Nkyoku/phoenix-pcb/README.md

# phoenix-pcb
A Main circuit board for the Robocup SSL machine

[Schematics](Schematics.pdf)  
[Firmware](https://github.com/Nkyoku/phoenix-firmware)  
[Wiki](https://github.com/Nkyoku/phoenix-pcb/wiki)  
[解説ブログ](https://blankalilio.blogspot.com/2020/11/phoenix_15.html)
