Nkyoku/phoenix-pcb/Schematics.pdf

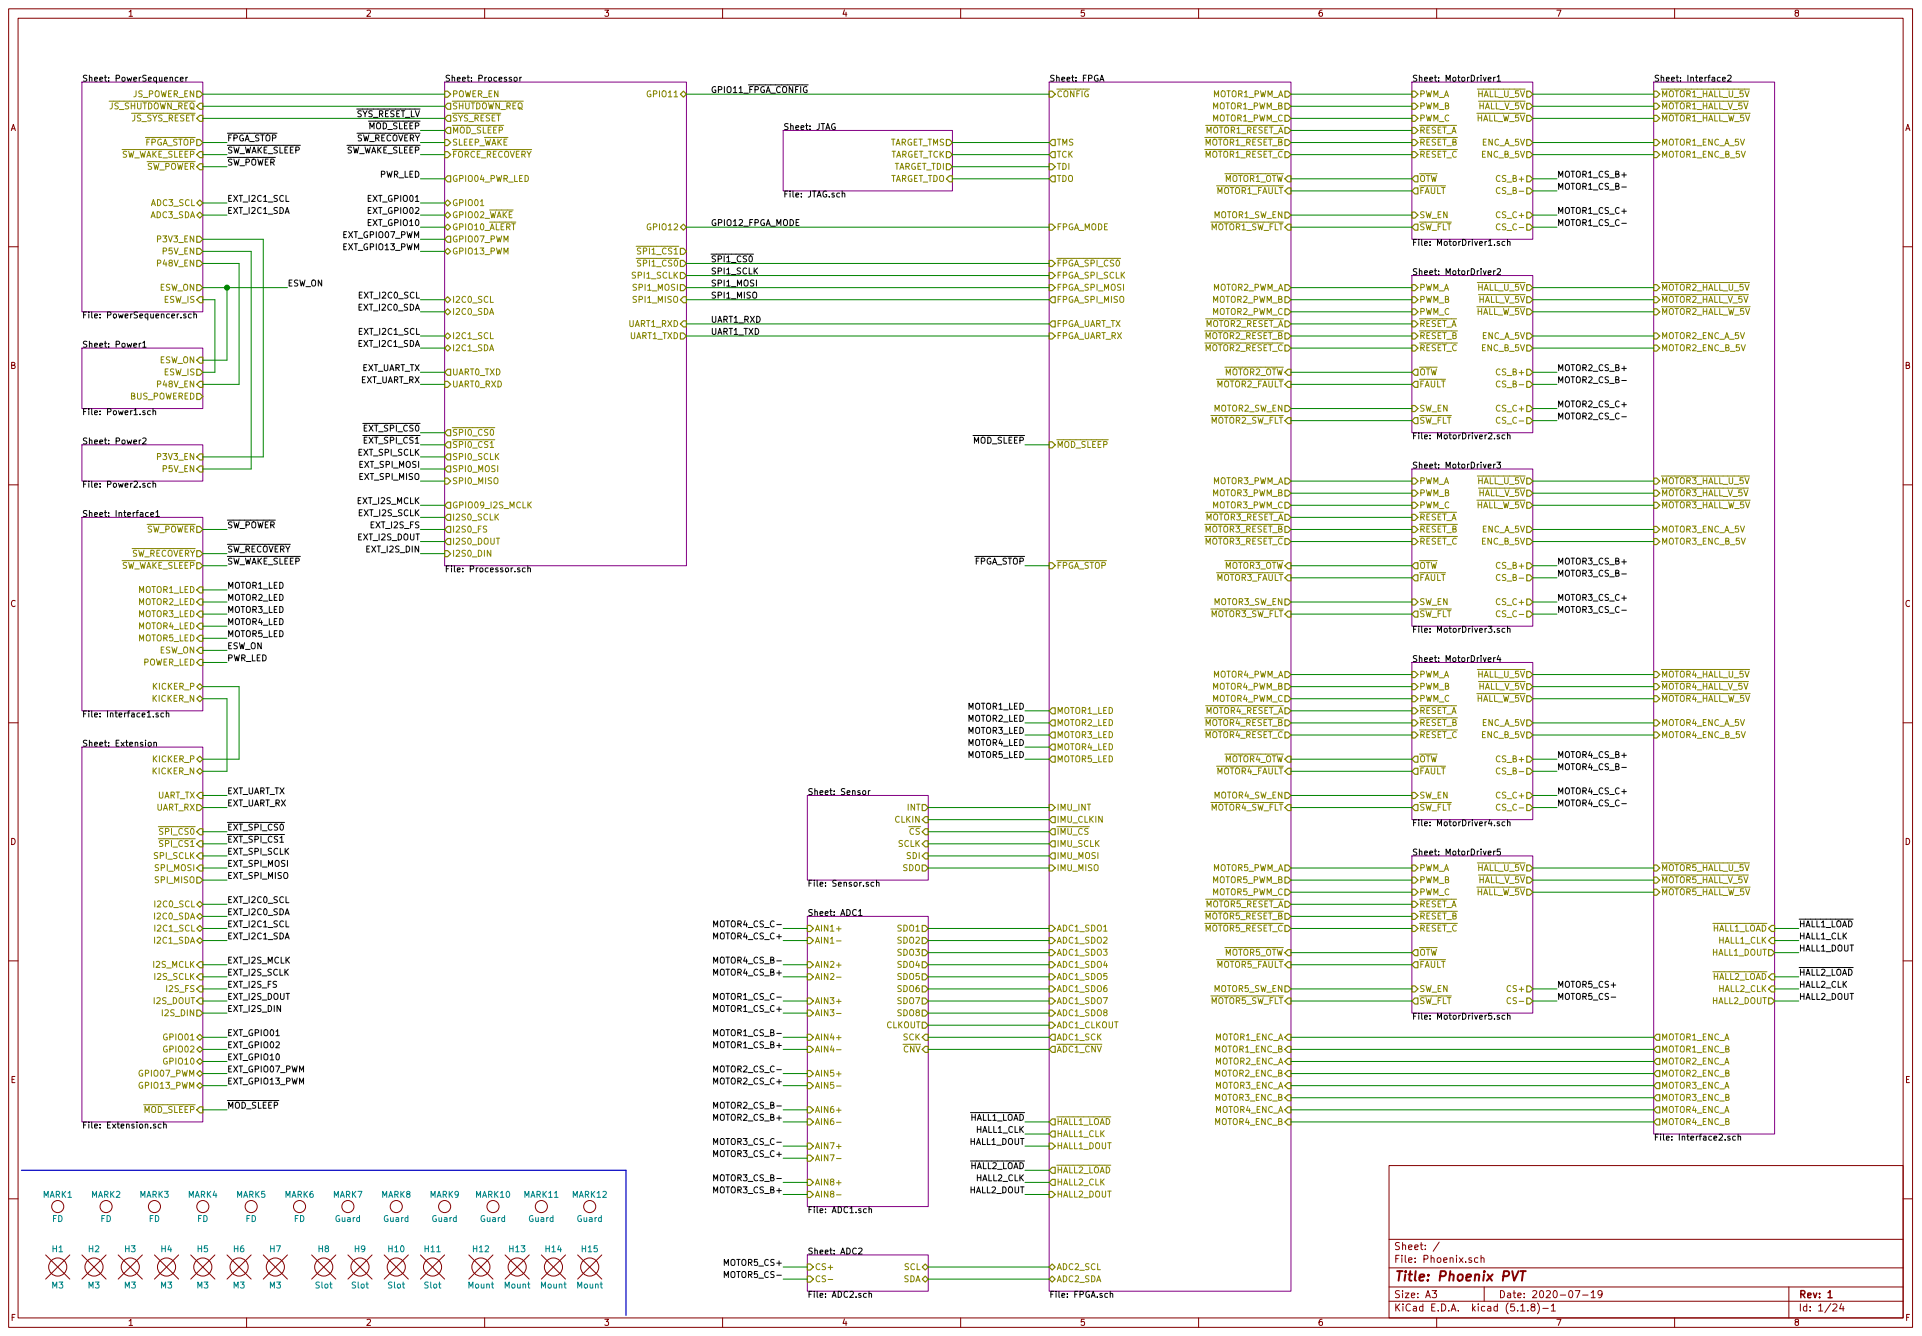
[picture p1: page 1]

File: Phoenix.sch Sheet: /
Id: 1/24 Title: Phoenix PVT

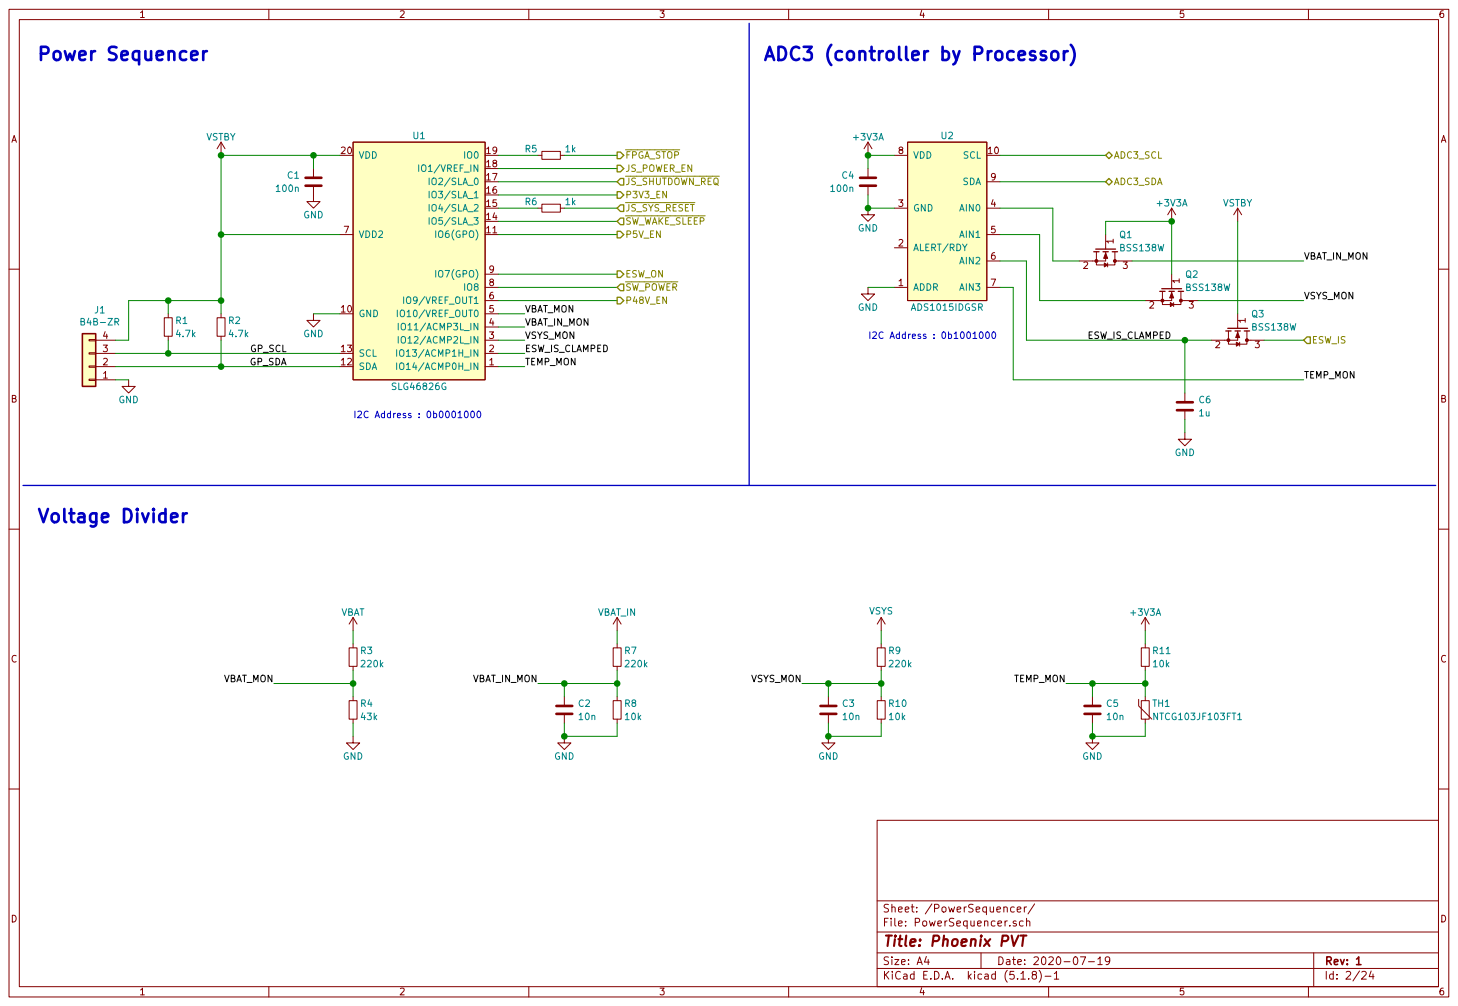
[picture p2: page 2]

File: PowerSequencer.sch
Id: 2/24 Title: Phoenix PVT

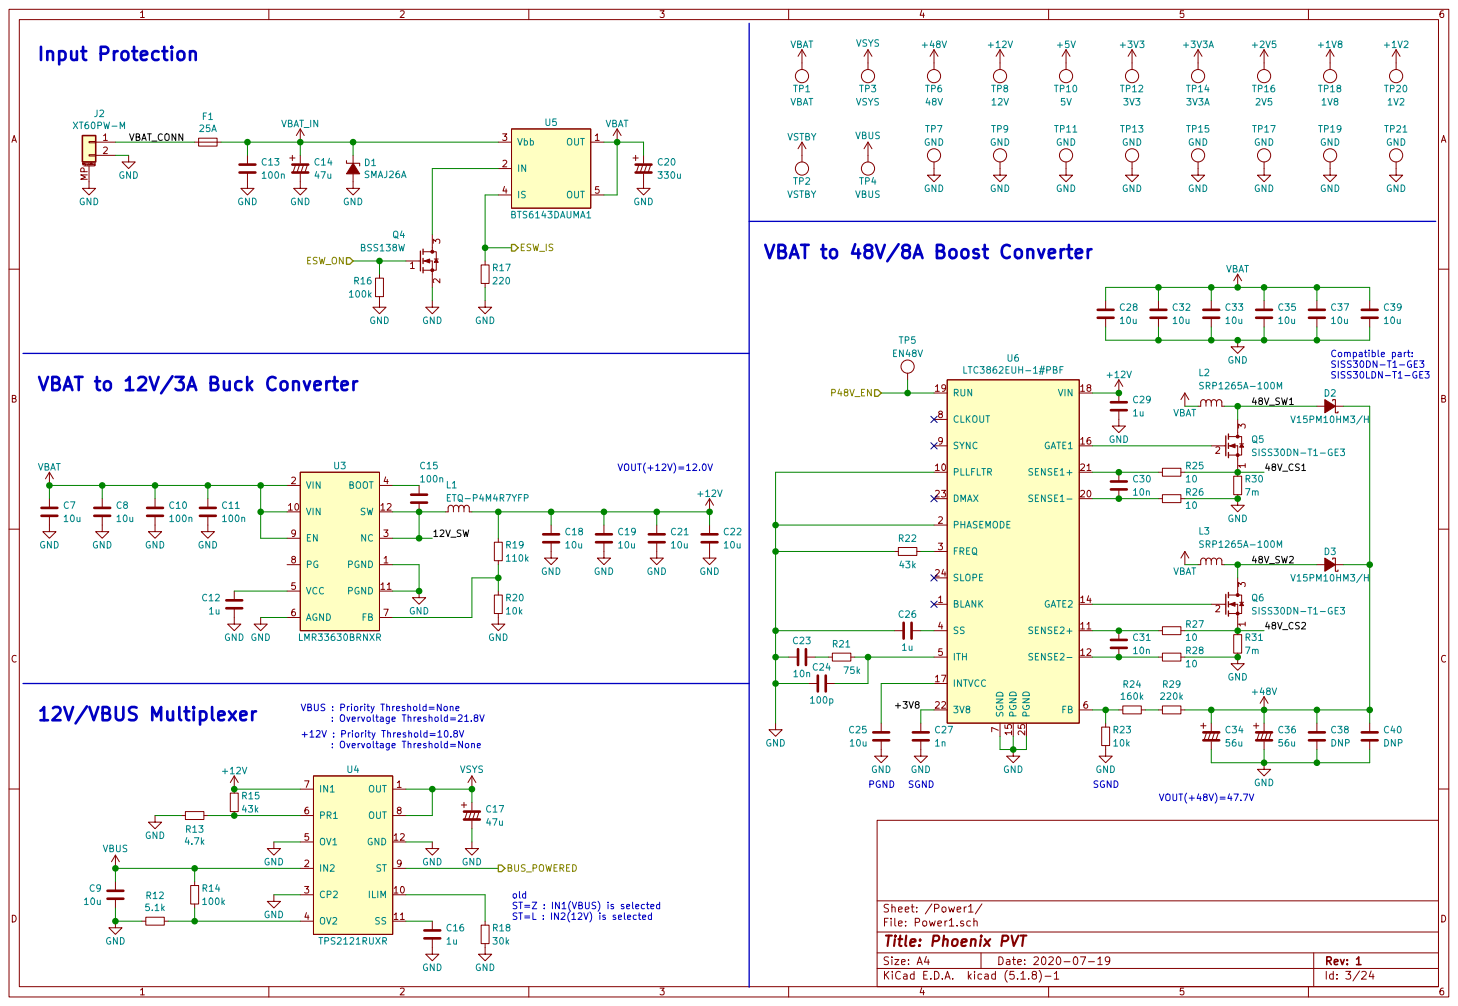
[picture p3: page 3]

Compatible part: SISS30DN-T1-GE3 SISS30LDN-T1-GE3 Input Protection

48V_SW1 SGND VBAT to 48V/8A Boost Converter

VBAT to 12V/3A Buck Converter

VBUS : Priority Threshold=None
: Overvoltage Threshold=21.8V
+12V : Priority Threshold=10.8V
: Overvoltage Threshold=None

old ST=Z : IN1(VBUS) is selected

File: Power1.sch Sheet: /Power1/
Id: 3/24 Title: Phoenix PVT

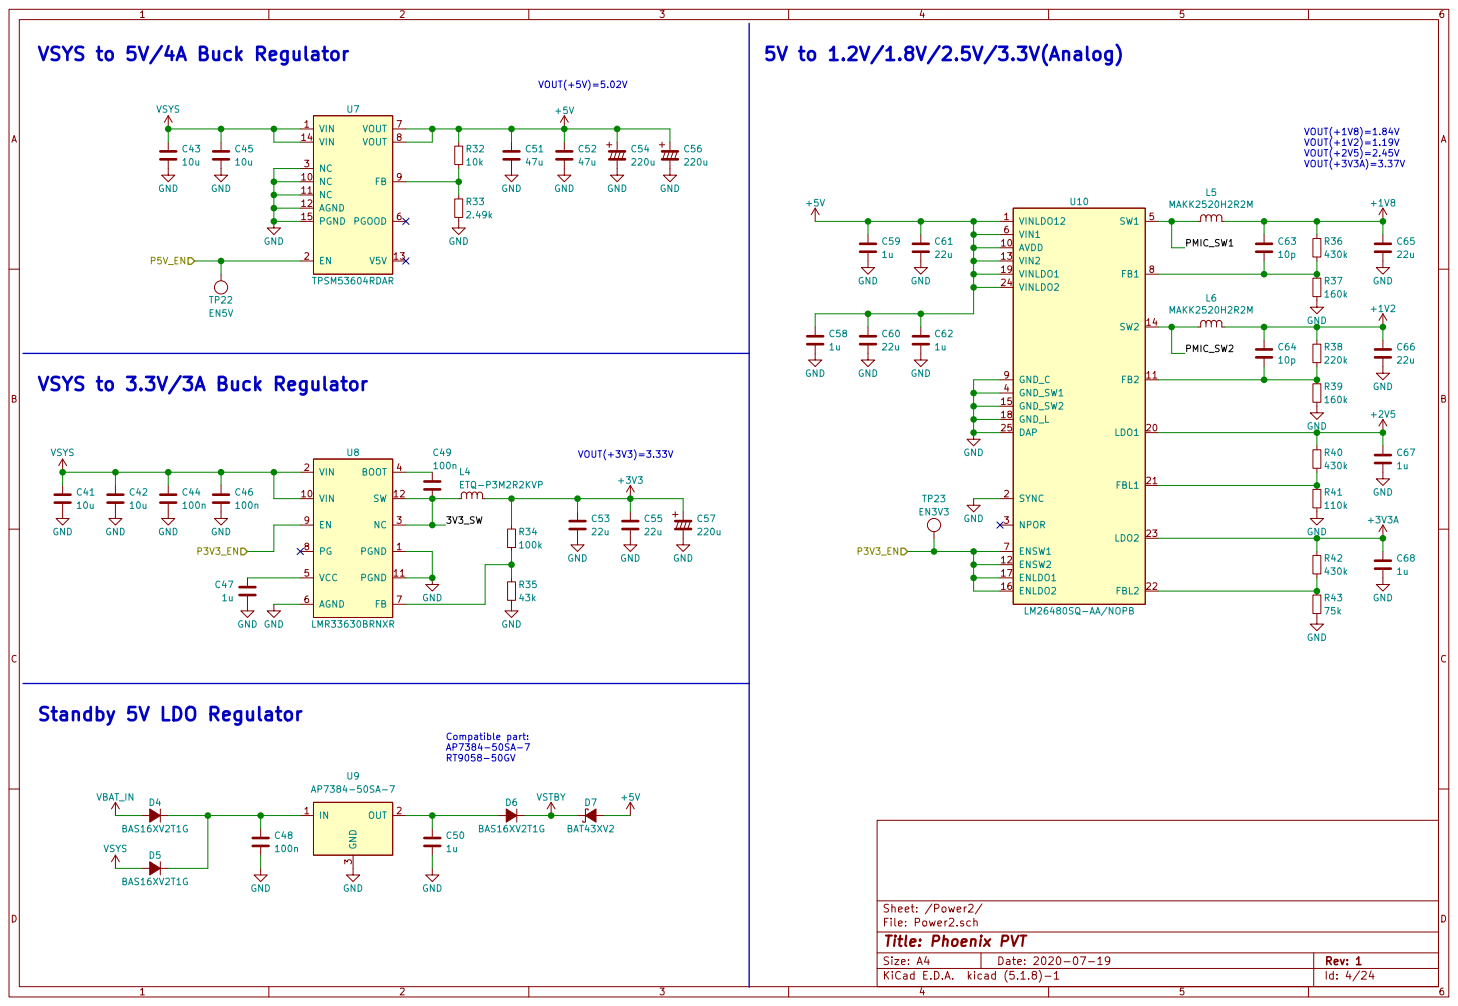
[picture p4: page 4]

VSYS to 5V/4A Buck Regulator

VSYS to 3.3V/3A Buck Regulator

Compatible part: AP7384-50SA-7 RT9058-50GV Standby 5V LDO Regulator

Id: 4/24 Title: Phoenix PVT

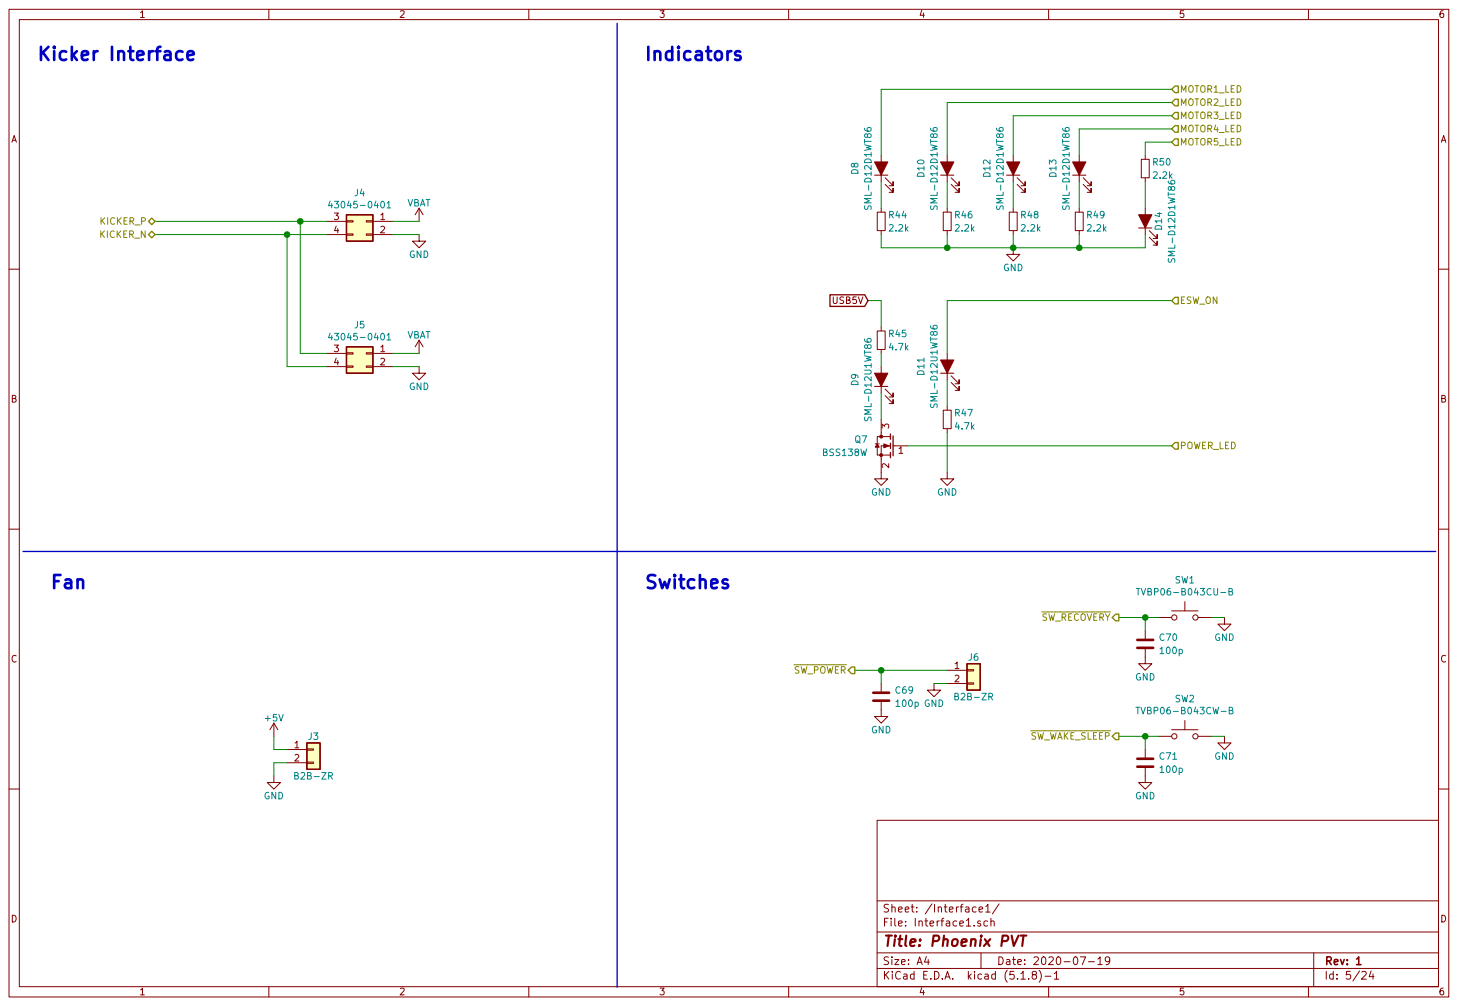
[picture p5: page 5]

Id: 5/24 Title: Phoenix PVT

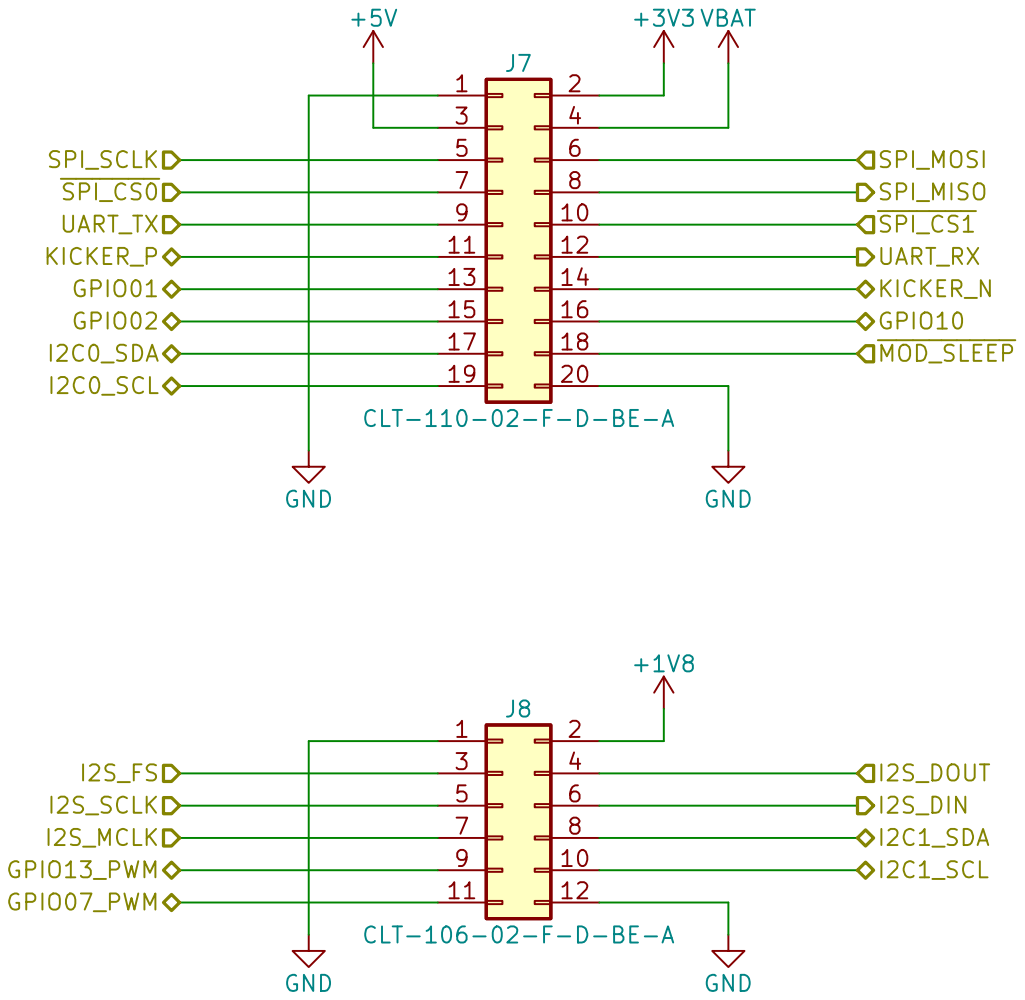
[picture p6: page 6]

Id: 6/24 Title: Phoenix PVT

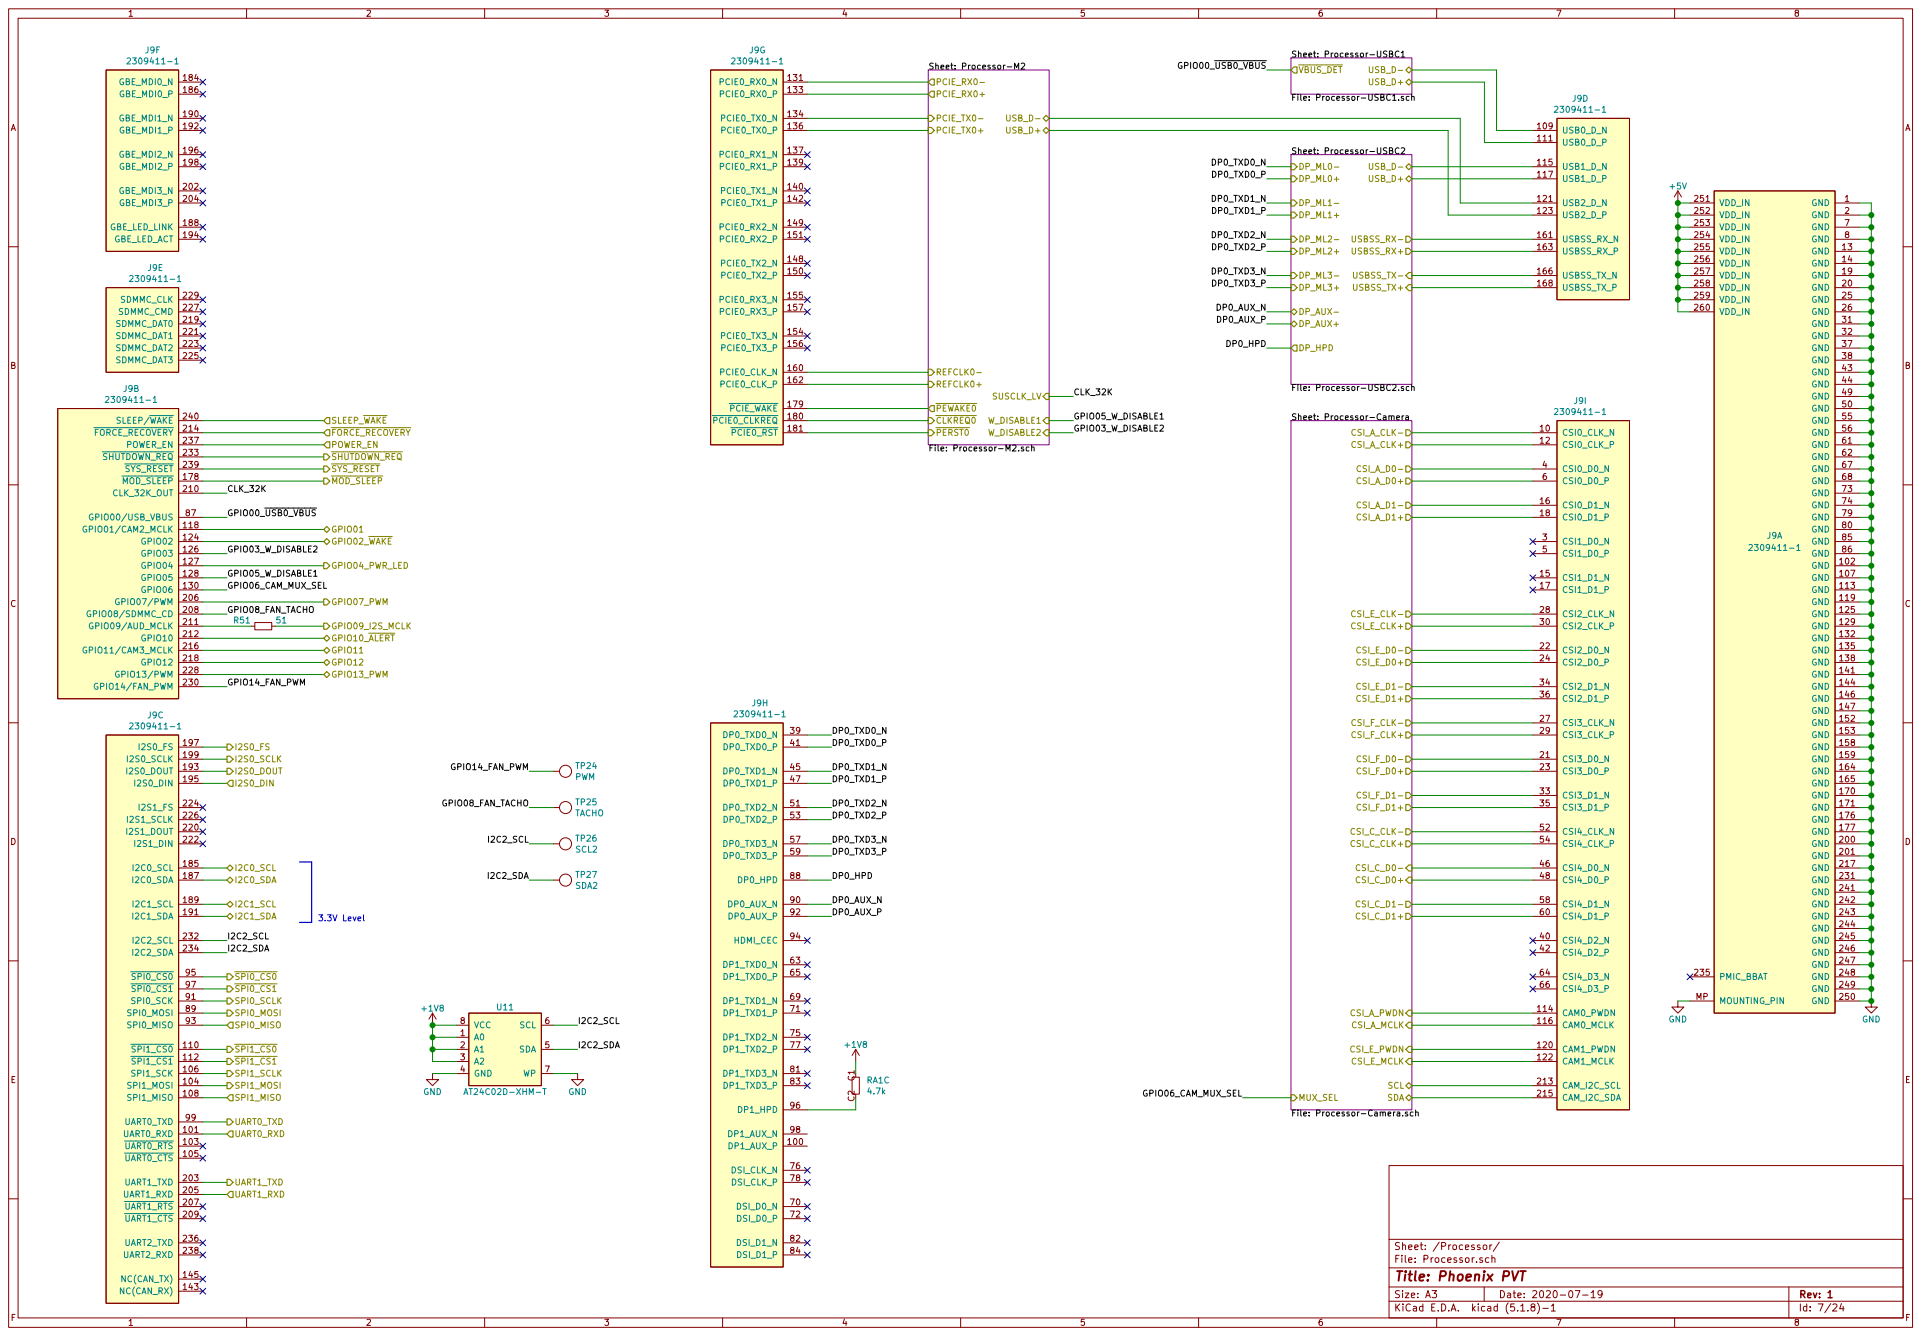
[picture p7: page 7]

File: Processor-Camera.sch

File: Processor.sch Sheet: /Processor/
Id: 7/24 Title: Phoenix PVT

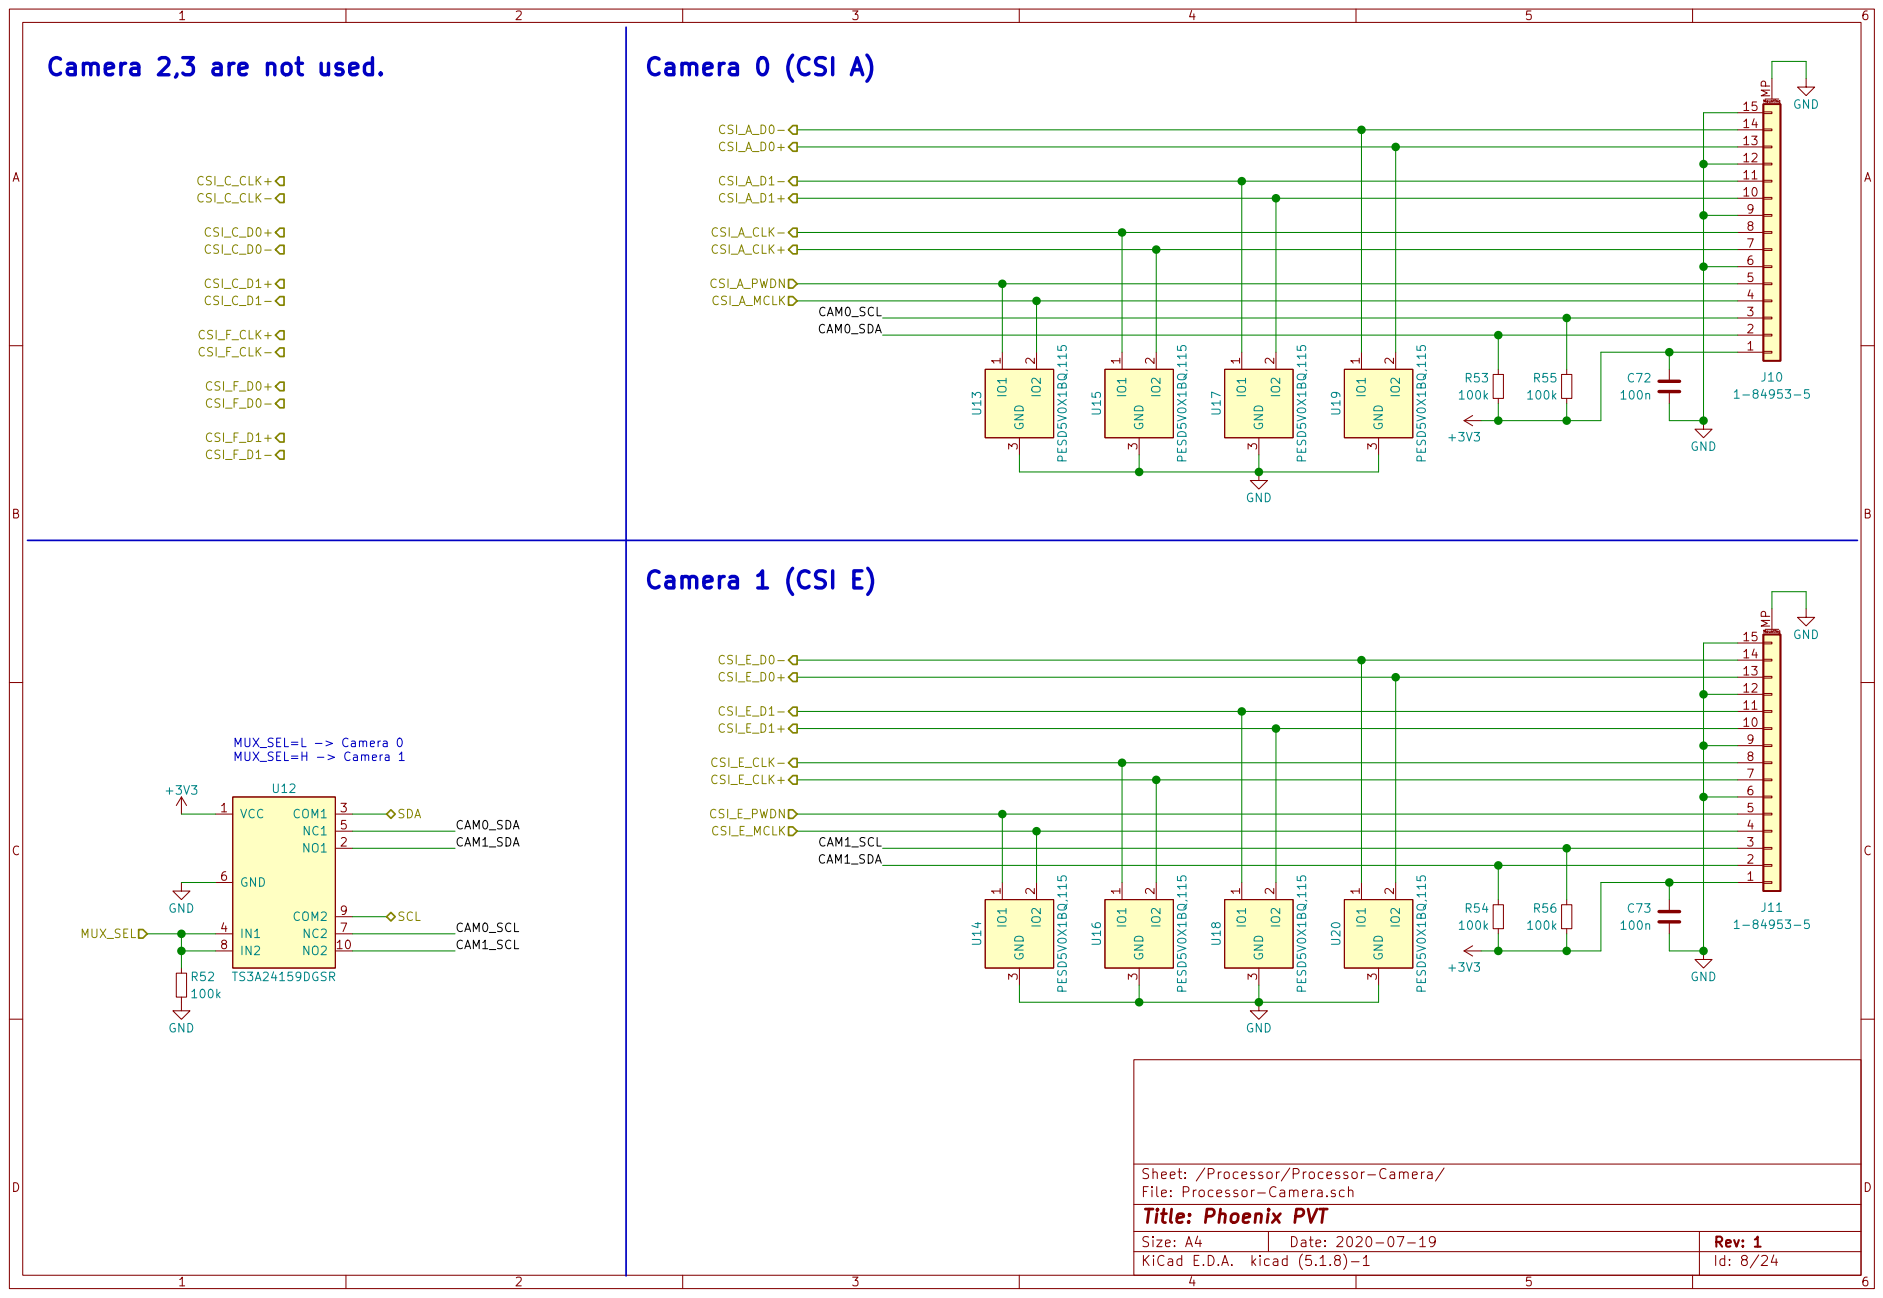
[picture p8: page 8]

File: Processor-Camera.sch Sheet: /Processor/Processor-Camera/
Id: 8/24 Title: Phoenix PVT

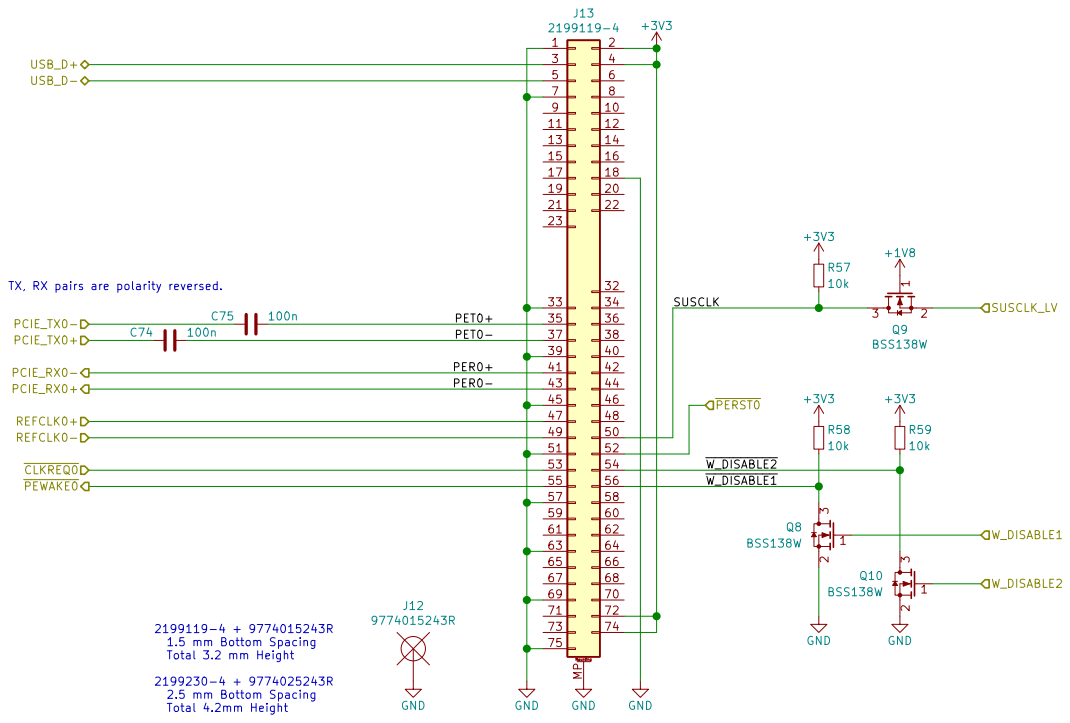
[picture p9: page 9]

35 | | 36
37 | | 38
39 | | 40

53 55 57 | 54
56
58

71 73 75 | 72
74

Id: 9/24 Title: Phoenix PVT

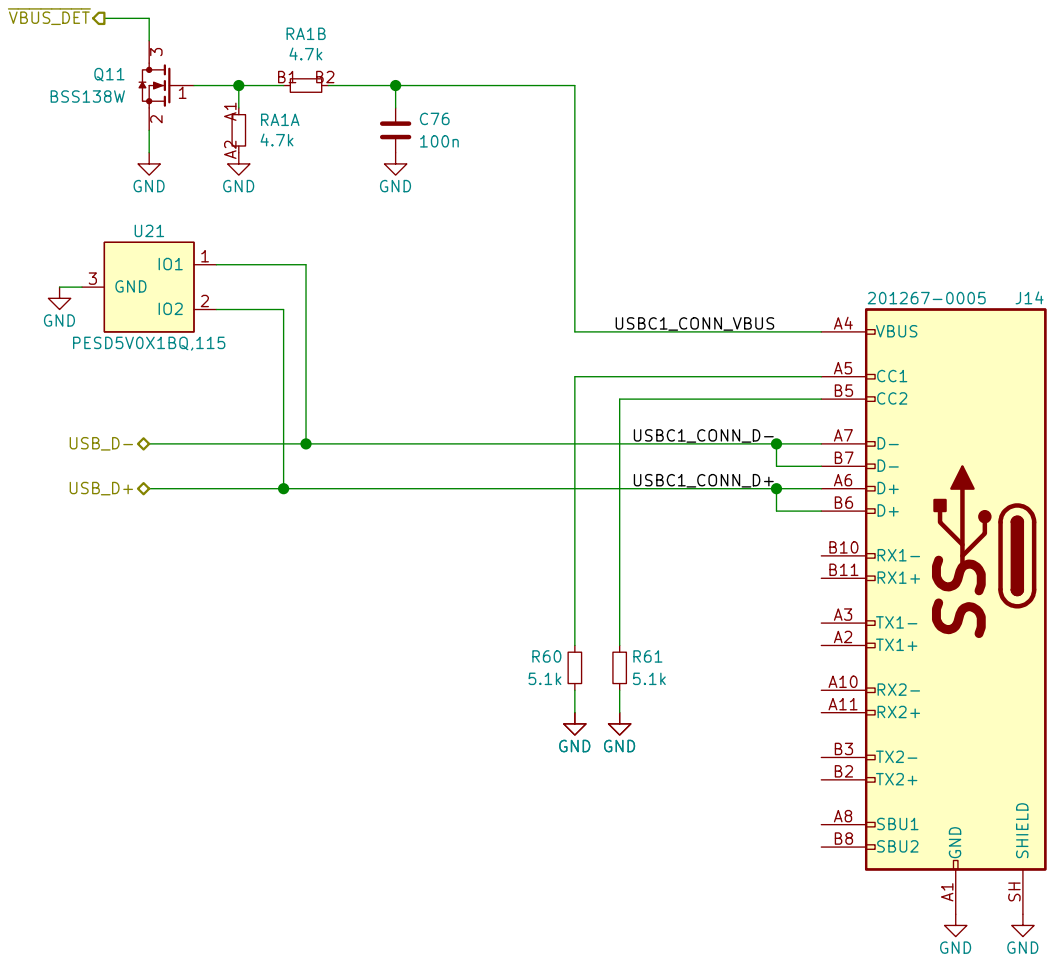
[picture p10: page 10]

File: Processor-USBC1.sch Sheet: /Processor/Processor-USBC1/
Id: 10/24 Title: Phoenix PVT

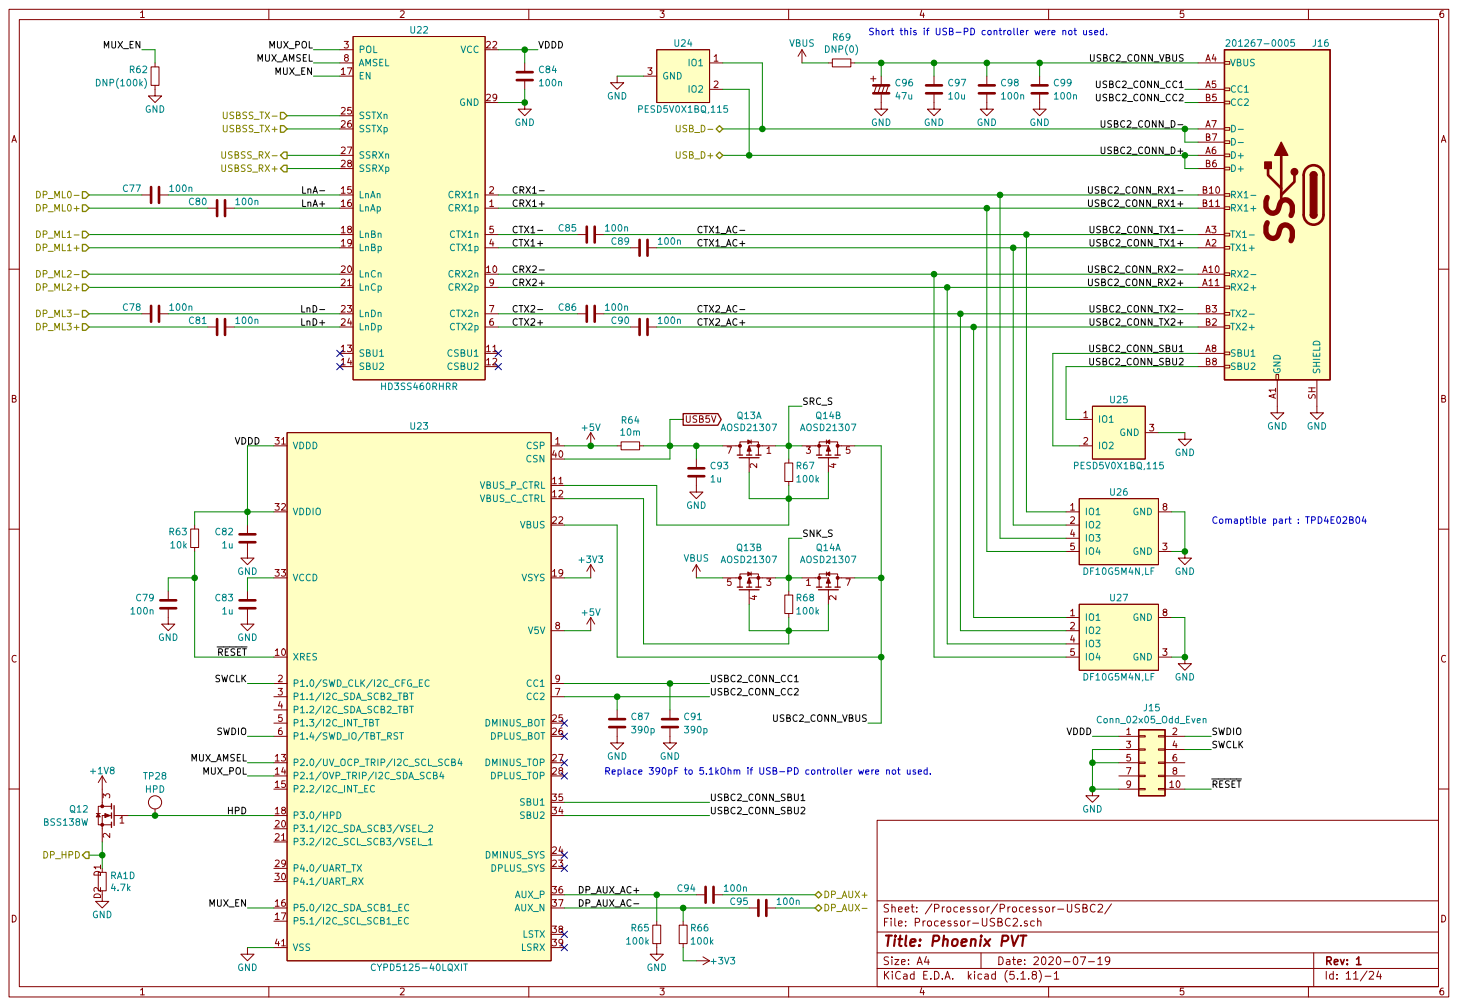
[picture p11: page 11]

Short this if USB-PD controller were not used.

File: Processor-USBC2.sch Sheet: /Processor/Processor-USBC2/ R68

Replace 390pF to 5.1kOhm if USB-PD controller were not used.

Id: 11/24 Title: Phoenix PVT

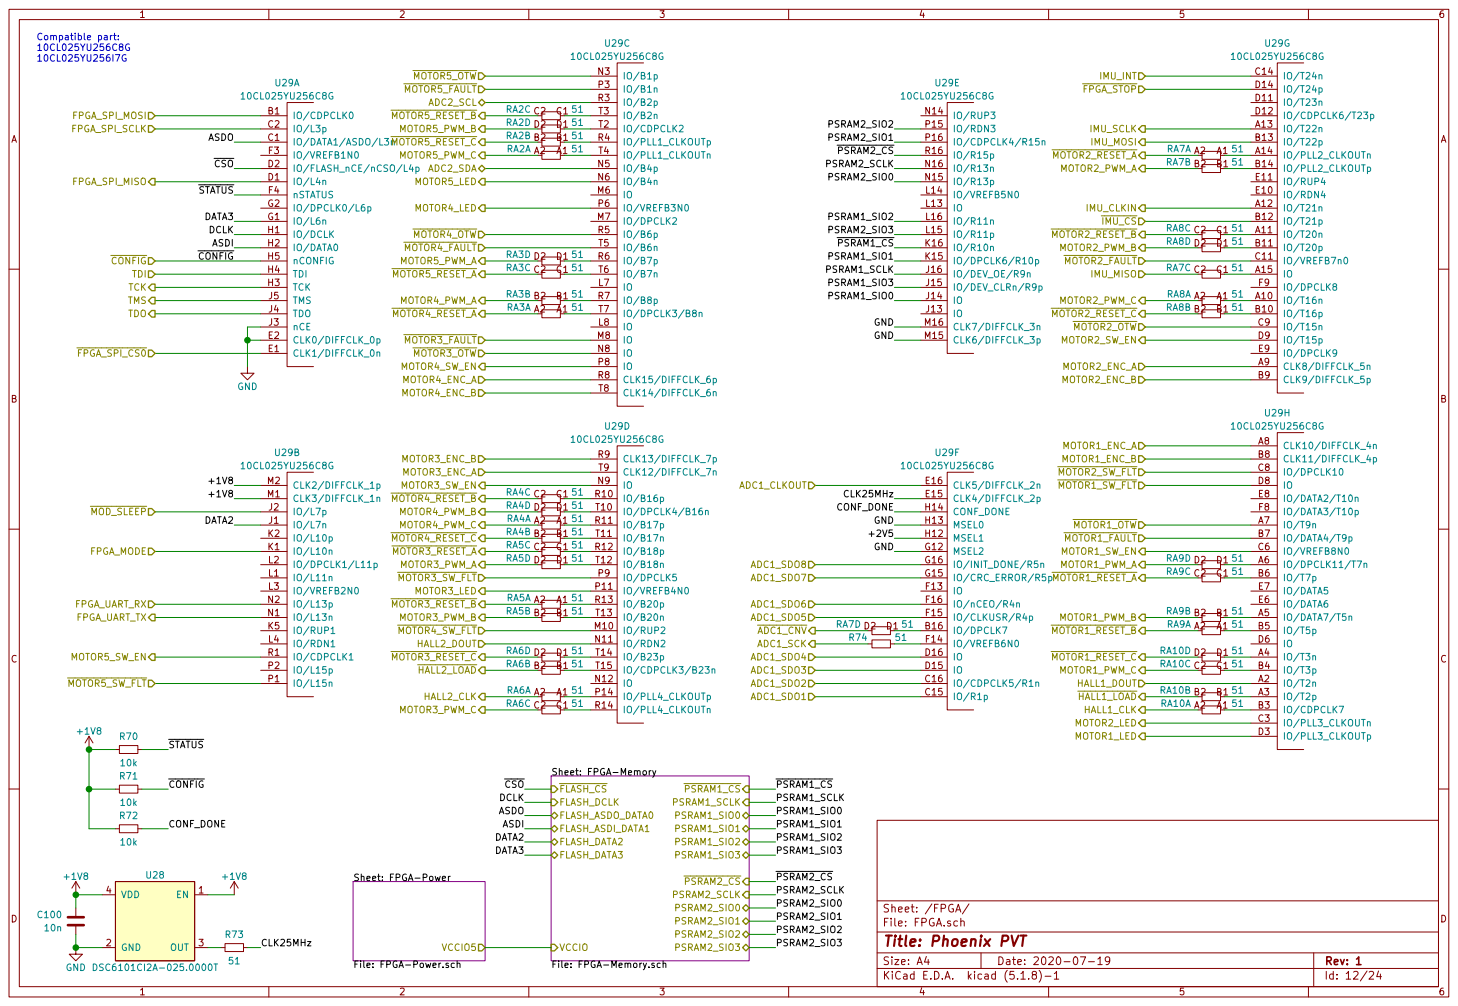
[picture p12: page 12]

File: FPGA.sch Sheet: /FPGA/ Sheet: FPGA-Memory
File: FPGA-Memory.sch FLASH_CS
FLASH_DCLK

Id: 12/24 Title: Phoenix PVT

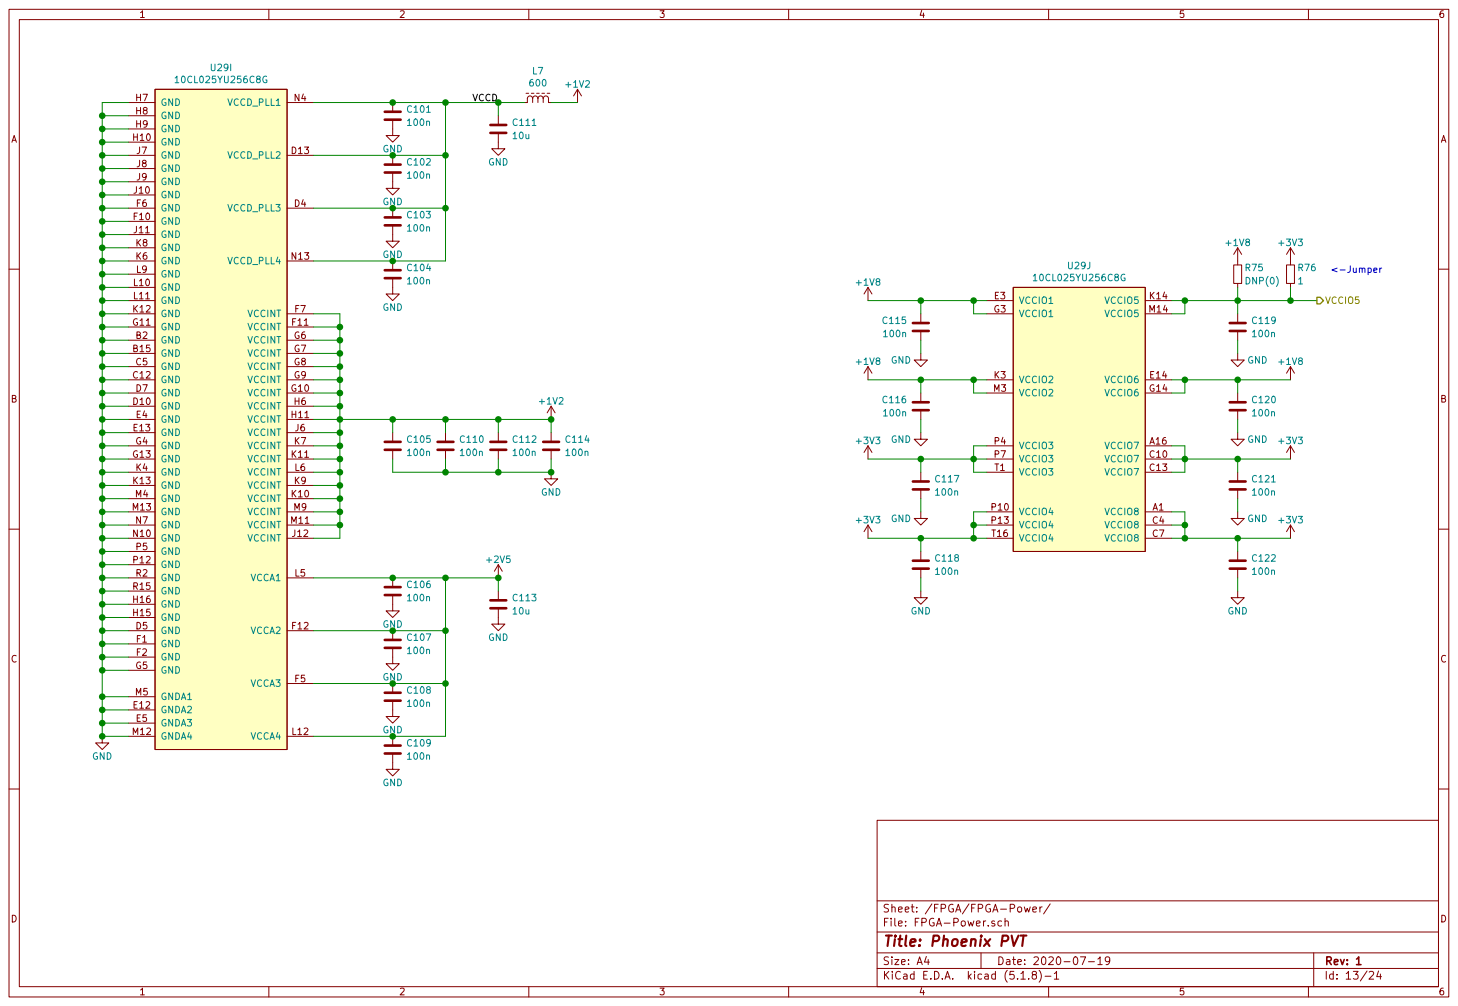
[picture p13: page 13]

File: FPGA-Power.sch Sheet: /FPGA/FPGA-Power/
Id: 13/24 Title: Phoenix PVT

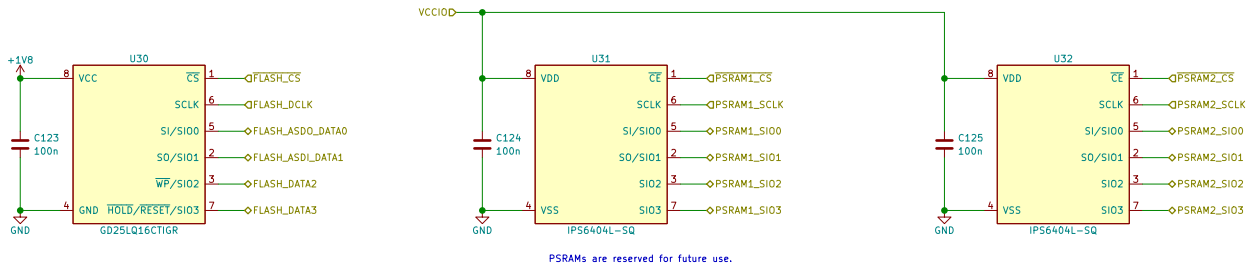
[picture p14: page 14]

Sheet: /FPGA/FPGA-Memory/ C124

PSRAM2_SIO0 PSRAM2_SIO1 PSRAM2_SIO2 PSRAM2_SIO3 PSRAMs are reserved for future use.

File: FPGA-Memory.sch
Id: 14/24 Title: Phoenix PVT

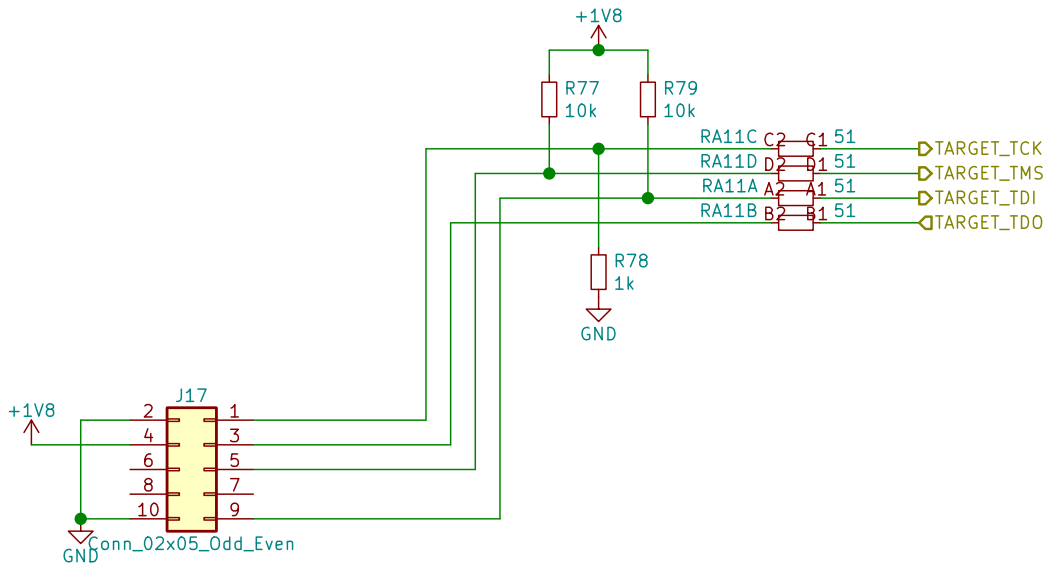
[picture p15: page 15]

File: JTAG.sch Sheet: /JTAG/
Id: 15/24 Title: Phoenix PVT

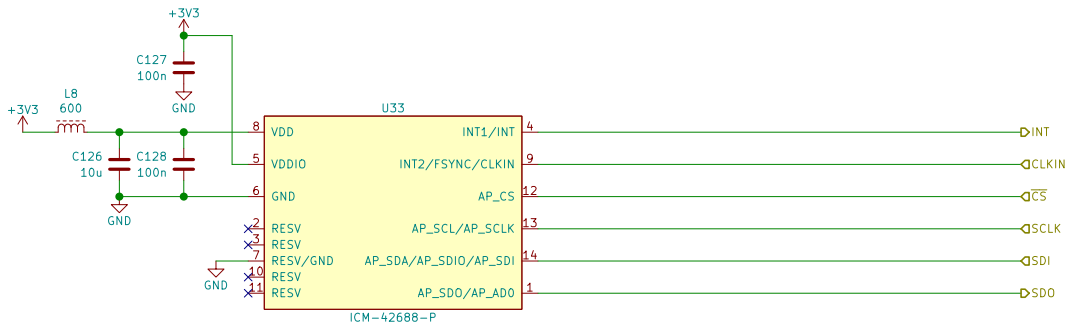
[picture p16: page 16]

File: Sensor.sch Sheet: /Sensor/
Id: 16/24 Title: Phoenix PVT

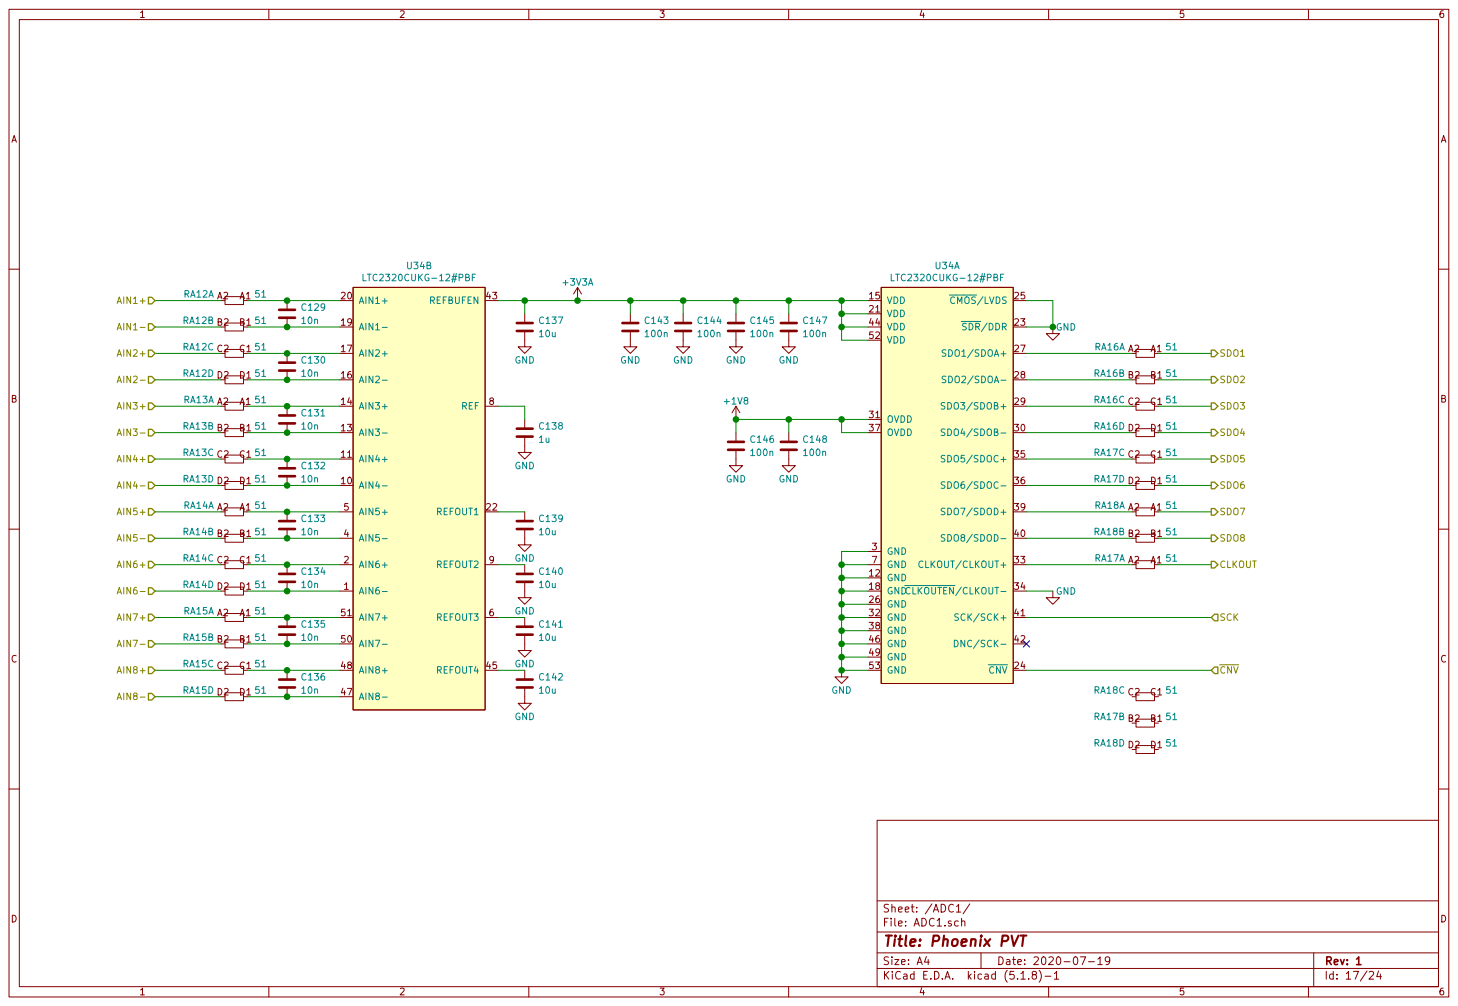
[picture p17: page 17]

File: ADC1.sch Sheet: /ADC1/
Id: 17/24 Title: Phoenix PVT

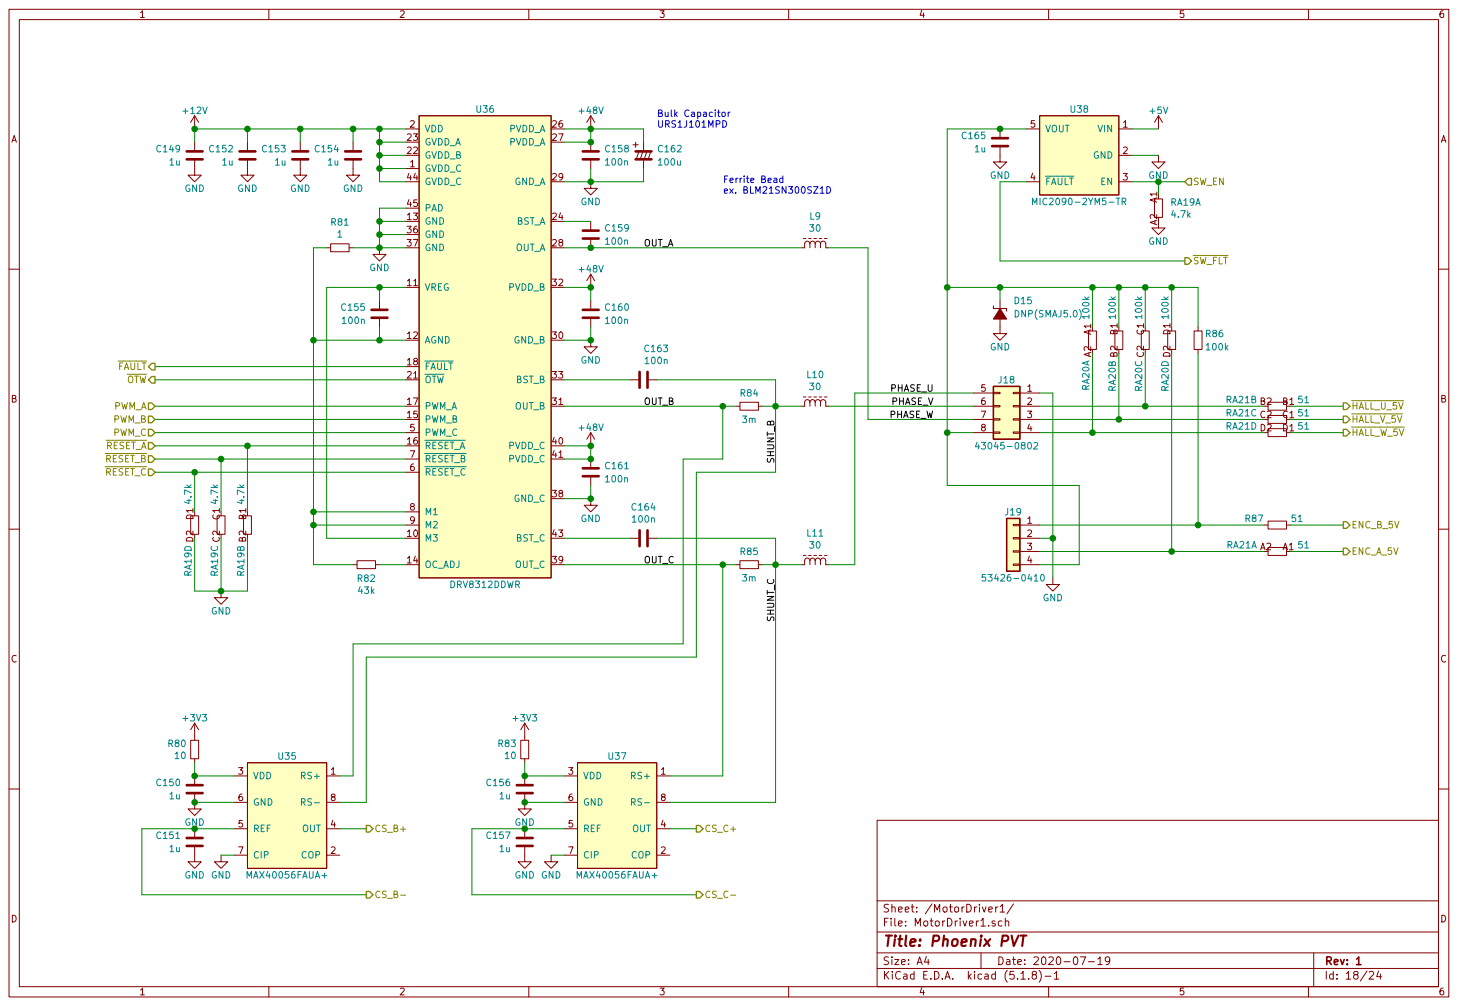
[picture p18: page 18]

PHASE_V | 6 7 | 2

Id: 18/24 Title: Phoenix PVT

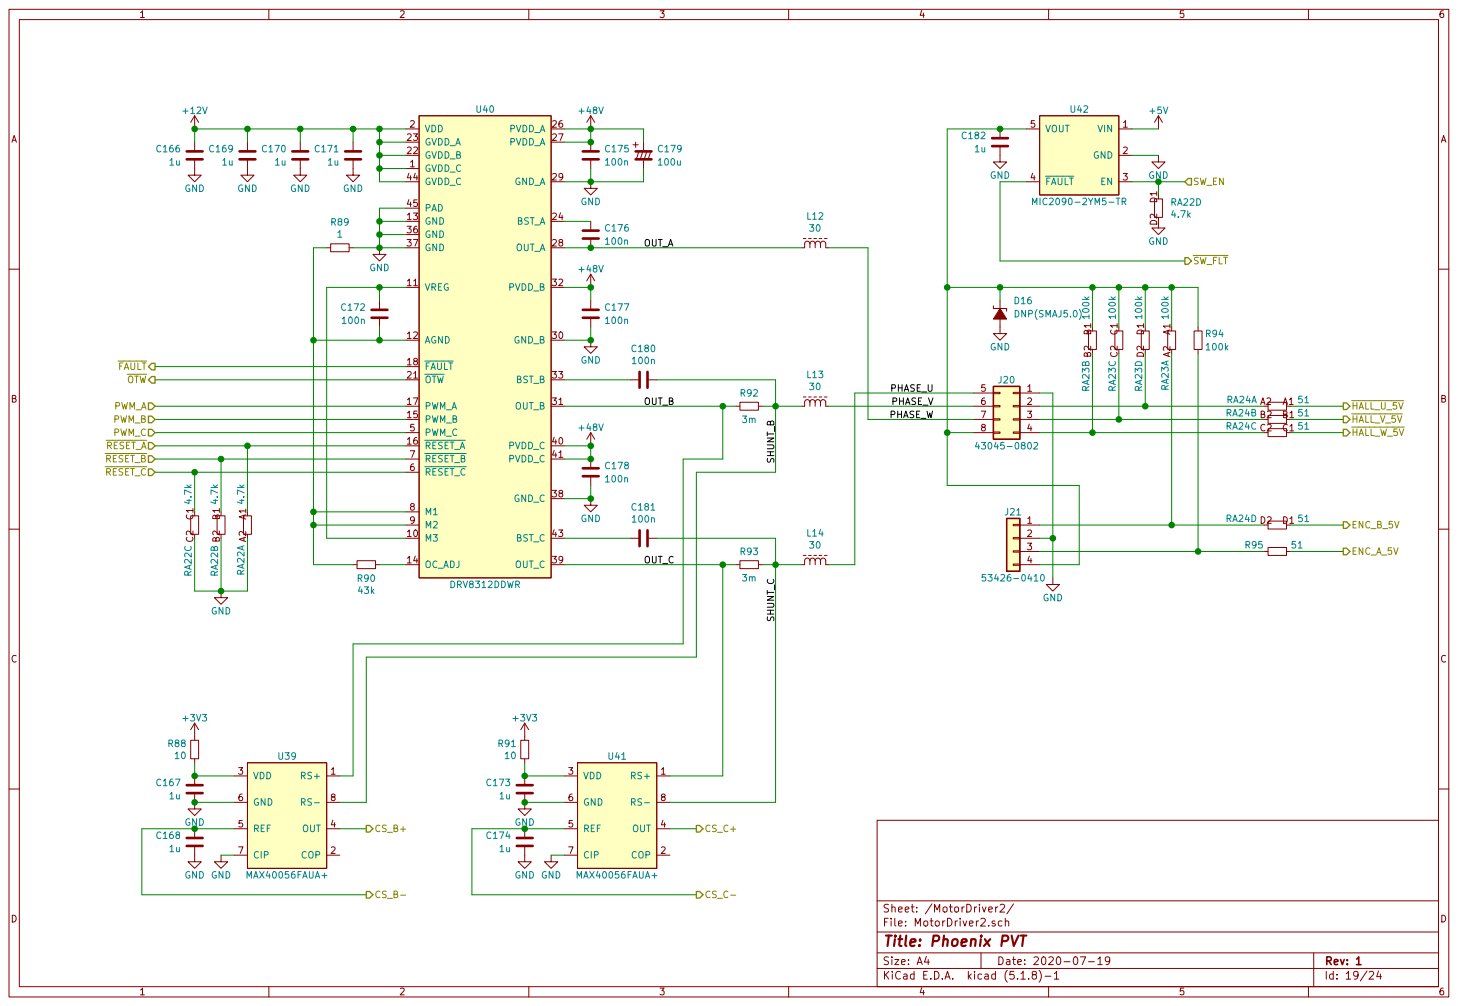
[picture p19: page 19]

PHASE_V PHASE_W | 6 7 | 2

File: MotorDriver2.sch Sheet: /MotorDriver2/
Id: 19/24 Title: Phoenix PVT

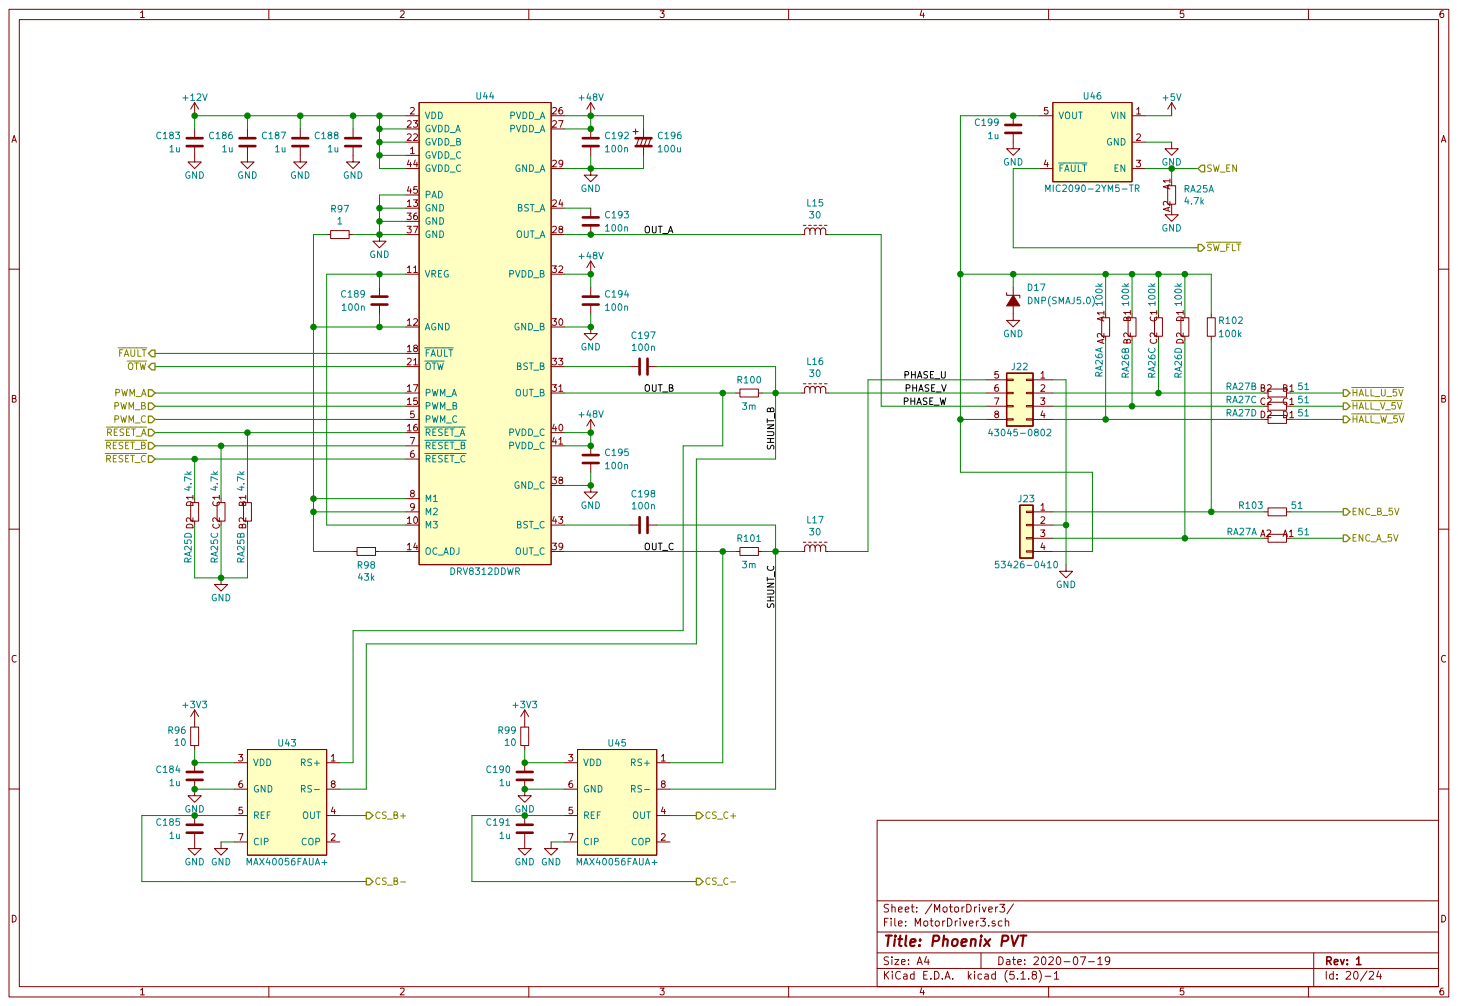
[picture p20: page 20]

PHASE_V | 6 7 | 2

File: MotorDriver3.sch Sheet: /MotorDriver3/
Id: 20/24 Title: Phoenix PVT

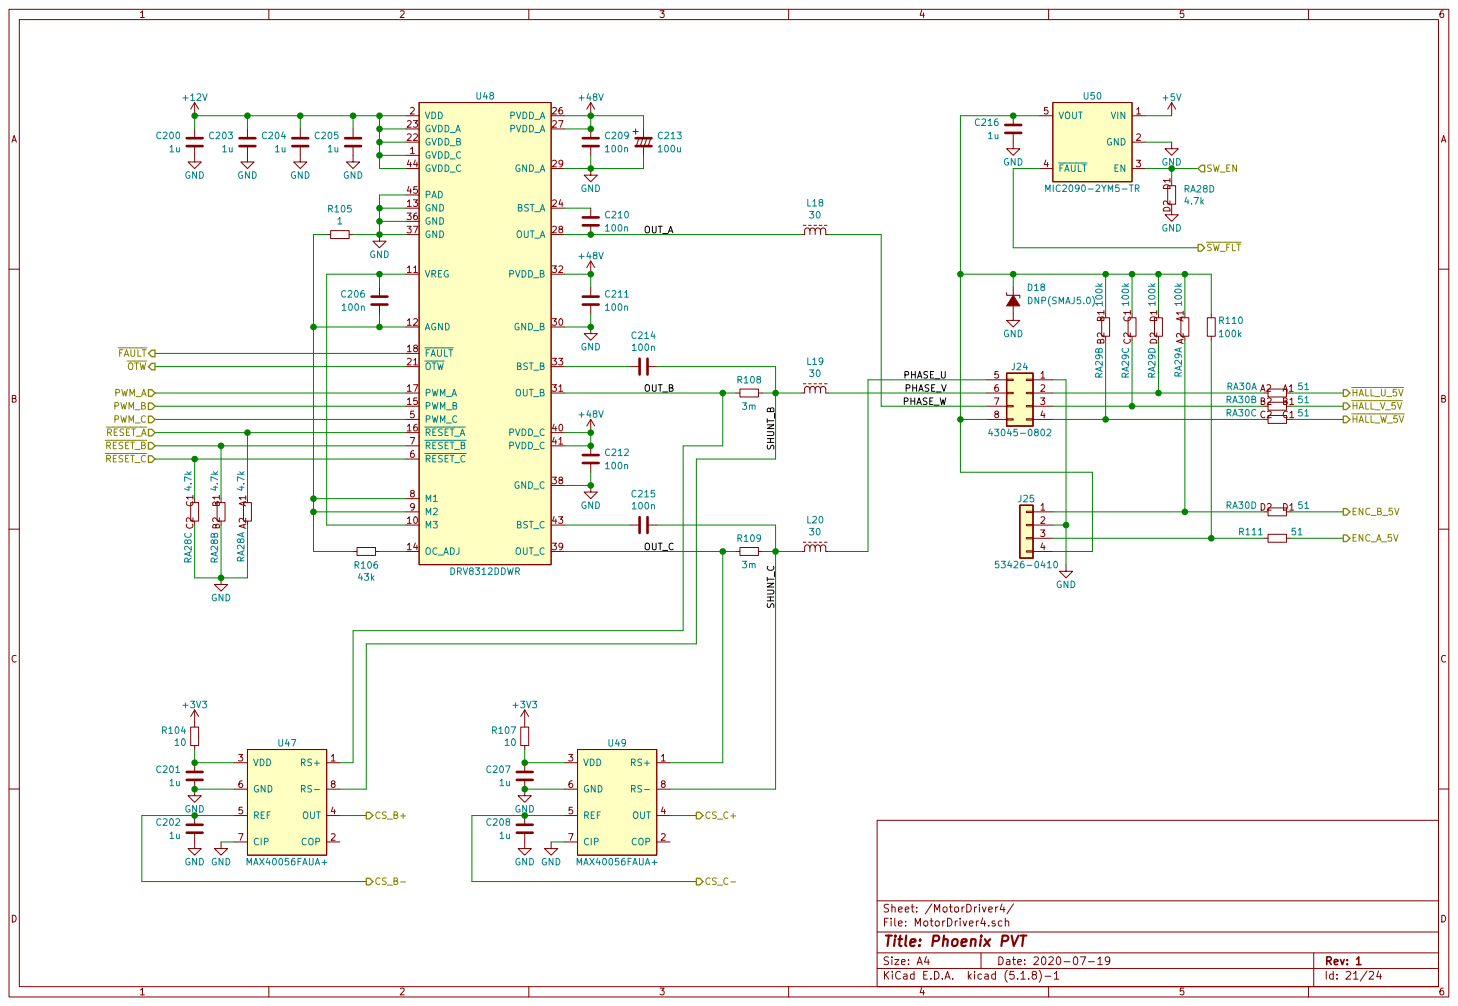
[picture p21: page 21]

PHASE_V PHASE_W | 6 7 | 2

Id: 21/24 Title: Phoenix PVT

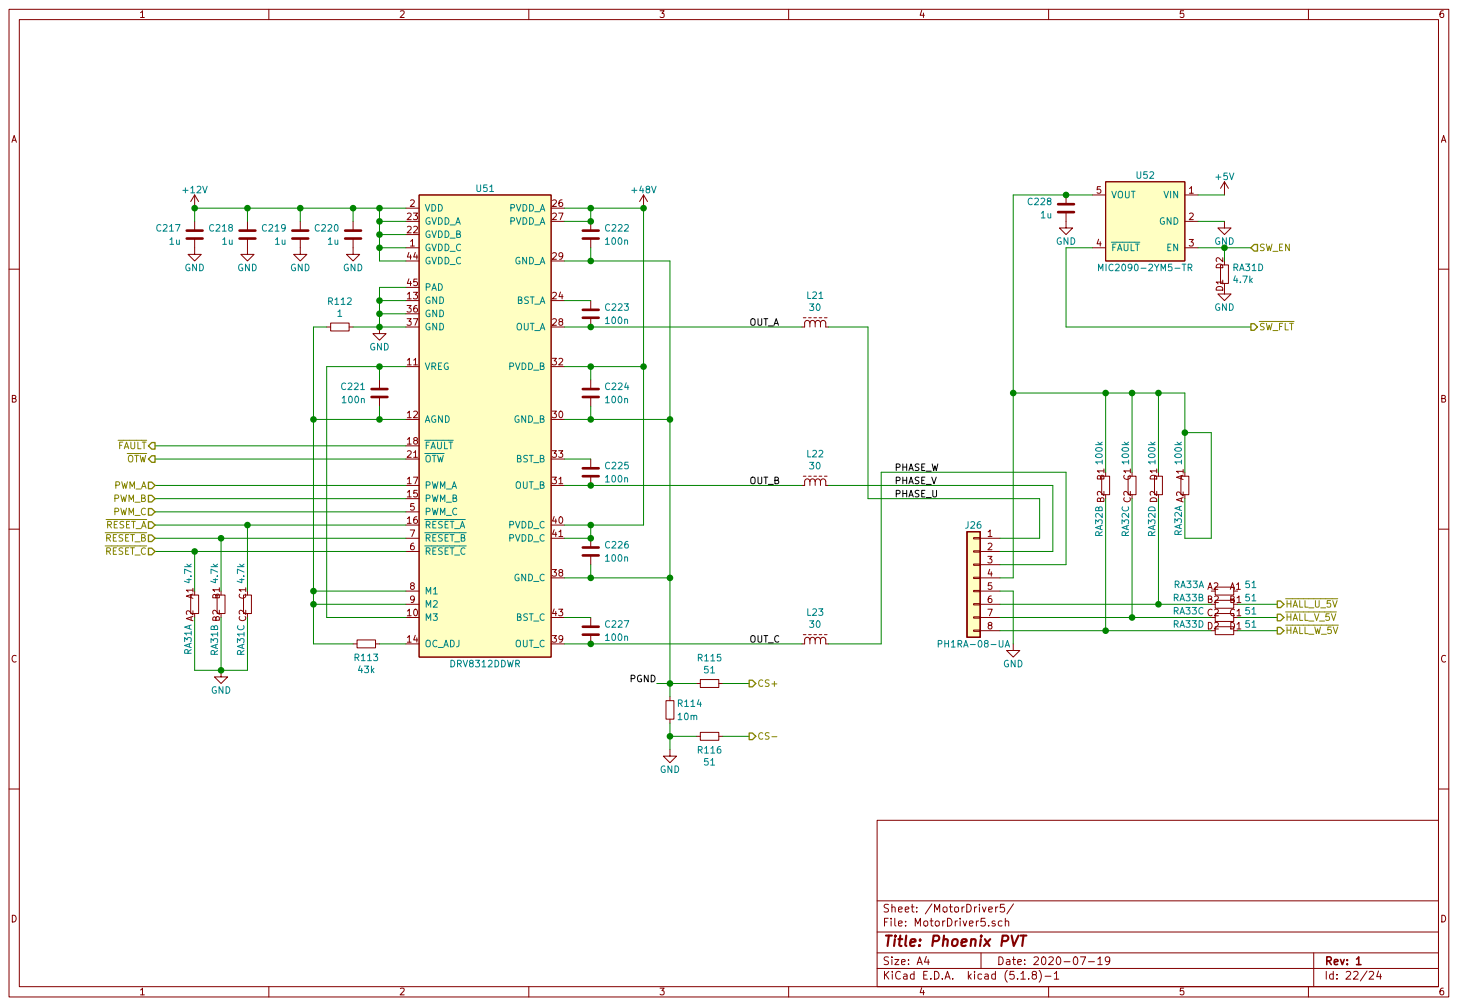
[picture p22: page 22]

File: MotorDriver5.sch Sheet: /MotorDriver5/
Id: 22/24 Title: Phoenix PVT

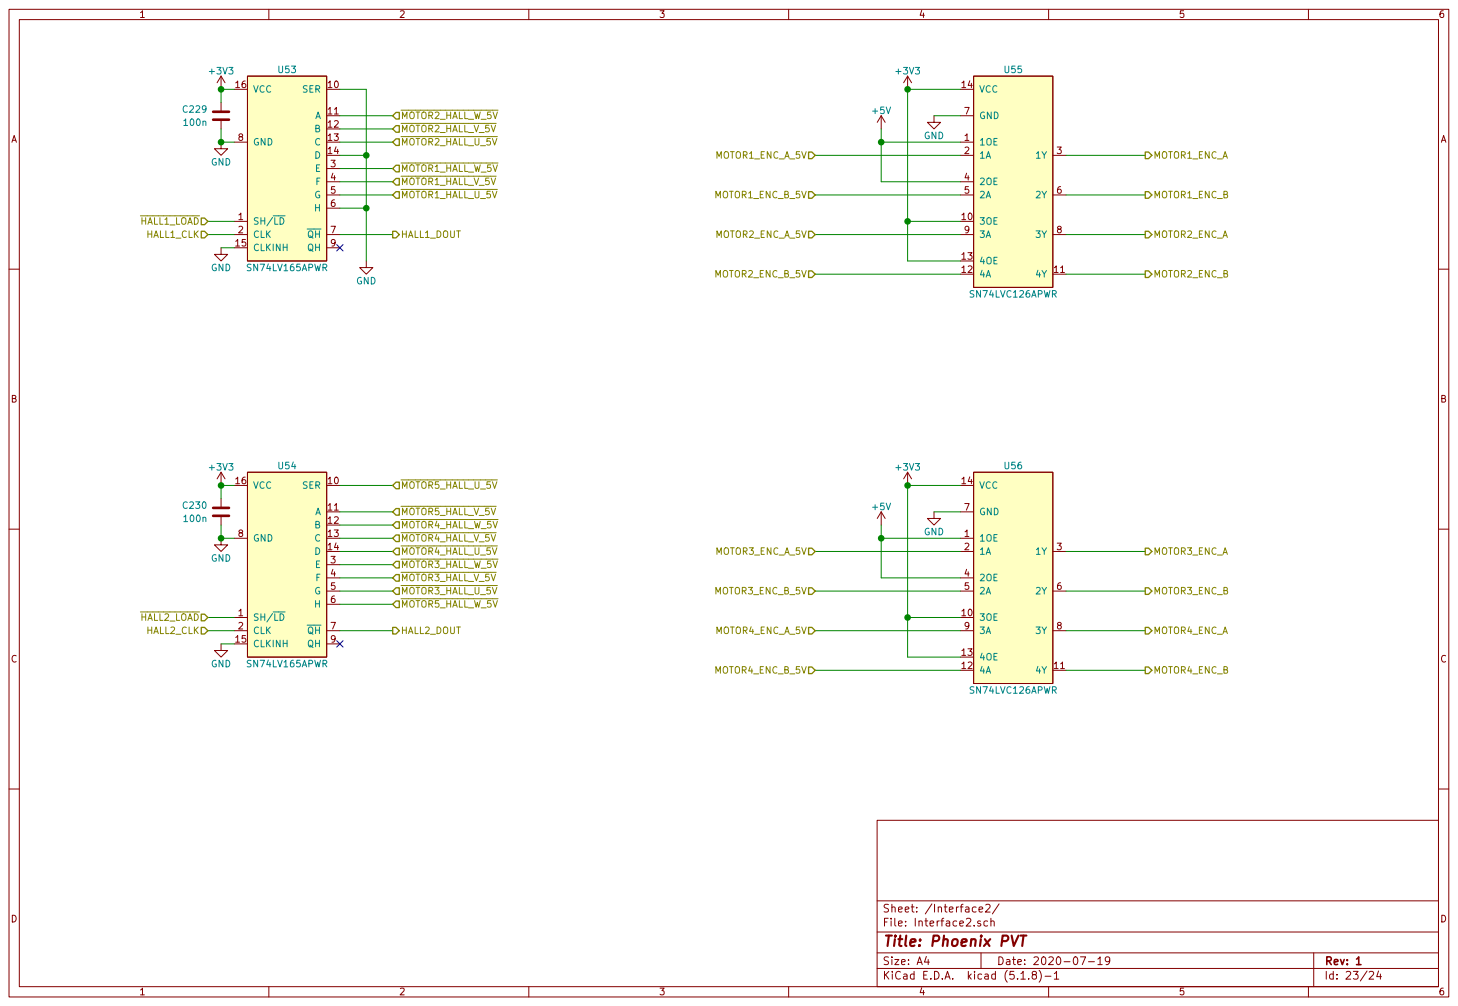
[picture p23: page 23]

File: Interface2.sch Sheet: /Interface2/ GND

Id: 23/24 Title: Phoenix PVT

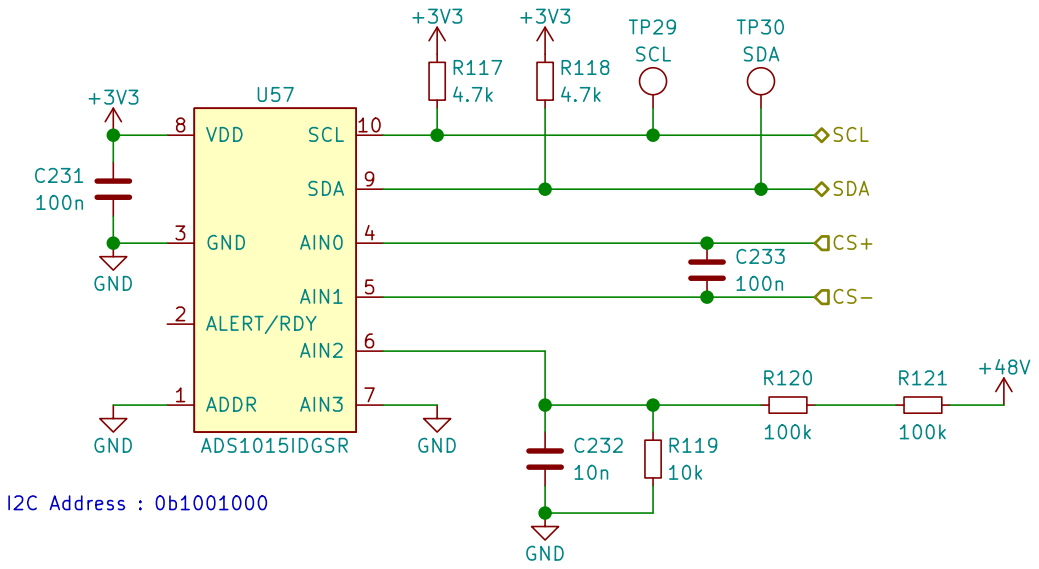
[picture p24: page 24]

CS- SCL CS+ SDA

File: ADC2.sch Sheet: /ADC2/
Id: 24/24 Title: Phoenix PVT
