Nkyoku/phoenix-pcb/ADC1.sch

## KiCad design ADC1.sch (2020-08-01)

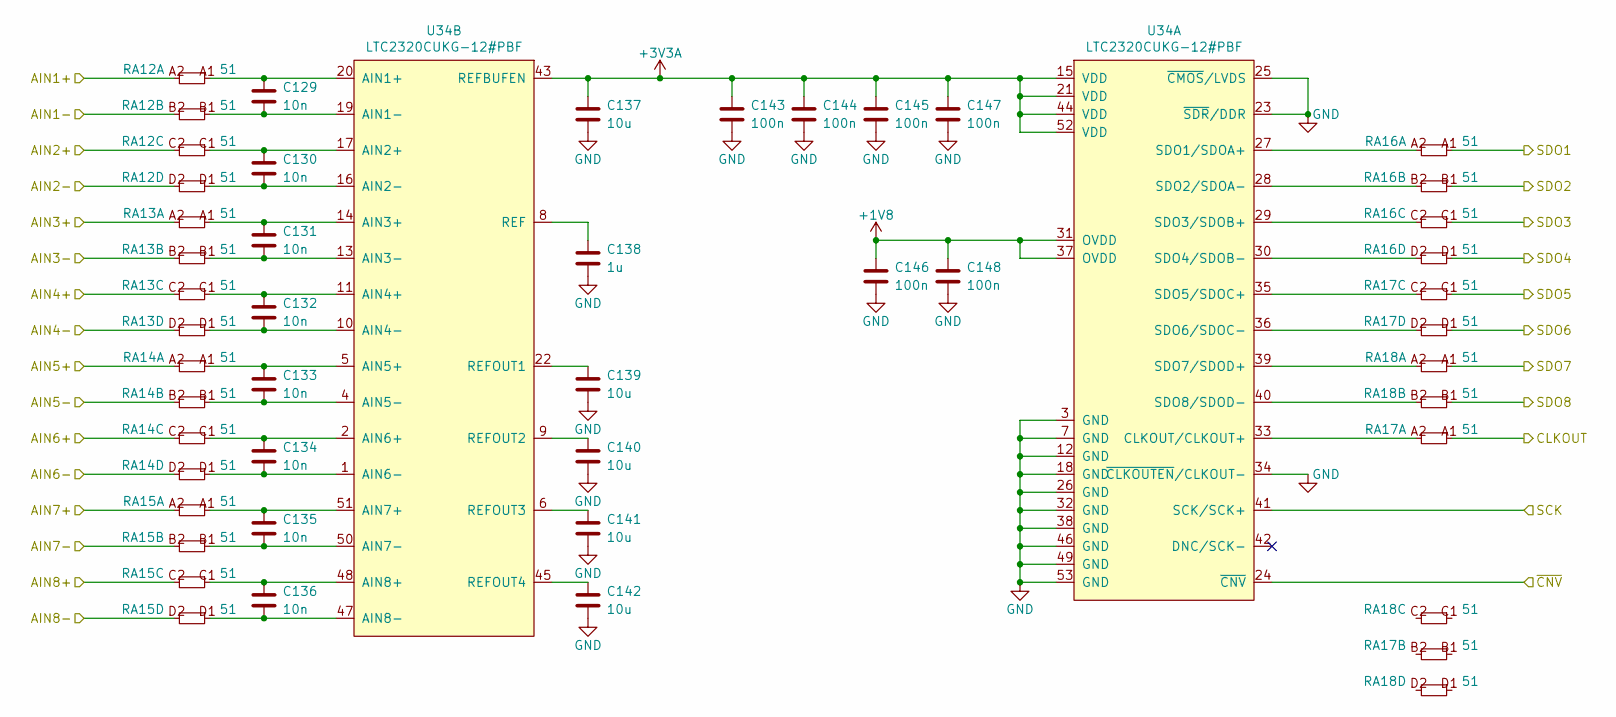
[picture p25: schematic ADC1.sch]

Parts:
C129, C130, C131, C132, C133, C134, C135, C136: 10n; C_CHIP_1005_Hand_NoSilk; PartName GRM155B11E103K
C137, C139, C140, C141, C142: 10u; C_CHIP_1005_Hand_NoSilk; PartName GRJ155R60J106ME11D
C138: 1u; C_CHIP_1005_Hand_NoSilk; PartName TMK105BJ105MV-F
C143, C144, C145, C146, C147, C148: 100n; C_CHIP_1005_Hand_NoSilk; PartName GRM155R71H104ME14D
RA12, RA13, RA14, RA15, RA16, RA17, RA18: 51; R_CHIP_4x1005_CONCAVE; PartName EXB-N8V510JX
U34: LTC2320CUKG-12#PBF; QFN52_7.0x8.0_P0.5_EP5.41x6.45; PartName LTC2320CUKG-12#PBF

Connections:
+1V8: C146.1, C148.1, U34.31 (OVDD), U34.37 (OVDD)
+3V3A: C137.1, C143.1, C144.1, C145.1, C147.1, U34.15 (VDD), U34.21 (VDD), U34.43 (REFBUFEN), U34.44 (VDD), U34.52 (VDD)
AIN1+: RA12.A2
AIN1-: RA12.B2
AIN2+: RA12.C2
AIN2-: RA12.D2
AIN3+: RA13.A2
AIN3-: RA13.B2
AIN4+: RA13.C2
AIN4-: RA13.D2
AIN5+: RA14.A2
AIN5-: RA14.B2
AIN6+: RA14.C2
AIN6-: RA14.D2
AIN7+: RA15.A2
AIN7-: RA15.B2
AIN8+: RA15.C2
AIN8-: RA15.D2
CLKOUT: RA17.A1
GND: C137.2, C138.2, C139.2, C140.2, C141.2, C142.2, C143.2, C144.2, C145.2, C146.2, C147.2, C148.2, U34.3 (GND), U34.7 (GND), U34.12 (GND), U34.18 (GND), U34.23 (~SDR~/DDR), U34.25 (~CMOS~/LVDS), U34.26 (GND), U34.32 (GND), U34.34 (~CLKOUTEN~/CLKOUT-), U34.38 (GND), U34.46 (GND), U34.49 (GND), U34.53 (GND)
unnamed: C129.1, RA12.A1, U34.20 (AIN1+)
unnamed: C129.2, RA12.B1, U34.19 (AIN1-)
unnamed: C130.1, RA12.C1, U34.17 (AIN2+)
unnamed: C130.2, RA12.D1, U34.16 (AIN2-)
unnamed: C131.1, RA13.A1, U34.14 (AIN3+)
unnamed: C131.2, RA13.B1, U34.13 (AIN3-)
unnamed: C132.1, RA13.C1, U34.11 (AIN4+)
unnamed: C132.2, RA13.D1, U34.10 (AIN4-)
unnamed: C133.1, RA14.A1, U34.5 (AIN5+)
unnamed: C133.2, RA14.B1, U34.4 (AIN5-)
unnamed: C134.1, RA14.C1, U34.2 (AIN6+)
unnamed: C134.2, RA14.D1, U34.1 (AIN6-)
unnamed: C135.1, RA15.A1, U34.51 (AIN7+)
unnamed: C135.2, RA15.B1, U34.50 (AIN7-)
unnamed: C136.1, RA15.C1, U34.48 (AIN8+)
unnamed: C136.2, RA15.D1, U34.47 (AIN8-)
unnamed: C138.1, U34.8 (REF)
unnamed: C139.1, U34.22 (REFOUT1)
unnamed: C140.1, U34.9 (REFOUT2)
unnamed: C141.1, U34.6 (REFOUT3)
unnamed: C142.1, U34.45 (REFOUT4)
unnamed: RA16.A2, U34.27 (SDO1/SDOA+)
unnamed: RA16.B2, U34.28 (SDO2/SDOA-)
unnamed: RA16.C2, U34.29 (SDO3/SDOB+)
unnamed: RA16.D2, U34.30 (SDO4/SDOB-)
unnamed: RA17.A2, U34.33 (CLKOUT/CLKOUT+)
unnamed: RA17.C2, U34.35 (SDO5/SDOC+)
unnamed: RA17.D2, U34.36 (SDO6/SDOC-)
unnamed: RA18.A2, U34.39 (SDO7/SDOD+)
unnamed: RA18.B2, U34.40 (SDO8/SDOD-)
SCK: U34.41 (SCK/SCK+)
SDO1: RA16.A1
SDO2: RA16.B1
SDO3: RA16.C1
SDO4: RA16.D1
SDO5: RA17.C1
SDO6: RA17.D1
SDO7: RA18.A1
SDO8: RA18.B1
~CNV: U34.24 (~CNV)
