Nkyoku/phoenix-pcb/ADC2.sch

## KiCad design ADC2.sch (2020-08-01)

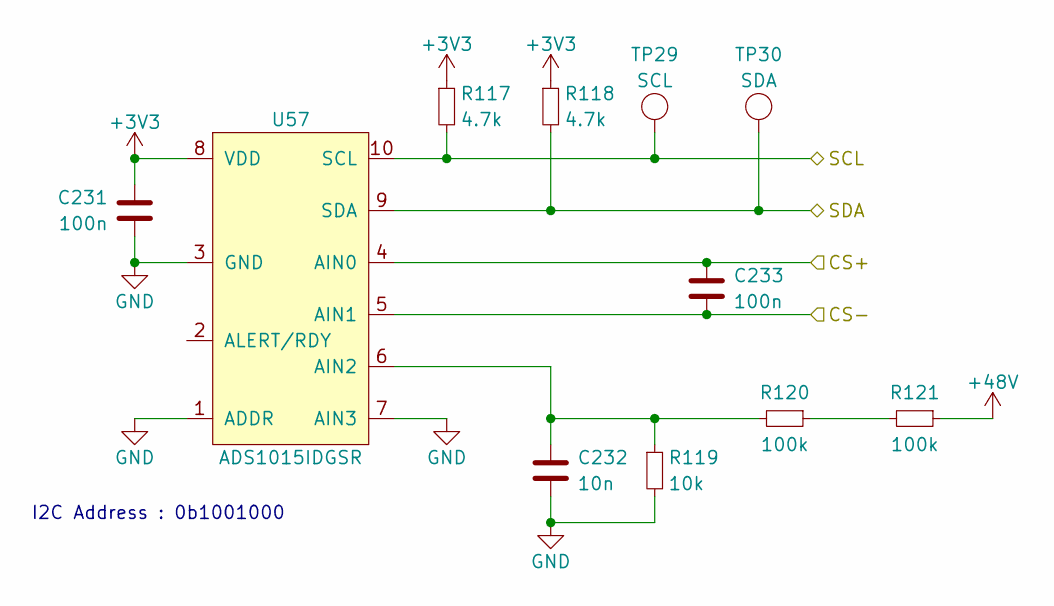
[picture p26: schematic ADC2.sch]

Parts:
C231, C233: 100n; C_CHIP_1005_Hand_NoSilk; PartName GRM155R71H104ME14D
C232: 10n; C_CHIP_1005_Hand_NoSilk; PartName GRM155B11E103K
R117, R118: 4.7k; R_CHIP_1005_Hand_NoSilk; PartName RK73H1ETTP4701F
R119: 10k; R_CHIP_1005_Hand_NoSilk; PartName RK73H1ETTP1002F
R120, R121: 100k; R_CHIP_1005_Hand_NoSilk; PartName RK73H1ETTP1003F
TP29: SCL; TP_C0.8
TP30: SDA; TP_C0.8
U57: ADS1015IDGSR; VSSOP10_3.0x3.0_P0.5; PartName ADS1015IDGSR

Connections:
+3V3: C231.1, R117.1, R118.1, U57.8 (VDD)
+48V: R121.1
CS+: C233.1, U57.4 (AIN0)
CS-: C233.2, U57.5 (AIN1)
GND: C231.2, C232.2, R119.2, U57.1 (ADDR), U57.3 (GND), U57.7 (AIN3)
unnamed: C232.1, R119.1, R120.2, U57.6 (AIN2)
unnamed: R120.1, R121.2
SCL: R117.2, TP29.1, U57.10 (SCL)
SDA: R118.2, TP30.1, U57.9 (SDA)

Notes on the sheet:
I2C Address : 0b1001000
