Nkyoku/phoenix-pcb/Extension.sch

## KiCad design Extension.sch (2020-07-20)

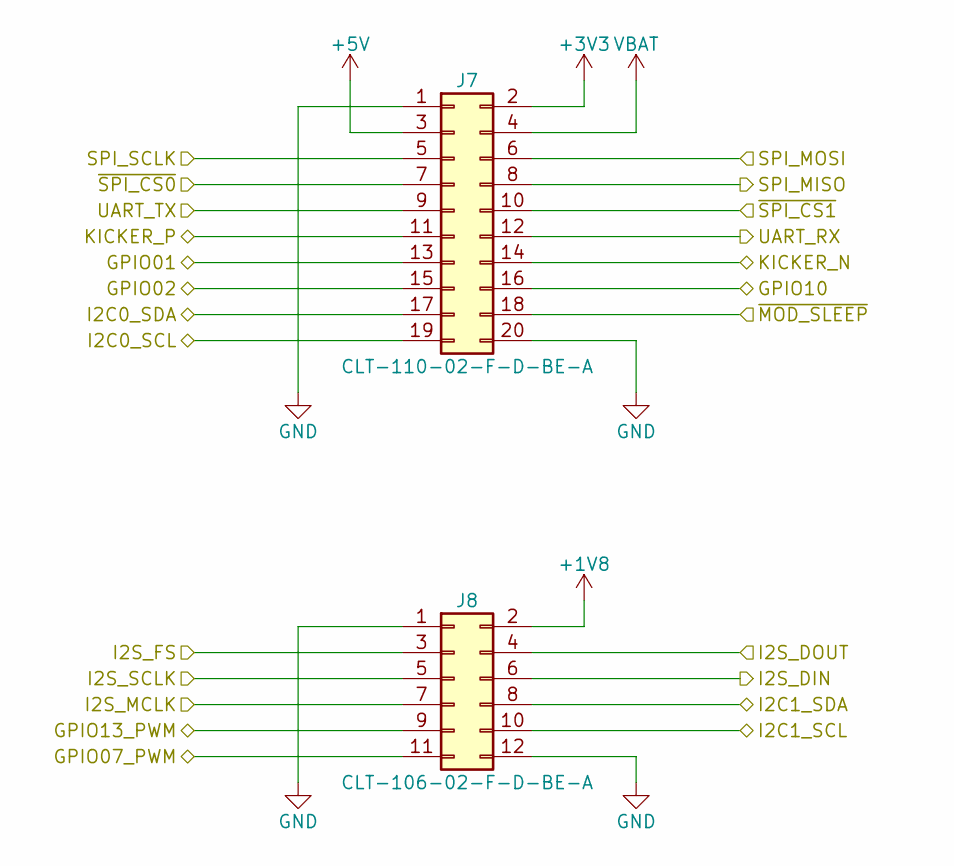
[picture p27: schematic Extension.sch]

Parts:
J7: CLT-110-02-F-D-BE-A; CLT-110-02-x-D-BE-A; PartName CLT-110-02-F-D-BE-A
J8: CLT-106-02-F-D-BE-A; CLT-106-02-x-D-BE-A; PartName CLT-106-02-F-D-BE-A

Connections:
+1V8: J8.2
+3V3: J7.2
+5V: J7.3
GND: J7.1, J7.20, J8.1, J8.12
GPIO01: J7.13
GPIO02: J7.15
GPIO07_PWM: J8.11
GPIO10: J7.16
GPIO13_PWM: J8.9
I2C0_SCL: J7.19
I2C0_SDA: J7.17
I2C1_SCL: J8.10
I2C1_SDA: J8.8
I2S_DIN: J8.6
I2S_DOUT: J8.4
I2S_FS: J8.3
I2S_MCLK: J8.7
I2S_SCLK: J8.5
KICKER_N: J7.14
KICKER_P: J7.11
SPI_MISO: J7.8
SPI_MOSI: J7.6
SPI_SCLK: J7.5
UART_RX: J7.12
UART_TX: J7.9
VBAT: J7.4
~MOD_SLEEP: J7.18
~SPI_CS0: J7.7
~SPI_CS1: J7.10
