Nkyoku/phoenix-pcb/FPGA-Memory.sch

## KiCad design FPGA-Memory.sch (2021-03-21)

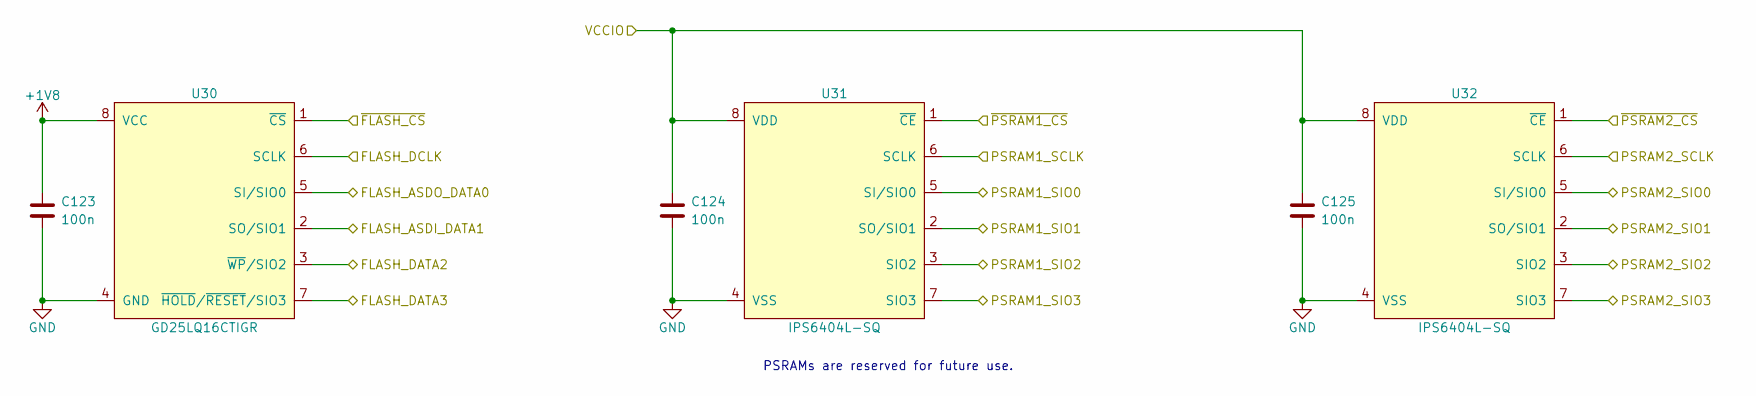
[picture p28: schematic FPGA-Memory.sch]

Parts:
C123, C124, C125: 100n; C_CHIP_1005_Hand_NoSilk; PartName GRM155R71H104ME14D
U30: GD25LQ16CTIGR; SOP8-W3.9; PartName GD25LQ16CTIGR
U31, U32: IPS6404L-SQ; SOP8-W3.9; PartName IPS6404L-SQ

Connections:
+1V8: C123.1, U30.8 (VCC)
FLASH_ASDI_DATA1: U30.2 (SO/SIO1)
FLASH_ASDO_DATA0: U30.5 (SI/SIO0)
FLASH_DATA2: U30.3 (~WP~/SIO2)
FLASH_DATA3: U30.7 (~HOLD~/~RESET~/SIO3)
FLASH_DCLK: U30.6 (SCLK)
GND: C123.2, C124.2, C125.2, U30.4 (GND), U31.4 (VSS), U32.4 (VSS)
PSRAM1_SCLK: U31.6 (SCLK)
PSRAM1_SIO0: U31.5 (SI/SIO0)
PSRAM1_SIO1: U31.2 (SO/SIO1)
PSRAM1_SIO2: U31.3 (SIO2)
PSRAM1_SIO3: U31.7 (SIO3)
PSRAM2_SCLK: U32.6 (SCLK)
PSRAM2_SIO0: U32.5 (SI/SIO0)
PSRAM2_SIO1: U32.2 (SO/SIO1)
PSRAM2_SIO2: U32.3 (SIO2)
PSRAM2_SIO3: U32.7 (SIO3)
VCCIO: C124.1, C125.1, U31.8 (VDD), U32.8 (VDD)
~FLASH_CS: U30.1 (~CS)
~PSRAM1_CS: U31.1 (~CE)
~PSRAM2_CS: U32.1 (~CE)

Notes on the sheet:
PSRAMs are reserved for future use.
