Nkyoku/phoenix-pcb/FPGA-Power.sch

## KiCad design FPGA-Power.sch (2020-08-01)

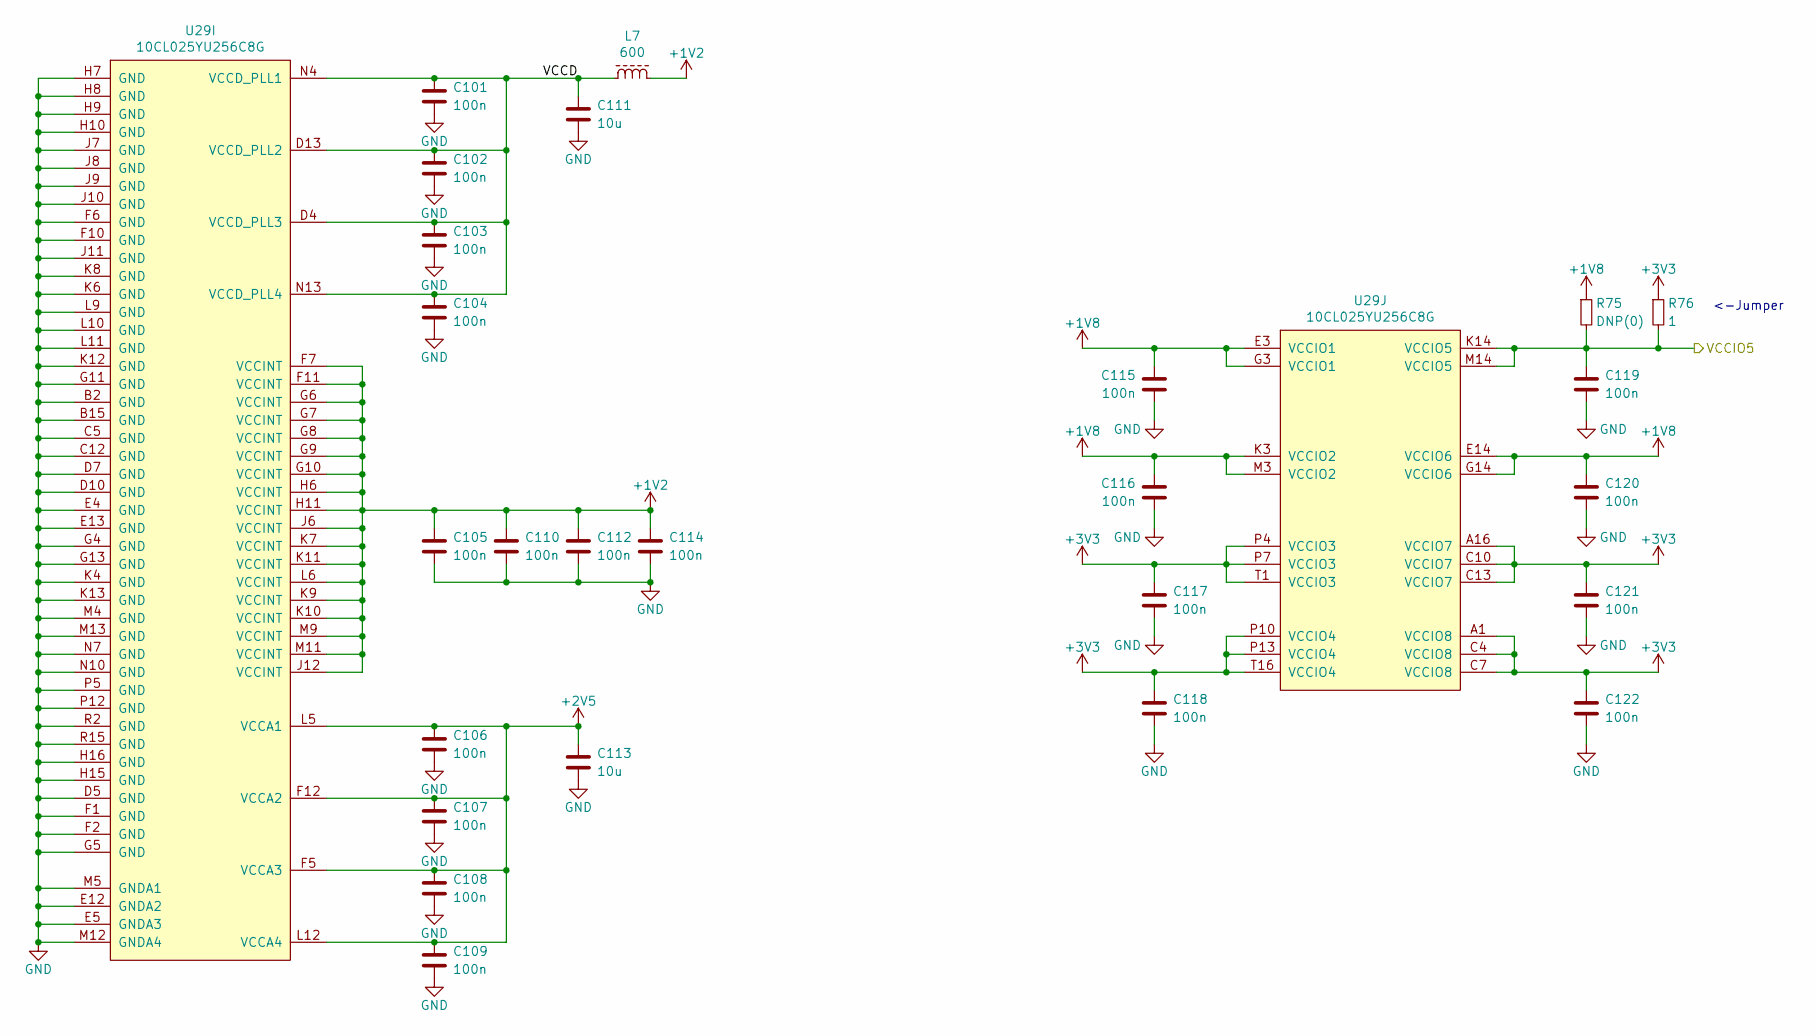
[picture p29: schematic FPGA-Power.sch]

Parts:
C101, C102, C103, C104, C105, C106, C107, C108, C109, C110, C112, C114, C115, C116, C117, C118, C119, C120, C121, C122: 100n; C_CHIP_1005_Hand_NoSilk; PartName GRM155R71H104ME14D
C111, C113: 10u; C_CHIP_1005_Hand_NoSilk; PartName GRJ155R60J106ME11D
L7: 600; L_CHIP_1005_Hand_NoSilk; PartName BLM15PX601SN1D
R75: DNP(0); R_CHIP_1005_Hand_NoSilk; PartName RK73Z1ETTP
R76: 1; R_CHIP_1005_Hand_NoSilk; PartName RK73B1ETTP1R0J
U29: 10CL025YU256C8G; BGA256_14.0x14.0_P0.8; PartName 10CL025YU256C8G

Connections:
+1V2: C105.1, C110.1, C112.1, C114.1, L7.2, U29.F7 (VCCINT), U29.F11 (VCCINT), U29.G6 (VCCINT), U29.G7 (VCCINT), U29.G8 (VCCINT), U29.G9 (VCCINT), U29.G10 (VCCINT), U29.H6 (VCCINT), U29.H11 (VCCINT), U29.J6 (VCCINT), U29.J12 (VCCINT), U29.K7 (VCCINT), U29.K9 (VCCINT), U29.K10 (VCCINT), U29.K11 (VCCINT), U29.L6 (VCCINT), U29.M9 (VCCINT), U29.M11 (VCCINT)
+1V8: C115.1, C116.1, C120.1, R75.1, U29.E3 (VCCIO1), U29.E14 (VCCIO6), U29.G3 (VCCIO1), U29.G14 (VCCIO6), U29.K3 (VCCIO2), U29.M3 (VCCIO2)
+2V5: C106.1, C107.1, C108.1, C109.1, C113.1, U29.F5 (VCCA3), U29.F12 (VCCA2), U29.L5 (VCCA1), U29.L12 (VCCA4)
+3V3: C117.1, C118.1, C121.1, C122.1, R76.1, U29.A1 (VCCIO8), U29.A16 (VCCIO7), U29.C4 (VCCIO8), U29.C7 (VCCIO8), U29.C10 (VCCIO7), U29.C13 (VCCIO7), U29.P4 (VCCIO3), U29.P7 (VCCIO3), U29.P10 (VCCIO4), U29.P13 (VCCIO4), U29.T1 (VCCIO3), U29.T16 (VCCIO4)
GND: C101.2, C102.2, C103.2, C104.2, C105.2, C106.2, C107.2, C108.2, C109.2, C110.2, C111.2, C112.2, C113.2, C114.2, C115.2, C116.2, C117.2, C118.2, C119.2, C120.2, C121.2, C122.2, U29.B2 (GND), U29.B15 (GND), U29.C5 (GND), U29.C12 (GND), U29.D5 (GND), U29.D7 (GND), U29.D10 (GND), U29.E4 (GND), U29.E5 (GNDA3), U29.E12 (GNDA2), U29.E13 (GND), U29.F1 (GND), U29.F2 (GND), U29.F6 (GND), U29.F10 (GND), U29.G4 (GND), U29.G5 (GND), U29.G11 (GND), U29.G13 (GND), U29.H7 (GND), U29.H8 (GND), U29.H9 (GND), U29.H10 (GND), U29.H15 (GND), U29.H16 (GND), U29.J7 (GND), U29.J8 (GND), U29.J9 (GND), U29.J10 (GND), U29.J11 (GND), U29.K4 (GND), U29.K6 (GND), U29.K8 (GND), U29.K12 (GND), U29.K13 (GND), U29.L9 (GND), U29.L10 (GND), U29.L11 (GND), U29.M4 (GND), U29.M5 (GNDA1), U29.M12 (GNDA4), U29.M13 (GND), U29.N7 (GND), U29.N10 (GND), U29.P5 (GND), U29.P12 (GND), U29.R2 (GND), U29.R15 (GND)
VCCD: C101.1, C102.1, C103.1, C104.1, C111.1, L7.1, U29.D4 (VCCD_PLL3), U29.D13 (VCCD_PLL2), U29.N4 (VCCD_PLL1), U29.N13 (VCCD_PLL4)
VCCIO5: C119.1, R75.2, R76.2, U29.K14 (VCCIO5), U29.M14 (VCCIO5)

Notes on the sheet:
<-Jumper
