Nkyoku/phoenix-pcb/FPGA.sch

## KiCad design FPGA.sch (2021-03-21)

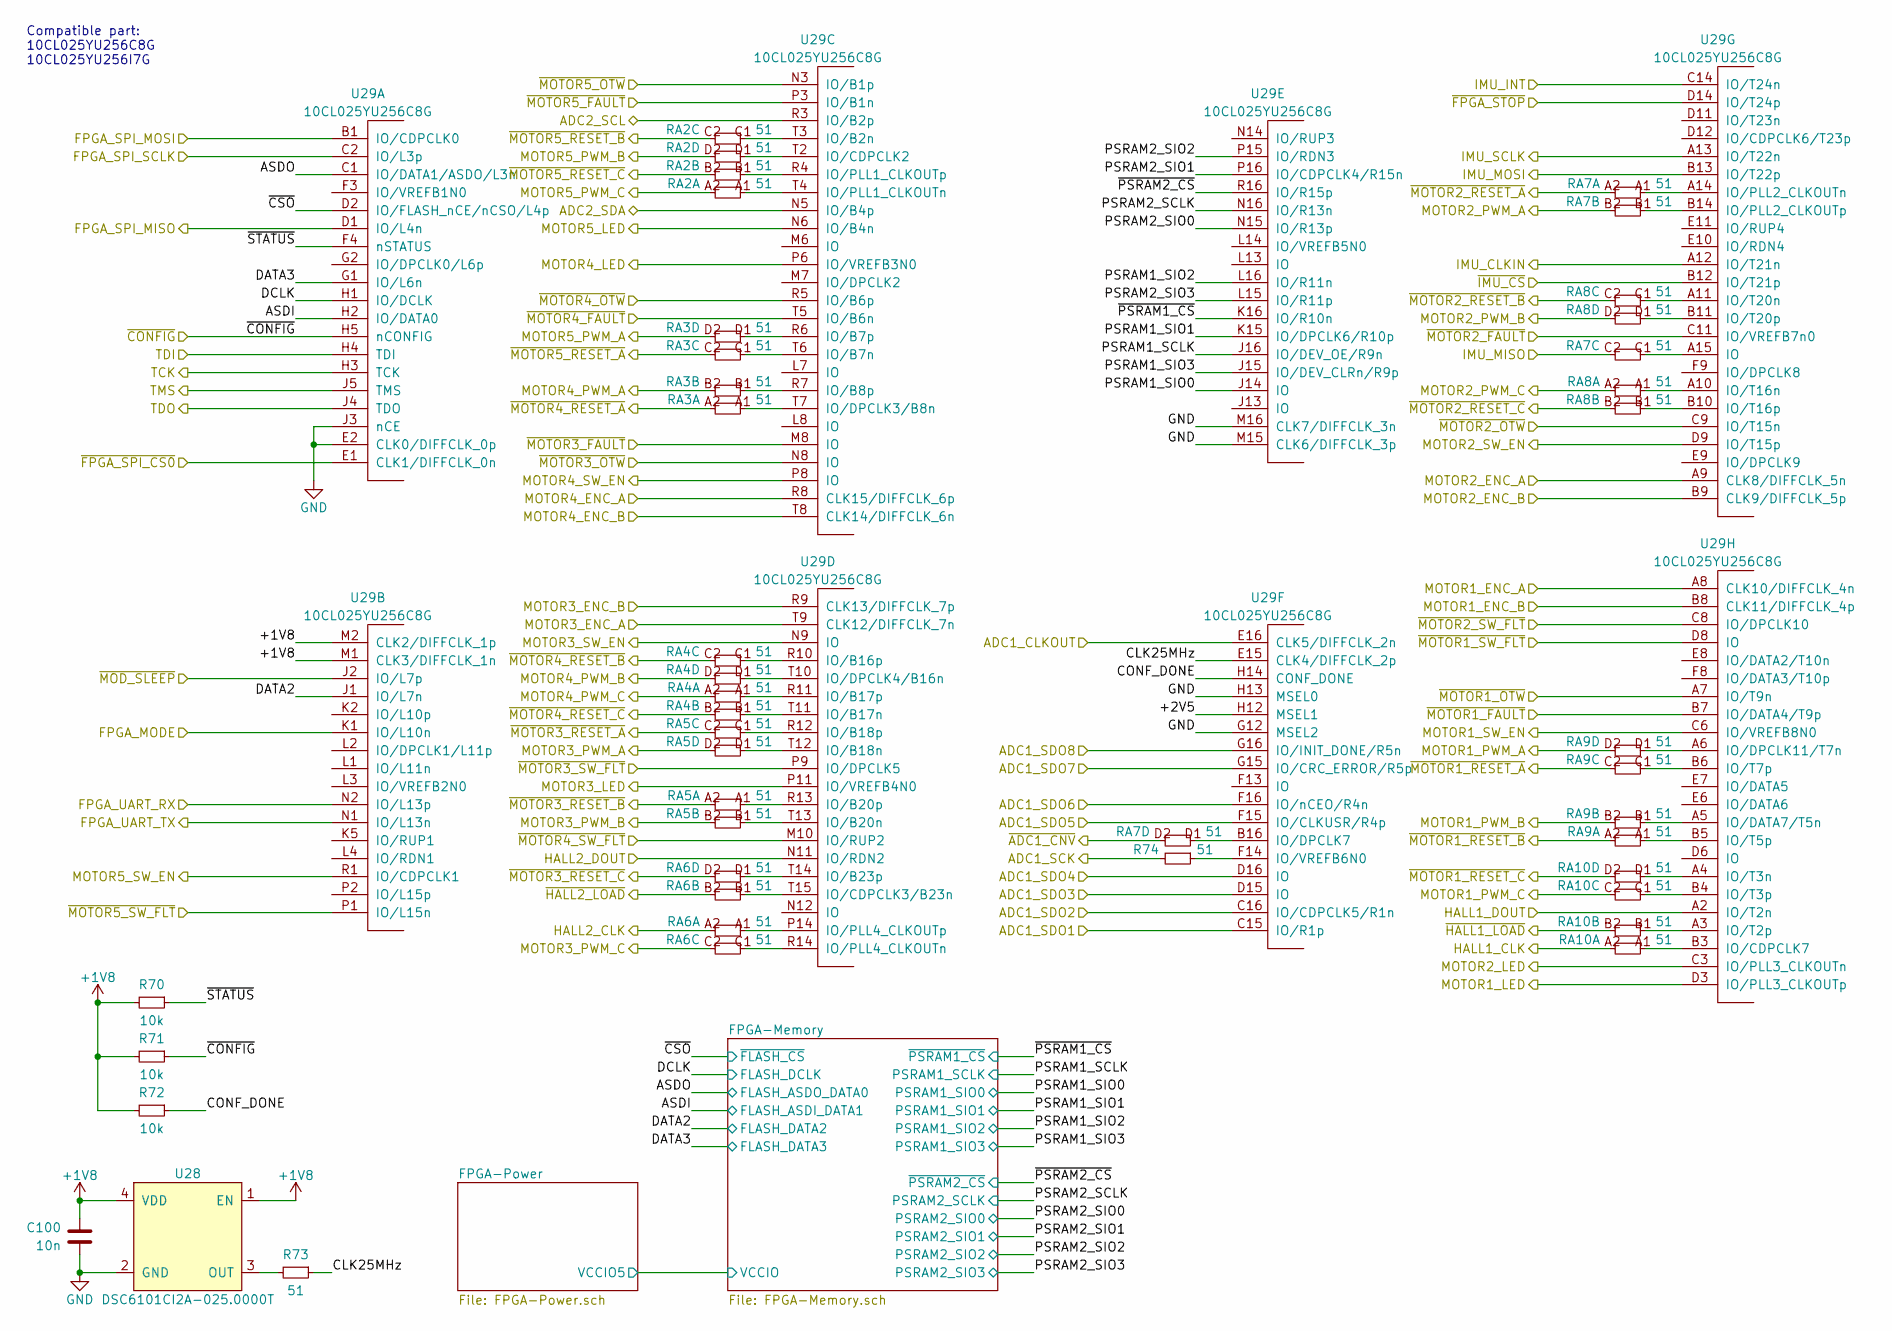
[picture p30: schematic FPGA.sch]

Parts:
C100: 10n; C_CHIP_1005_Hand_NoSilk; PartName GRM155B11E103K
R70, R71, R72: 10k; R_CHIP_1005_Hand_NoSilk; PartName RK73H1ETTP1002F
R73, R74: 51; R_CHIP_1005_Hand_NoSilk; PartName RK73B1ETTP510J
RA2, RA3, RA4, RA5, RA6, RA7, RA8, RA9, RA10: 51; R_CHIP_4x1005_CONCAVE; PartName EXB-N8V510JX
U28: DSC6101CI2A-025.0000T; DSC6xxxC; PartName DSC6101CI2A-025.0000T
U29: 10CL025YU256C8G; BGA256_14.0x14.0_P0.8; PartName 10CL025YU256C8G

Connections:
+1V8: C100.1, R70.2, R71.2, R72.2, U28.1 (EN), U28.4 (VDD), U29.M1 (CLK3/DIFFCLK_1n), U29.M2 (CLK2/DIFFCLK_1p)
+2V5: U29.H12 (MSEL1)
ADC1_CLKOUT: U29.E16 (CLK5/DIFFCLK_2n)
ADC1_SCK: R74.2
ADC1_SDO1: U29.C15 (IO/R1p)
ADC1_SDO2: U29.C16 (IO/CDPCLK5/R1n)
ADC1_SDO3: U29.D15 (IO)
ADC1_SDO4: U29.D16 (IO)
ADC1_SDO5: U29.F15 (IO/CLKUSR/R4p)
ADC1_SDO6: U29.F16 (IO/nCEO/R4n)
ADC1_SDO7: U29.G15 (IO/CRC_ERROR/R5p)
ADC1_SDO8: U29.G16 (IO/INIT_DONE/R5n)
ADC2_SCL: U29.R3 (IO/B2p)
ADC2_SDA: U29.N5 (IO/B4p)
ASDI: U29.H2 (IO/DATA0)
ASDO: U29.C1 (IO/DATA1/ASDO/L3n)
CLK25MHz: R73.1, U29.E15 (CLK4/DIFFCLK_2p)
CONF_DONE: R72.1, U29.H14 (CONF_DONE)
DATA2: U29.J1 (IO/L7n)
DATA3: U29.G1 (IO/L6n)
DCLK: U29.H1 (IO/DCLK)
FPGA_MODE: U29.K1 (IO/L10n)
FPGA_SPI_MISO: U29.D1 (IO/L4n)
FPGA_SPI_MOSI: U29.B1 (IO/CDPCLK0)
FPGA_SPI_SCLK: U29.C2 (IO/L3p)
FPGA_UART_RX: U29.N2 (IO/L13p)
FPGA_UART_TX: U29.N1 (IO/L13n)
GND: C100.2, U28.2 (GND), U29.E2 (CLK0/DIFFCLK_0p), U29.G12 (MSEL2), U29.H13 (MSEL0), U29.J3 (nCE), U29.M15 (CLK6/DIFFCLK_3p), U29.M16 (CLK7/DIFFCLK_3n)
HALL1_CLK: RA10.A2
HALL1_DOUT: U29.A2 (IO/T2n)
HALL2_CLK: RA6.A2
HALL2_DOUT: U29.N11 (IO/RDN2)
IMU_CLKIN: U29.A12 (IO/T21n)
IMU_INT: U29.C14 (IO/T24n)
IMU_MISO: RA7.C2
IMU_MOSI: U29.B13 (IO/T22p)
IMU_SCLK: U29.A13 (IO/T22n)
MOTOR1_ENC_A: U29.A8 (CLK10/DIFFCLK_4n)
MOTOR1_ENC_B: U29.B8 (CLK11/DIFFCLK_4p)
MOTOR1_LED: U29.D3 (IO/PLL3_CLKOUTp)
MOTOR1_PWM_A: RA9.D2
MOTOR1_PWM_B: RA9.B2
MOTOR1_PWM_C: RA10.C2
MOTOR1_SW_EN: U29.C6 (IO/VREFB8N0)
MOTOR2_ENC_A: U29.A9 (CLK8/DIFFCLK_5n)
MOTOR2_ENC_B: U29.B9 (CLK9/DIFFCLK_5p)
MOTOR2_LED: U29.C3 (IO/PLL3_CLKOUTn)
MOTOR2_PWM_A: RA7.B2
MOTOR2_PWM_B: RA8.D2
MOTOR2_PWM_C: RA8.A2
MOTOR2_SW_EN: U29.D9 (IO/T15p)
MOTOR3_ENC_A: U29.T9 (CLK12/DIFFCLK_7n)
MOTOR3_ENC_B: U29.R9 (CLK13/DIFFCLK_7p)
MOTOR3_LED: U29.P11 (IO/VREFB4N0)
MOTOR3_PWM_A: RA5.D2
MOTOR3_PWM_B: RA5.B2
MOTOR3_PWM_C: RA6.C2
MOTOR3_SW_EN: U29.N9 (IO)
MOTOR4_ENC_A: U29.R8 (CLK15/DIFFCLK_6p)
MOTOR4_ENC_B: U29.T8 (CLK14/DIFFCLK_6n)
MOTOR4_LED: U29.P6 (IO/VREFB3N0)
MOTOR4_PWM_A: RA3.B2
MOTOR4_PWM_B: RA4.D2
MOTOR4_PWM_C: RA4.A2
MOTOR4_SW_EN: U29.P8 (IO)
MOTOR5_LED: U29.N6 (IO/B4n)
MOTOR5_PWM_A: RA3.D2
MOTOR5_PWM_B: RA2.D2
MOTOR5_PWM_C: RA2.A2
MOTOR5_SW_EN: U29.R1 (IO/CDPCLK1)
unnamed: R73.2, U28.3 (OUT)
unnamed: R74.1, U29.F14 (IO/VREFB6N0)
unnamed: RA2.A1, U29.T4 (IO/PLL1_CLKOUTn)
unnamed: RA2.B1, U29.R4 (IO/PLL1_CLKOUTp)
unnamed: RA2.C1, U29.T3 (IO/B2n)
unnamed: RA2.D1, U29.T2 (IO/CDPCLK2)
unnamed: RA3.A1, U29.T7 (IO/DPCLK3/B8n)
unnamed: RA3.B1, U29.R7 (IO/B8p)
unnamed: RA3.C1, U29.T6 (IO/B7n)
unnamed: RA3.D1, U29.R6 (IO/B7p)
unnamed: RA4.A1, U29.R11 (IO/B17p)
unnamed: RA4.B1, U29.T11 (IO/B17n)
unnamed: RA4.C1, U29.R10 (IO/B16p)
unnamed: RA4.D1, U29.T10 (IO/DPCLK4/B16n)
unnamed: RA5.A1, U29.R13 (IO/B20p)
unnamed: RA5.B1, U29.T13 (IO/B20n)
unnamed: RA5.C1, U29.R12 (IO/B18p)
unnamed: RA5.D1, U29.T12 (IO/B18n)
unnamed: RA6.A1, U29.P14 (IO/PLL4_CLKOUTp)
unnamed: RA6.B1, U29.T15 (IO/CDPCLK3/B23n)
unnamed: RA6.C1, U29.R14 (IO/PLL4_CLKOUTn)
unnamed: RA6.D1, U29.T14 (IO/B23p)
unnamed: RA7.A1, U29.A14 (IO/PLL2_CLKOUTn)
unnamed: RA7.B1, U29.B14 (IO/PLL2_CLKOUTp)
unnamed: RA7.C1, U29.A15 (IO)
unnamed: RA7.D1, U29.B16 (IO/DPCLK7)
unnamed: RA8.A1, U29.A10 (IO/T16n)
unnamed: RA8.B1, U29.B10 (IO/T16p)
unnamed: RA8.C1, U29.A11 (IO/T20n)
unnamed: RA8.D1, U29.B11 (IO/T20p)
unnamed: RA9.A1, U29.B5 (IO/T5p)
unnamed: RA9.B1, U29.A5 (IO/DATA7/T5n)
unnamed: RA9.C1, U29.B6 (IO/T7p)
unnamed: RA9.D1, U29.A6 (IO/DPCLK11/T7n)
unnamed: RA10.A1, U29.B3 (IO/CDPCLK7)
unnamed: RA10.B1, U29.A3 (IO/T2p)
unnamed: RA10.C1, U29.B4 (IO/T3p)
unnamed: RA10.D1, U29.A4 (IO/T3n)
PSRAM1_SCLK: U29.J16 (IO/DEV_OE/R9n)
PSRAM1_SIO0: U29.J14 (IO)
PSRAM1_SIO1: U29.K15 (IO/DPCLK6/R10p)
PSRAM1_SIO2: U29.L16 (IO/R11n)
PSRAM1_SIO3: U29.J15 (IO/DEV_CLRn/R9p)
PSRAM2_SCLK: U29.N16 (IO/R13n)
PSRAM2_SIO0: U29.N15 (IO/R13p)
PSRAM2_SIO1: U29.P16 (IO/CDPCLK4/R15n)
PSRAM2_SIO2: U29.P15 (IO/RDN3)
PSRAM2_SIO3: U29.L15 (IO/R11p)
TCK: U29.H3 (TCK)
TDI: U29.H4 (TDI)
TDO: U29.J4 (TDO)
TMS: U29.J5 (TMS)
~ADC1_CNV: RA7.D2
~CONFIG: R71.1, U29.H5 (nCONFIG)
~CSO: U29.D2 (IO/FLASH_nCE/nCSO/L4p)
~FPGA_SPI_CS0: U29.E1 (CLK1/DIFFCLK_0n)
~FPGA_STOP: U29.D14 (IO/T24p)
~HALL1_LOAD: RA10.B2
~HALL2_LOAD: RA6.B2
~IMU_CS: U29.B12 (IO/T21p)
~MOD_SLEEP: U29.J2 (IO/L7p)
~MOTOR1_FAULT: U29.B7 (IO/DATA4/T9p)
~MOTOR1_OTW: U29.A7 (IO/T9n)
~MOTOR1_RESET_A: RA9.C2
~MOTOR1_RESET_B: RA9.A2
~MOTOR1_RESET_C: RA10.D2
~MOTOR1_SW_FLT: U29.D8 (IO)
~MOTOR2_FAULT: U29.C11 (IO/VREFB7n0)
~MOTOR2_OTW: U29.C9 (IO/T15n)
~MOTOR2_RESET_A: RA7.A2
~MOTOR2_RESET_B: RA8.C2
~MOTOR2_RESET_C: RA8.B2
~MOTOR2_SW_FLT: U29.C8 (IO/DPCLK10)
~MOTOR3_FAULT: U29.M8 (IO)
~MOTOR3_OTW: U29.N8 (IO)
~MOTOR3_RESET_A: RA5.C2
~MOTOR3_RESET_B: RA5.A2
~MOTOR3_RESET_C: RA6.D2
~MOTOR3_SW_FLT: U29.P9 (IO/DPCLK5)
~MOTOR4_FAULT: U29.T5 (IO/B6n)
~MOTOR4_OTW: U29.R5 (IO/B6p)
~MOTOR4_RESET_A: RA3.A2
~MOTOR4_RESET_B: RA4.C2
~MOTOR4_RESET_C: RA4.B2
~MOTOR4_SW_FLT: U29.M10 (IO/RUP2)
~MOTOR5_FAULT: U29.P3 (IO/B1n)
~MOTOR5_OTW: U29.N3 (IO/B1p)
~MOTOR5_RESET_A: RA3.C2
~MOTOR5_RESET_B: RA2.C2
~MOTOR5_RESET_C: RA2.B2
~MOTOR5_SW_FLT: U29.P1 (IO/L15n)
~PSRAM1_CS: U29.K16 (IO/R10n)
~PSRAM2_CS: U29.R16 (IO/R15p)
~STATUS: R70.1, U29.F4 (nSTATUS)

Notes on the sheet:
Compatible part: 10CL025YU256C8G 10CL025YU256I7G
