Nkyoku/phoenix-pcb/Interface1.sch

## KiCad design Interface1.sch (2020-08-01)

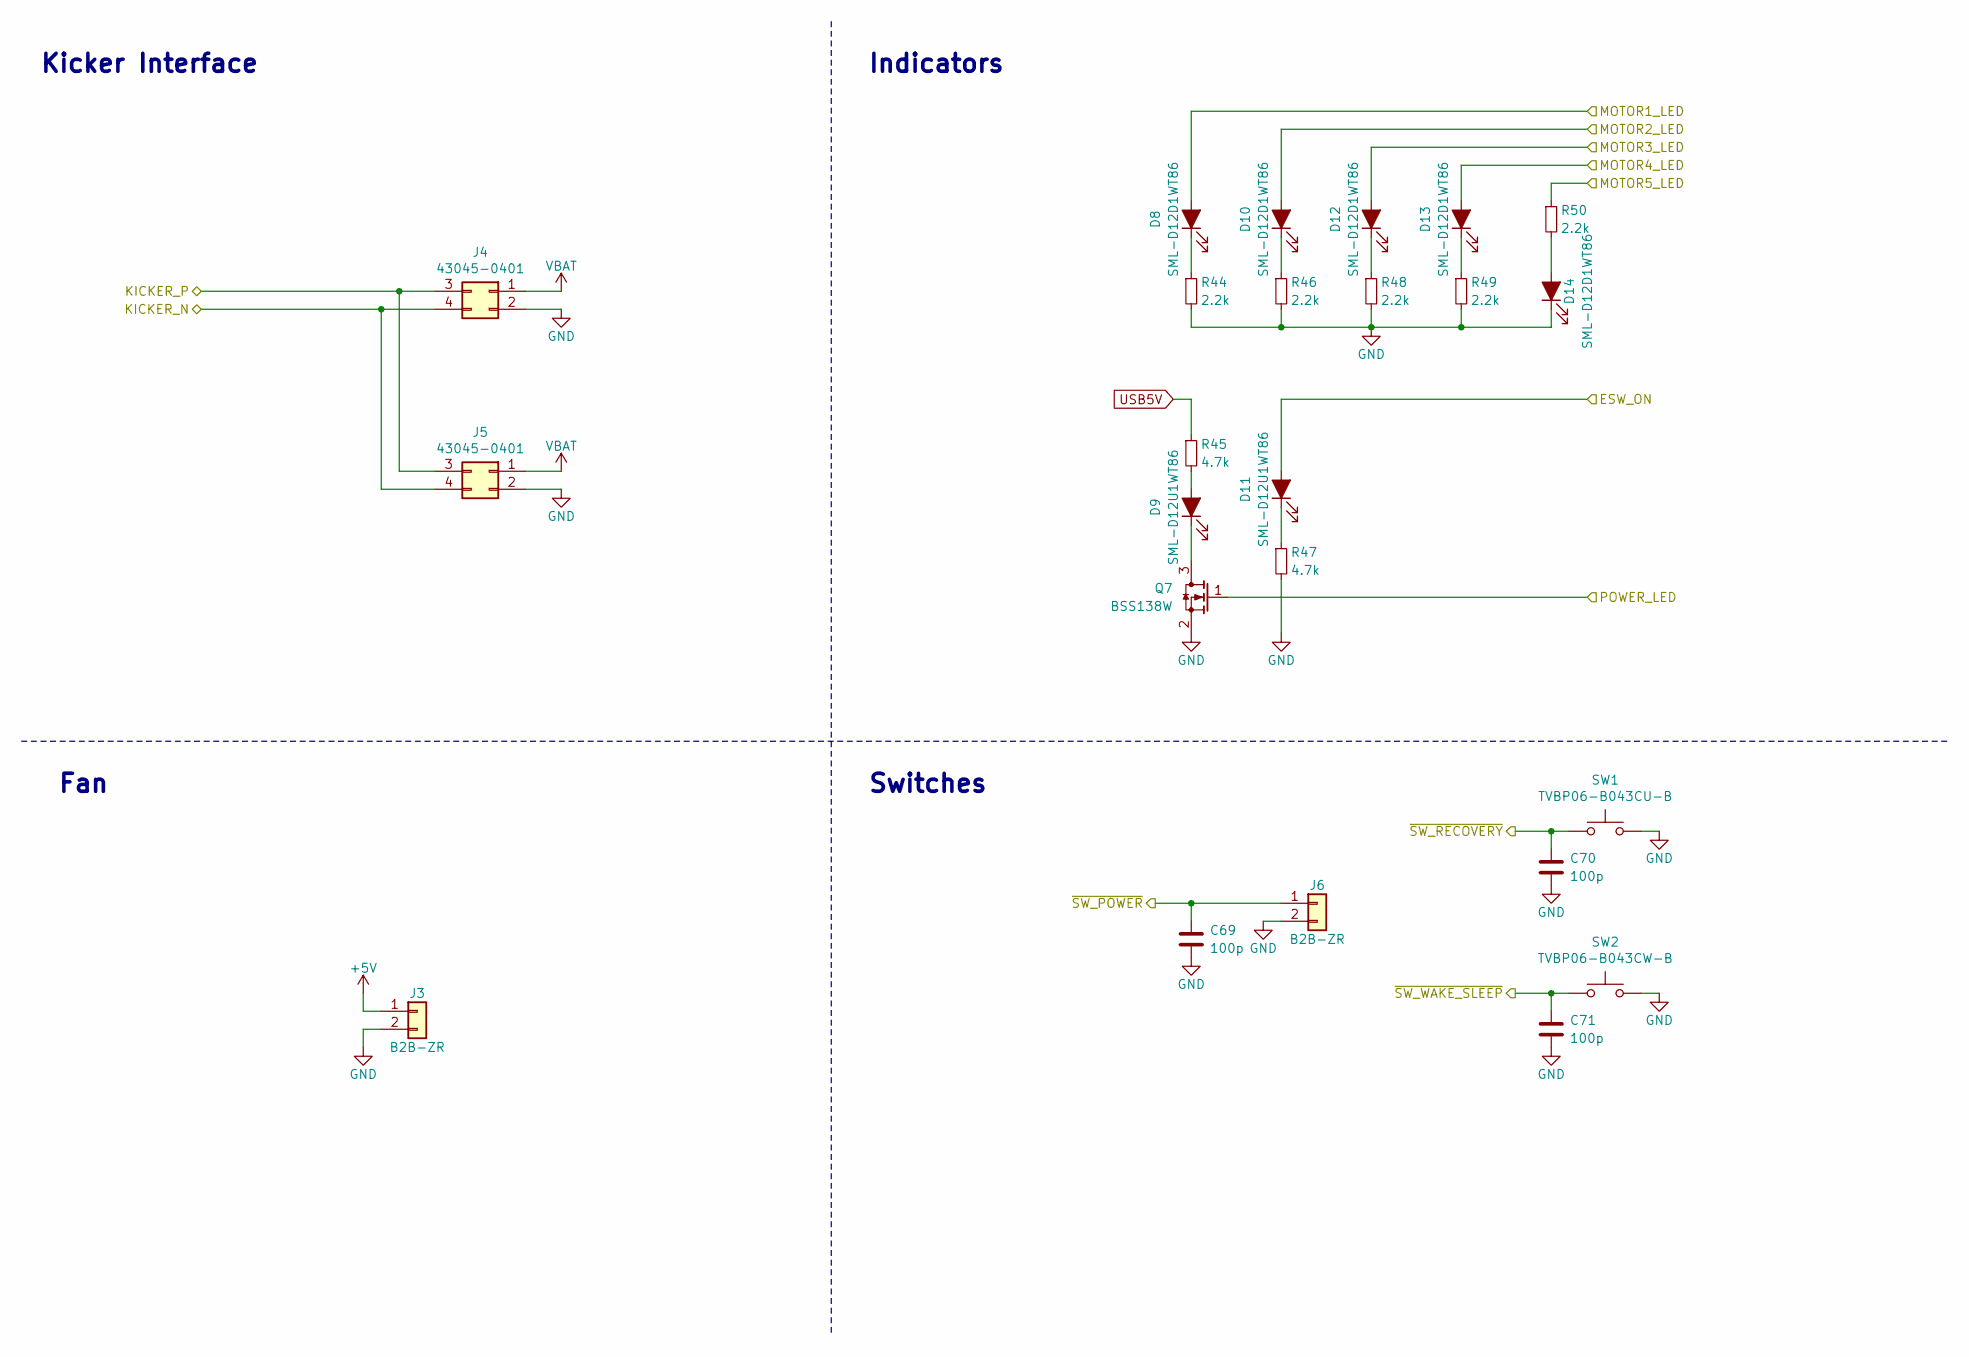
[picture p31: schematic Interface1.sch]

Parts:
C69, C70, C71: 100p; C_CHIP_1005_Hand_NoSilk; PartName GRM1552C1H101J
D8, D10, D12, D13, D14: SML-D12D1WT86; LED_CHIP_1608_Reflow; PartName SML-D12D1WT86
D9, D11: SML-D12U1WT86; LED_CHIP_1608_Reflow; PartName SML-D12M8WT86
J3, J6: B2B-ZR; PartName B2B-ZR
J4, J5: 43045-0401; 43045-040x; PartName 43045-0401
Q7: BSS138W; SC70-3; PartName BSS138W-7-F
R44, R46, R48, R49, R50: 2.2k; R_CHIP_1005_Hand_NoSilk; PartName RK73B1ETTP222J
R45, R47: 4.7k; R_CHIP_1005_Hand_NoSilk; PartName RK73H1ETTP4701F
SW1: TVBP06-B043CU-B; TVBP06; PartName TVBP06-B043CU-B
SW2: TVBP06-B043CW-B; TVBP06; PartName TVBP06-B043CW-B

Connections:
+5V: J3.1
ESW_ON: D11.2 (A)
GND: C69.2, C70.2, C71.2, D14.1 (K), J3.2, J4.2, J5.2, J6.2, Q7.2 (S), R44.2, R46.2, R47.2, R48.2, R49.2, SW1.2, SW2.2
KICKER_N: J4.4, J5.4
KICKER_P: J4.3, J5.3
MOTOR1_LED: D8.2 (A)
MOTOR2_LED: D10.2 (A)
MOTOR3_LED: D12.2 (A)
MOTOR4_LED: D13.2 (A)
MOTOR5_LED: R50.1
unnamed: D8.1 (K), R44.1
unnamed: D9.1 (K), Q7.3 (D)
unnamed: D9.2 (A), R45.2
unnamed: D10.1 (K), R46.1
unnamed: D11.1 (K), R47.1
unnamed: D12.1 (K), R48.1
unnamed: D13.1 (K), R49.1
unnamed: D14.2 (A), R50.2
POWER_LED: Q7.1 (G)
USB5V: R45.1
VBAT: J4.1, J5.1
~SW_POWER: C69.1, J6.1
~SW_RECOVERY: C70.1, SW1.1
~SW_WAKE_SLEEP: C71.1, SW2.1

Notes on the sheet:
Kicker Interface
Switches
Indicators
Fan
