Nkyoku/phoenix-pcb/Interface2.sch

## KiCad design Interface2.sch (2021-03-21)

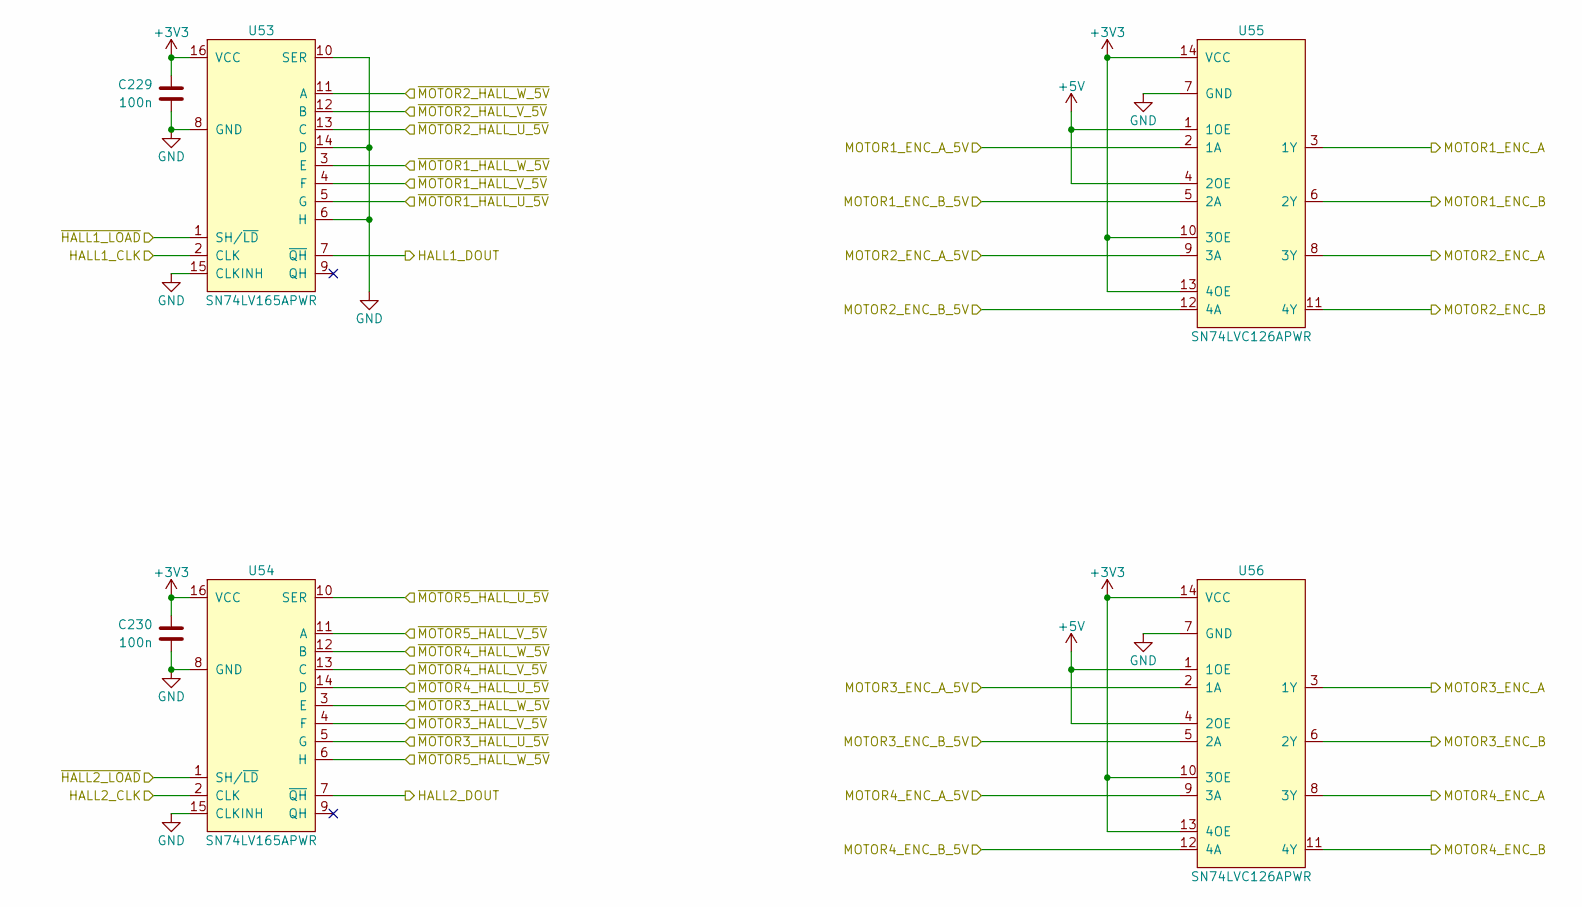
[picture p32: schematic Interface2.sch]

Parts:
C229, C230: 100n; C_CHIP_1005_Hand_NoSilk; PartName GRM155R71H104ME14D
U53, U54: SN74LV165APWR; TSSOP16-W4.4; PartName SN74LV165APWR
U55, U56: SN74LVC126APWR; TSSOP14-W4.4; PartName SN74LVC126APWR

Connections:
+3V3: C229.1, C230.1, U53.16 (VCC), U54.16 (VCC), U55.10 (3OE), U55.13 (4OE), U55.14 (VCC), U56.10 (3OE), U56.13 (4OE), U56.14 (VCC)
+5V: U55.1 (1OE), U55.4 (2OE), U56.1 (1OE), U56.4 (2OE)
GND: C229.2, C230.2, U53.6 (H), U53.8 (GND), U53.10 (SER), U53.14 (D), U53.15 (CLKINH), U54.8 (GND), U54.15 (CLKINH), U55.7 (GND), U56.7 (GND)
HALL1_CLK: U53.2 (CLK)
HALL1_DOUT: U53.7 (~QH)
HALL2_CLK: U54.2 (CLK)
HALL2_DOUT: U54.7 (~QH)
MOTOR1_ENC_A: U55.3 (1Y)
MOTOR1_ENC_A_5V: U55.2 (1A)
MOTOR1_ENC_B: U55.6 (2Y)
MOTOR1_ENC_B_5V: U55.5 (2A)
MOTOR2_ENC_A: U55.8 (3Y)
MOTOR2_ENC_A_5V: U55.9 (3A)
MOTOR2_ENC_B: U55.11 (4Y)
MOTOR2_ENC_B_5V: U55.12 (4A)
MOTOR3_ENC_A: U56.3 (1Y)
MOTOR3_ENC_A_5V: U56.2 (1A)
MOTOR3_ENC_B: U56.6 (2Y)
MOTOR3_ENC_B_5V: U56.5 (2A)
MOTOR4_ENC_A: U56.8 (3Y)
MOTOR4_ENC_A_5V: U56.9 (3A)
MOTOR4_ENC_B: U56.11 (4Y)
MOTOR4_ENC_B_5V: U56.12 (4A)
~HALL1_LOAD: U53.1 (SH/~LD~)
~HALL2_LOAD: U54.1 (SH/~LD~)
~MOTOR1_HALL_U_5V: U53.5 (G)
~MOTOR1_HALL_V_5V: U53.4 (F)
~MOTOR1_HALL_W_5V: U53.3 (E)
~MOTOR2_HALL_U_5V: U53.13 (C)
~MOTOR2_HALL_V_5V: U53.12 (B)
~MOTOR2_HALL_W_5V: U53.11 (A)
~MOTOR3_HALL_U_5V: U54.5 (G)
~MOTOR3_HALL_V_5V: U54.4 (F)
~MOTOR3_HALL_W_5V: U54.3 (E)
~MOTOR4_HALL_U_5V: U54.14 (D)
~MOTOR4_HALL_V_5V: U54.13 (C)
~MOTOR4_HALL_W_5V: U54.12 (B)
~MOTOR5_HALL_U_5V: U54.10 (SER)
~MOTOR5_HALL_V_5V: U54.11 (A)
~MOTOR5_HALL_W_5V: U54.6 (H)
