Nkyoku/phoenix-pcb/JTAG.sch

## KiCad design JTAG.sch (2020-08-01)

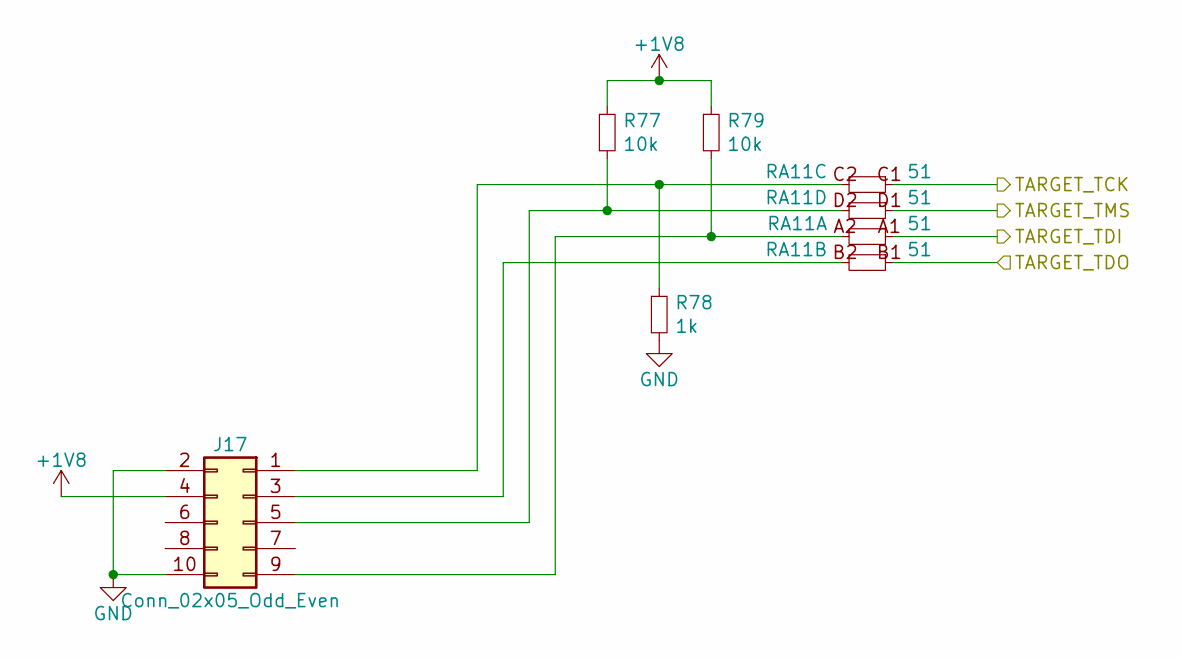
[picture p33: schematic JTAG.sch]

Parts:
J17: Conn_02x05_Odd_Even; PinHeader_2x05_P1.27mm_Vertical; PartName PH11-2x5SAG
R77, R79: 10k; R_CHIP_1005_Hand_NoSilk; PartName RK73H1ETTP1002F
R78: 1k; R_CHIP_1005_Hand_NoSilk; PartName RK73B1ETTP102J
RA11: 51; R_CHIP_4x1005_CONCAVE; PartName EXB-N8V510JX

Connections:
+1V8: J17.4, R77.1, R79.1
GND: J17.2, J17.10, R78.2
unnamed: J17.1, R78.1, RA11.C2
unnamed: J17.3, RA11.B2
unnamed: J17.5, R77.2, RA11.D2
unnamed: J17.9, R79.2, RA11.A2
TARGET_TCK: RA11.C1
TARGET_TDI: RA11.A1
TARGET_TDO: RA11.B1
TARGET_TMS: RA11.D1
