Nkyoku/phoenix-pcb/MotorDriver1.sch

## KiCad design MotorDriver1.sch (2020-08-01)

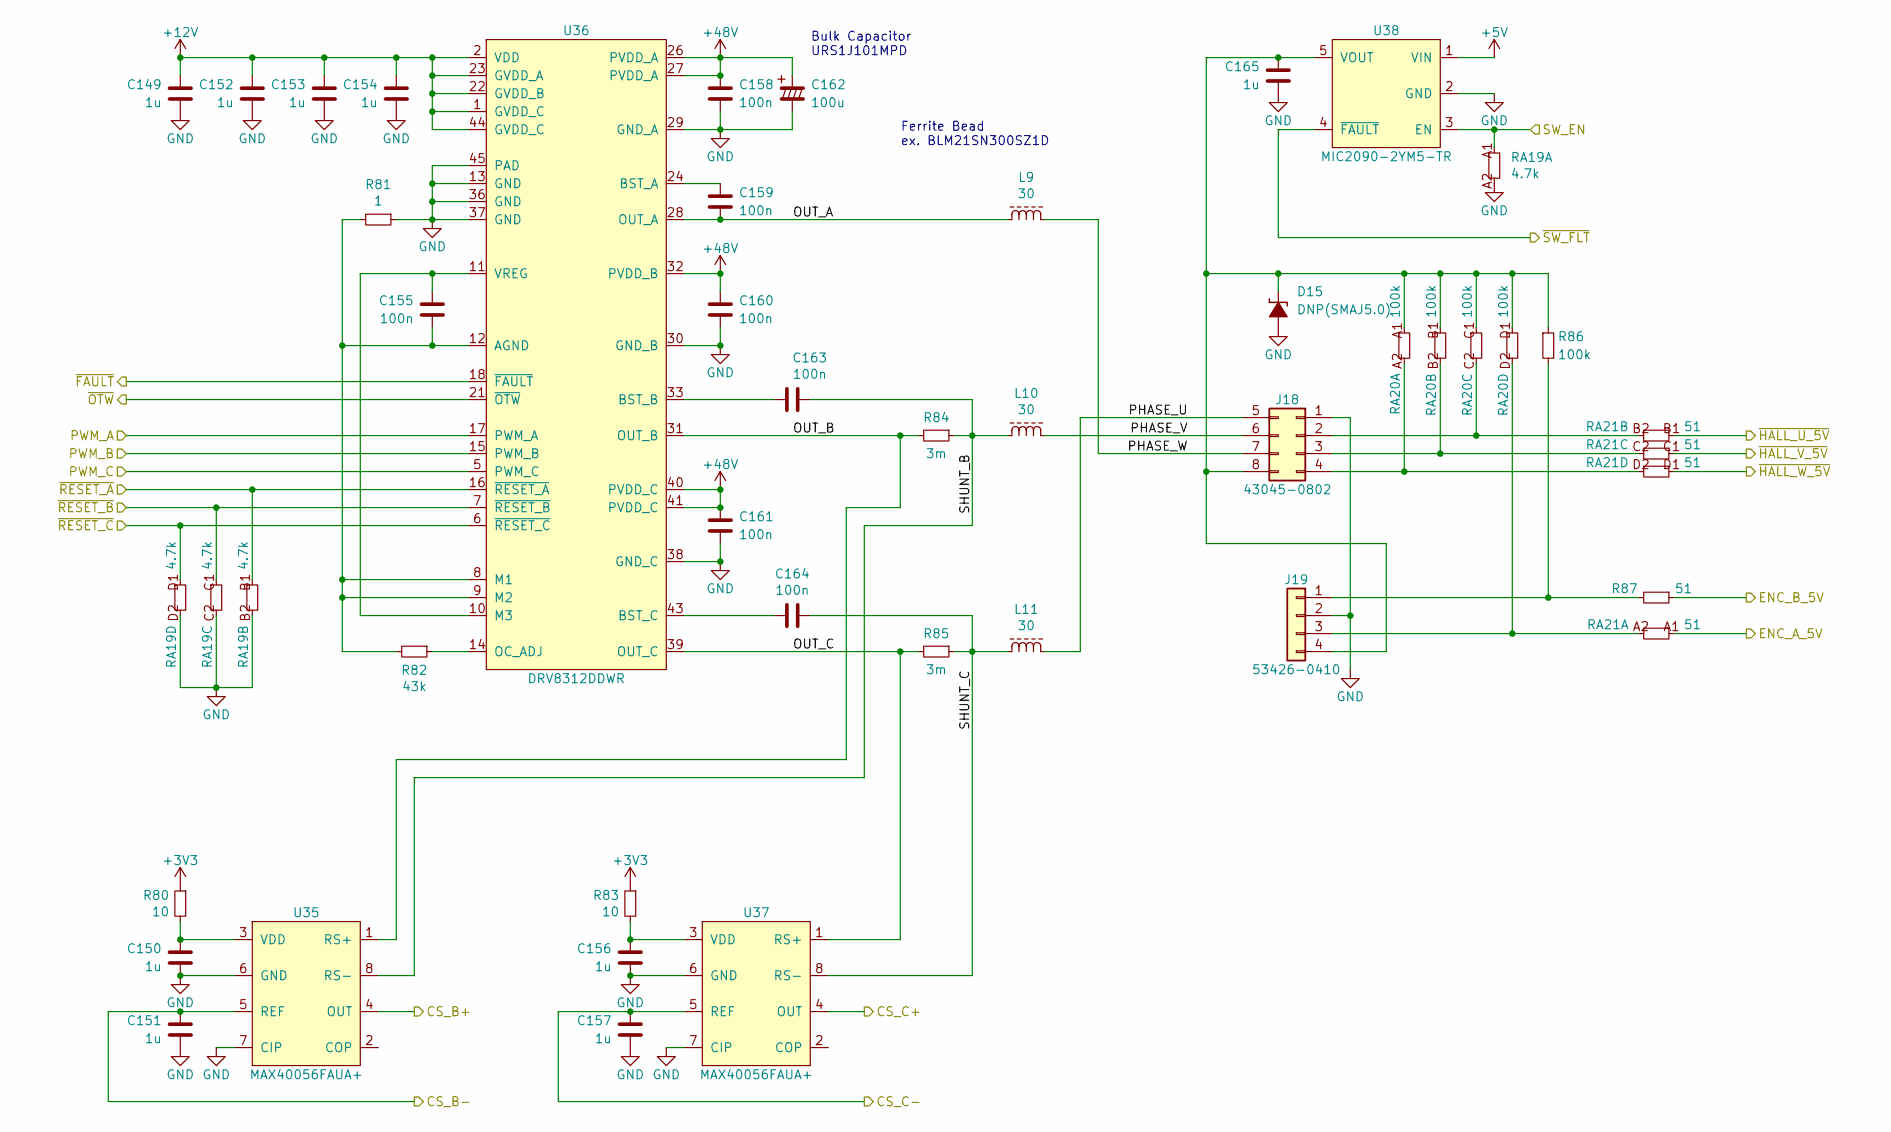
[picture p34: schematic MotorDriver1.sch]

Parts:
C149, C150, C151, C152, C153, C154, C156, C157, C165: 1u; C_CHIP_1005_Hand_NoSilk; PartName TMK105BJ105MV-F
C155, C159, C163, C164: 100n; C_CHIP_1005_Hand_NoSilk; PartName GRM155R71H104ME14D
C158, C160, C161: 100n; C_CHIP_1608_Reflow; PartName GCJ188R72A104KA01D
C162: 100u; C_RADIAL_10.0_P5.0_D0.6; PartName URS1J101MPD1TD
D15: DNP(SMAJ5.0); D_SMA(DO-214AC); PartName SMAJ5.0
J18: 43045-0802; 43045-080x; PartName 43045-0802
J19: 53426-0410; PartName 53426-0410
L9, L10, L11: 30; L_CHIP_2012_Reflow; PartName BLM21SN300SZ1D
R80, R83: 10; R_CHIP_1005_Hand_NoSilk; PartName RK73B1ETTP100J
R81: 1; R_CHIP_1005_Hand_NoSilk; PartName RK73B1ETTP1R0J
R82: 43k; R_CHIP_1005_Hand_NoSilk; PartName RK73H1ETTP4302F
R84, R85: 3m; R_CHIP_3216_Reflow; PartName PMR18EZPFV3L00
R86: 100k; R_CHIP_1005_Hand_NoSilk; PartName RK73H1ETTP1003F
R87: 51; R_CHIP_1005_Hand_NoSilk; PartName RK73B1ETTP510J
RA19: 4.7k; R_CHIP_4x1005_CONCAVE; PartName EXB-N8V472JX
RA20: 100k; R_CHIP_4x1005_CONCAVE; PartName EXB-N8V104JX
RA21: 51; R_CHIP_4x1005_CONCAVE; PartName EXB-N8V510JX
U35, U37: MAX40056FAUA+; MSOP8; PartName MAX40056FAUA+
U36: DRV8312DDWR; HTSSOP44-W6.1_EP4.31x8.26; PartName DRV8312DDWR
U38: MIC2090-2YM5-TR; SOT23-5; PartName MIC2090-2YM5-TR

Connections:
+3V3: R80.1, R83.1
+5V: U38.1 (VIN)
+12V: C149.1, C152.1, C153.1, C154.1, U36.1 (GVDD_C), U36.2 (VDD), U36.22 (GVDD_B), U36.23 (GVDD_A), U36.44 (GVDD_C)
+48V: C158.1, C160.1, C161.1, C162.1, U36.26 (PVDD_A), U36.27 (PVDD_A), U36.32 (PVDD_B), U36.40 (PVDD_C), U36.41 (PVDD_C)
CS_B+: U35.4 (OUT)
CS_B-: C151.1, U35.5 (REF)
CS_C+: U37.4 (OUT)
CS_C-: C157.1, U37.5 (REF)
ENC_A_5V: RA21.A1
ENC_B_5V: R87.1
GND: C149.2, C150.2, C151.2, C152.2, C153.2, C154.2, C156.2, C157.2, C158.2, C160.2, C161.2, C162.2, C165.2, D15.2 (A), J18.1, J19.2, R81.1, RA19.A2, RA19.B2, RA19.C2, RA19.D2, U35.6 (GND), U35.7 (CIP), U36.13 (GND), U36.29 (GND_A), U36.30 (GND_B), U36.36 (GND), U36.37 (GND), U36.38 (GND_C), U36.45 (PAD), U37.6 (GND), U37.7 (CIP), U38.2 (GND)
unnamed: C150.1, R80.2, U35.3 (VDD)
unnamed: C155.1, U36.10 (M3), U36.11 (VREG)
unnamed: C155.2, R81.2, R82.2, U36.8 (M1), U36.9 (M2), U36.12 (AGND)
unnamed: C156.1, R83.2, U37.3 (VDD)
unnamed: C159.1, U36.24 (BST_A)
unnamed: C163.1, U36.33 (BST_B)
unnamed: C164.1, U36.43 (BST_C)
unnamed: C165.1, D15.1 (K), J18.8, J19.4, R86.1, RA20.A1, RA20.B1, RA20.C1, RA20.D1, U38.5 (VOUT)
unnamed: J18.2, RA20.C2, RA21.B2
unnamed: J18.3, RA20.B2, RA21.C2
unnamed: J18.4, RA20.A2, RA21.D2
unnamed: J19.1, R86.2, R87.2
unnamed: J19.3, RA20.D2, RA21.A2
unnamed: R82.1, U36.14 (OC_ADJ)
OUT_A: C159.2, L9.1, U36.28 (OUT_A)
OUT_B: R84.2, U35.1 (RS+), U36.31 (OUT_B)
OUT_C: R85.2, U36.39 (OUT_C), U37.1 (RS+)
PHASE_U: J18.5, L11.2
PHASE_V: J18.6, L10.2
PHASE_W: J18.7, L9.2
PWM_A: U36.17 (PWM_A)
PWM_B: U36.15 (PWM_B)
PWM_C: U36.5 (PWM_C)
SHUNT_B: C163.2, L10.1, R84.1, U35.8 (RS-)
SHUNT_C: C164.2, L11.1, R85.1, U37.8 (RS-)
SW_EN: RA19.A1, U38.3 (EN)
~FAULT: U36.18 (~FAULT)
~HALL_U_5V: RA21.B1
~HALL_V_5V: RA21.C1
~HALL_W_5V: RA21.D1
~OTW: U36.21 (~OTW)
~RESET_A: RA19.B1, U36.16 (~RESET_A)
~RESET_B: RA19.C1, U36.7 (~RESET_B)
~RESET_C: RA19.D1, U36.6 (~RESET_C)
~SW_FLT: U38.4 (~FAULT)

Notes on the sheet:
Ferrite Bead ex. BLM21SN300SZ1D
Bulk Capacitor URS1J101MPD
