Nkyoku/phoenix-pcb/MotorDriver2.sch

## KiCad design MotorDriver2.sch (2020-08-01)

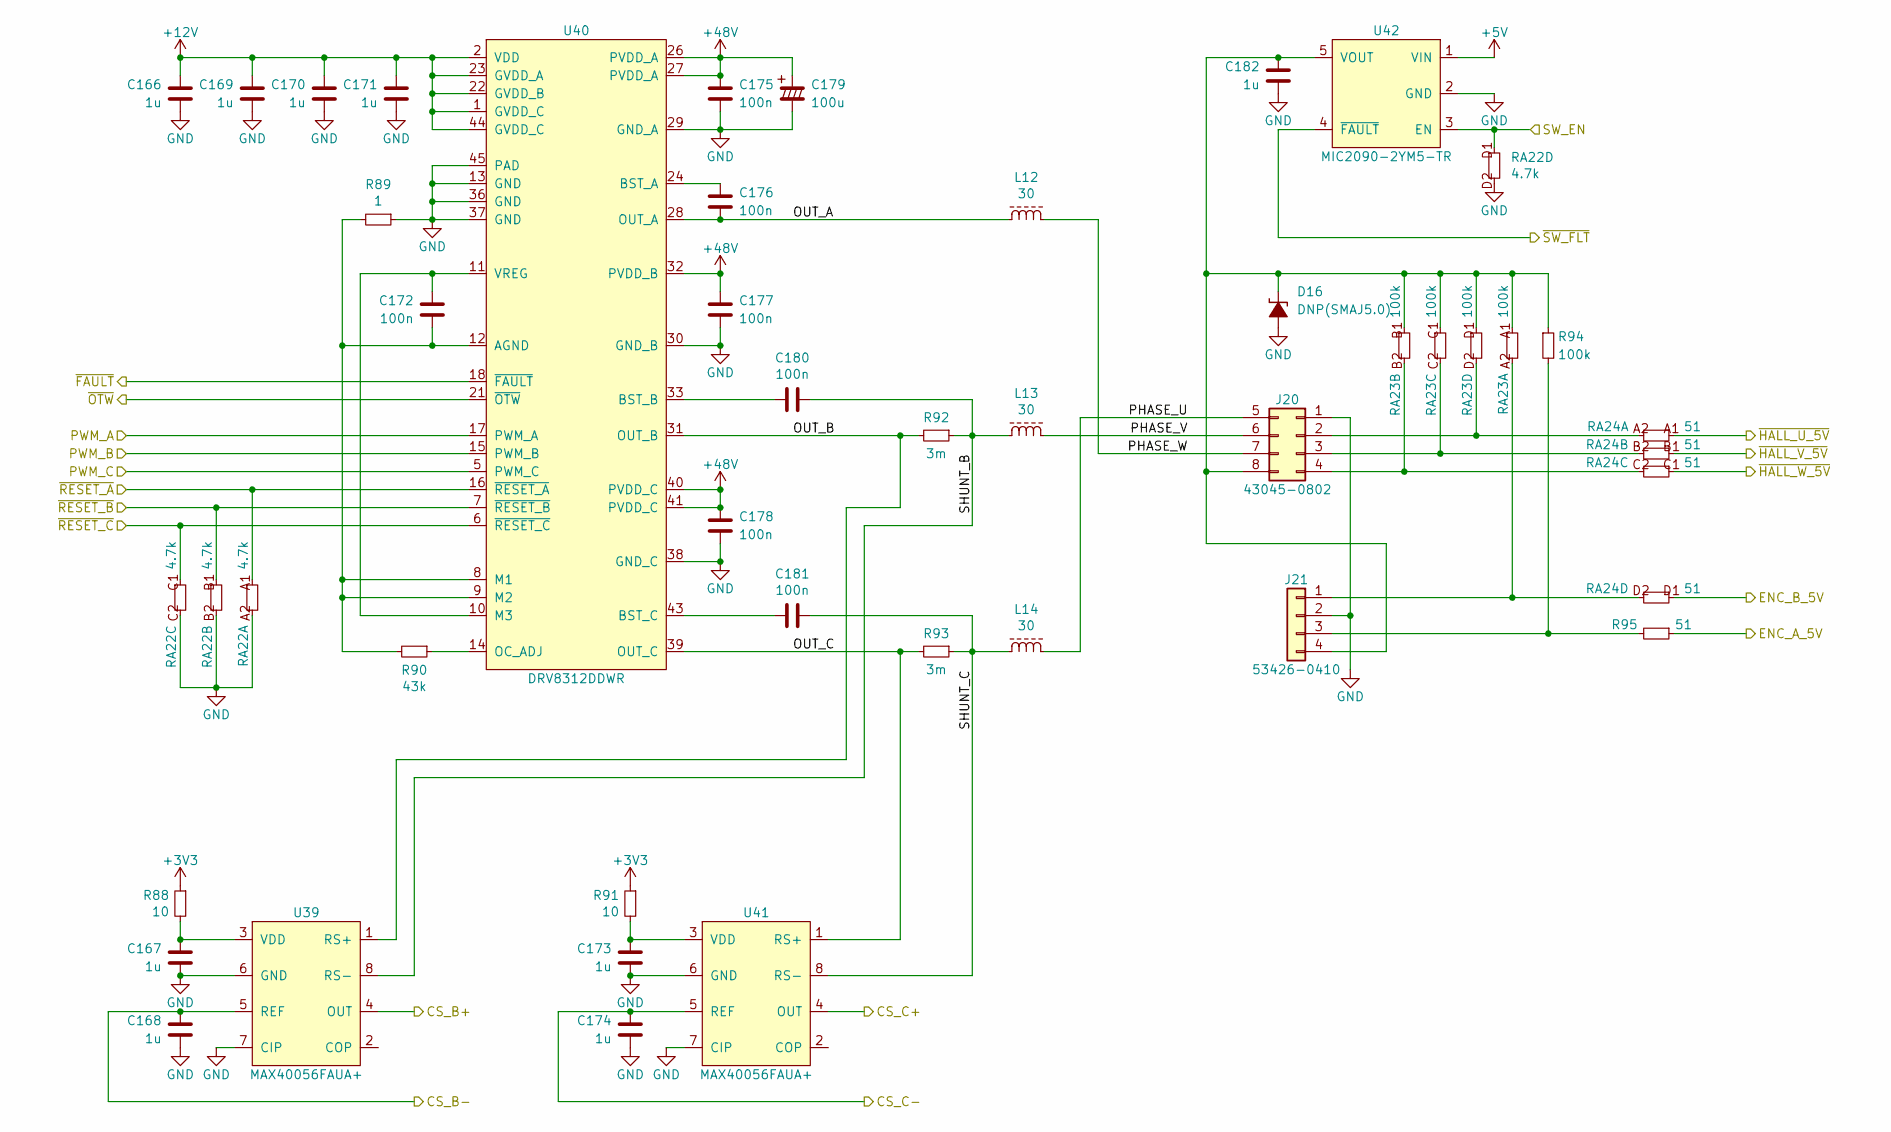
[picture p35: schematic MotorDriver2.sch]

Parts:
C166, C167, C168, C169, C170, C171, C173, C174, C182: 1u; C_CHIP_1005_Hand_NoSilk; PartName TMK105BJ105MV-F
C172, C176, C180, C181: 100n; C_CHIP_1005_Hand_NoSilk; PartName GRM155R71H104ME14D
C175, C177, C178: 100n; C_CHIP_1608_Reflow; PartName GCJ188R72A104KA01D
C179: 100u; C_RADIAL_10.0_P5.0_D0.6; PartName URS1J101MPD1TD
D16: DNP(SMAJ5.0); D_SMA(DO-214AC); PartName SMAJ5.0
J20: 43045-0802; 43045-080x; PartName 43045-0802
J21: 53426-0410; PartName 53426-0410
L12, L13, L14: 30; L_CHIP_2012_Reflow; PartName BLM21SN300SZ1D
R88, R91: 10; R_CHIP_1005_Hand_NoSilk; PartName RK73B1ETTP100J
R89: 1; R_CHIP_1005_Hand_NoSilk; PartName RK73B1ETTP1R0J
R90: 43k; R_CHIP_1005_Hand_NoSilk; PartName RK73H1ETTP4302F
R92, R93: 3m; R_CHIP_3216_Reflow; PartName PMR18EZPFV3L00
R94: 100k; R_CHIP_1005_Hand_NoSilk; PartName RK73H1ETTP1003F
R95: 51; R_CHIP_1005_Hand_NoSilk; PartName RK73B1ETTP510J
RA22: 4.7k; R_CHIP_4x1005_CONCAVE; PartName EXB-N8V472JX
RA23: 100k; R_CHIP_4x1005_CONCAVE; PartName EXB-N8V104JX
RA24: 51; R_CHIP_4x1005_CONCAVE; PartName EXB-N8V510JX
U39, U41: MAX40056FAUA+; MSOP8; PartName MAX40056FAUA+
U40: DRV8312DDWR; HTSSOP44-W6.1_EP4.31x8.26; PartName DRV8312DDWR
U42: MIC2090-2YM5-TR; SOT23-5; PartName MIC2090-2YM5-TR

Connections:
+3V3: R88.1, R91.1
+5V: U42.1 (VIN)
+12V: C166.1, C169.1, C170.1, C171.1, U40.1 (GVDD_C), U40.2 (VDD), U40.22 (GVDD_B), U40.23 (GVDD_A), U40.44 (GVDD_C)
+48V: C175.1, C177.1, C178.1, C179.1, U40.26 (PVDD_A), U40.27 (PVDD_A), U40.32 (PVDD_B), U40.40 (PVDD_C), U40.41 (PVDD_C)
CS_B+: U39.4 (OUT)
CS_B-: C168.1, U39.5 (REF)
CS_C+: U41.4 (OUT)
CS_C-: C174.1, U41.5 (REF)
ENC_A_5V: R95.1
ENC_B_5V: RA24.D1
GND: C166.2, C167.2, C168.2, C169.2, C170.2, C171.2, C173.2, C174.2, C175.2, C177.2, C178.2, C179.2, C182.2, D16.2 (A), J20.1, J21.2, R89.1, RA22.A2, RA22.B2, RA22.C2, RA22.D2, U39.6 (GND), U39.7 (CIP), U40.13 (GND), U40.29 (GND_A), U40.30 (GND_B), U40.36 (GND), U40.37 (GND), U40.38 (GND_C), U40.45 (PAD), U41.6 (GND), U41.7 (CIP), U42.2 (GND)
unnamed: C167.1, R88.2, U39.3 (VDD)
unnamed: C172.1, U40.10 (M3), U40.11 (VREG)
unnamed: C172.2, R89.2, R90.2, U40.8 (M1), U40.9 (M2), U40.12 (AGND)
unnamed: C173.1, R91.2, U41.3 (VDD)
unnamed: C176.1, U40.24 (BST_A)
unnamed: C180.1, U40.33 (BST_B)
unnamed: C181.1, U40.43 (BST_C)
unnamed: C182.1, D16.1 (K), J20.8, J21.4, R94.1, RA23.A1, RA23.B1, RA23.C1, RA23.D1, U42.5 (VOUT)
unnamed: J20.2, RA23.D2, RA24.A2
unnamed: J20.3, RA23.C2, RA24.B2
unnamed: J20.4, RA23.B2, RA24.C2
unnamed: J21.1, RA23.A2, RA24.D2
unnamed: J21.3, R94.2, R95.2
unnamed: R90.1, U40.14 (OC_ADJ)
OUT_A: C176.2, L12.1, U40.28 (OUT_A)
OUT_B: R92.2, U39.1 (RS+), U40.31 (OUT_B)
OUT_C: R93.2, U40.39 (OUT_C), U41.1 (RS+)
PHASE_U: J20.5, L14.2
PHASE_V: J20.6, L13.2
PHASE_W: J20.7, L12.2
PWM_A: U40.17 (PWM_A)
PWM_B: U40.15 (PWM_B)
PWM_C: U40.5 (PWM_C)
SHUNT_B: C180.2, L13.1, R92.1, U39.8 (RS-)
SHUNT_C: C181.2, L14.1, R93.1, U41.8 (RS-)
SW_EN: RA22.D1, U42.3 (EN)
~FAULT: U40.18 (~FAULT)
~HALL_U_5V: RA24.A1
~HALL_V_5V: RA24.B1
~HALL_W_5V: RA24.C1
~OTW: U40.21 (~OTW)
~RESET_A: RA22.A1, U40.16 (~RESET_A)
~RESET_B: RA22.B1, U40.7 (~RESET_B)
~RESET_C: RA22.C1, U40.6 (~RESET_C)
~SW_FLT: U42.4 (~FAULT)
