Nkyoku/phoenix-pcb/MotorDriver3.sch

## KiCad design MotorDriver3.sch (2020-08-01)

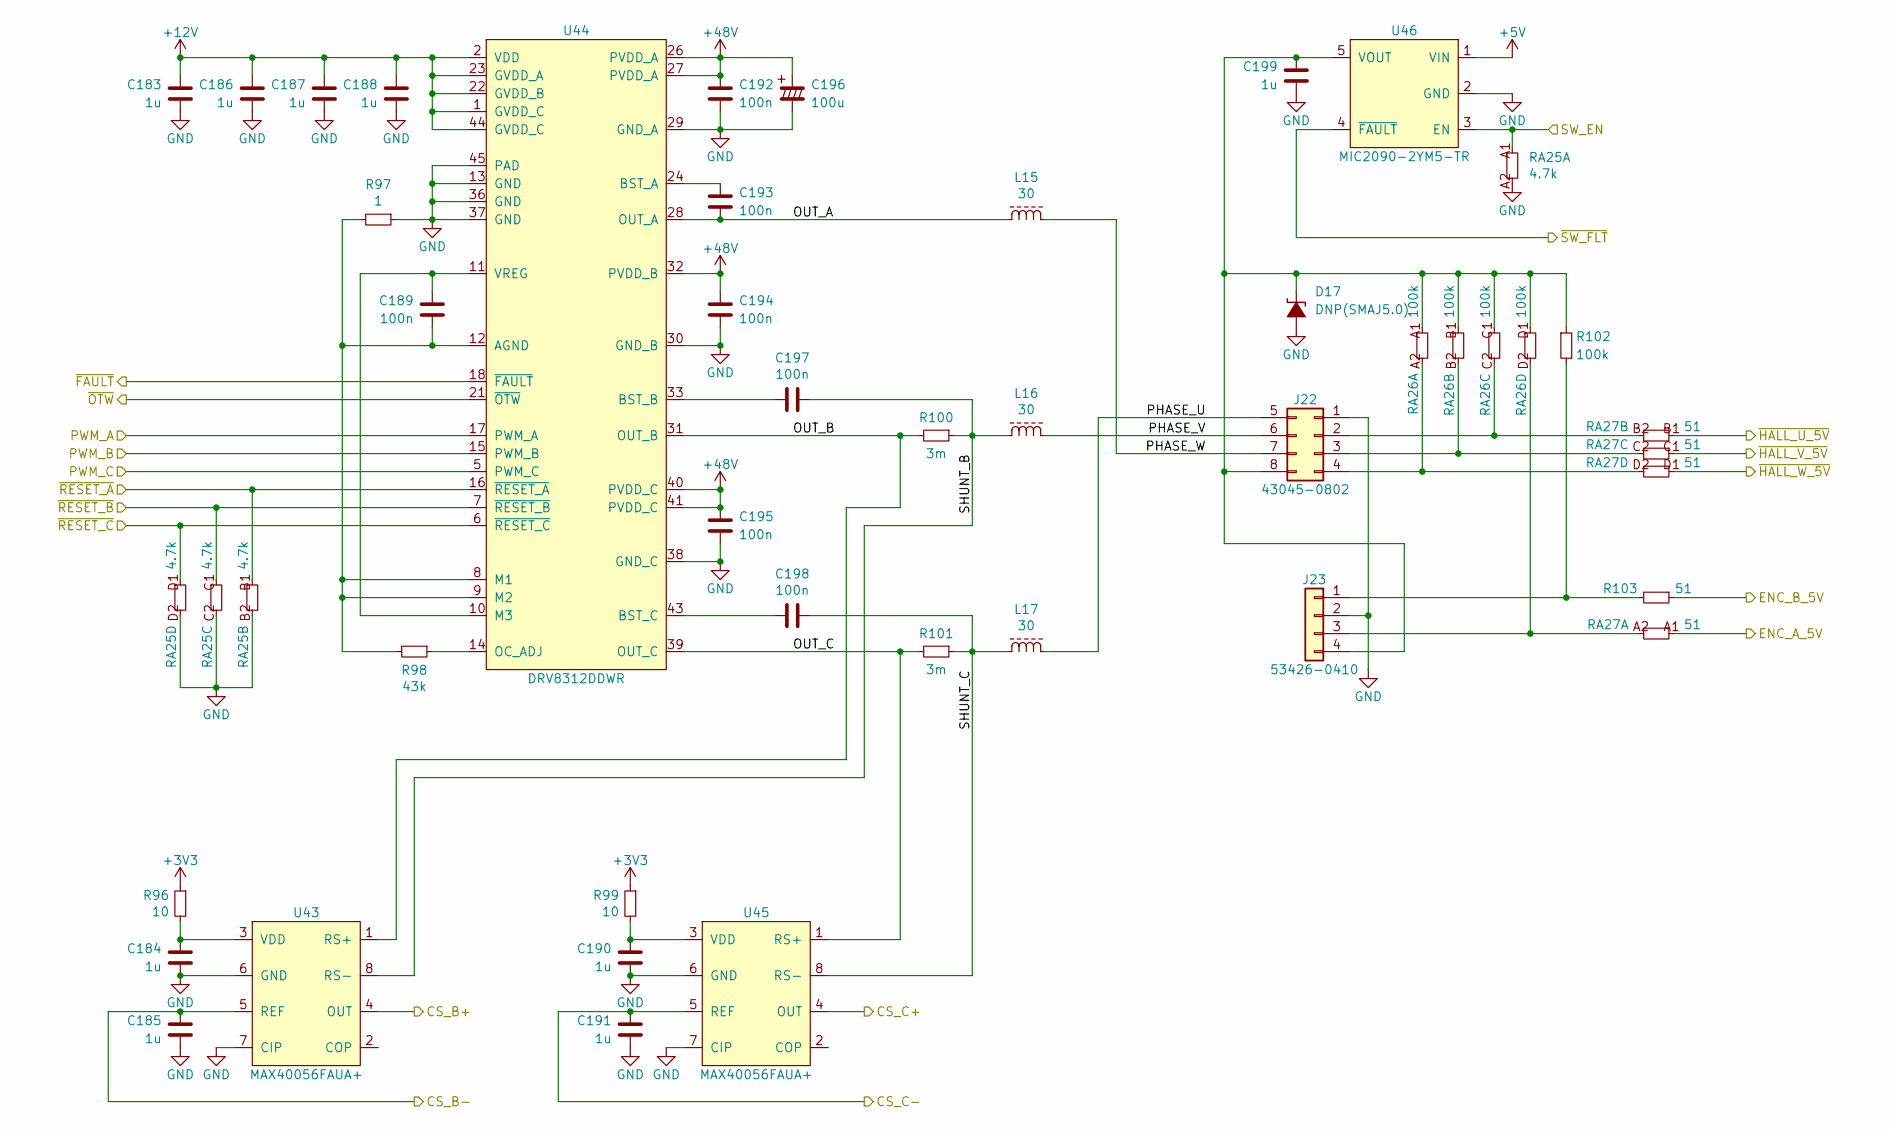
[picture p36: schematic MotorDriver3.sch]

Parts:
C183, C184, C185, C186, C187, C188, C190, C191, C199: 1u; C_CHIP_1005_Hand_NoSilk; PartName TMK105BJ105MV-F
C189, C193, C197, C198: 100n; C_CHIP_1005_Hand_NoSilk; PartName GRM155R71H104ME14D
C192, C194, C195: 100n; C_CHIP_1608_Reflow; PartName GCJ188R72A104KA01D
C196: 100u; C_RADIAL_10.0_P5.0_D0.6; PartName URS1J101MPD1TD
D17: DNP(SMAJ5.0); D_SMA(DO-214AC); PartName SMAJ5.0
J22: 43045-0802; 43045-080x; PartName 43045-0802
J23: 53426-0410; PartName 53426-0410
L15, L16, L17: 30; L_CHIP_2012_Reflow; PartName BLM21SN300SZ1D
R96, R99: 10; R_CHIP_1005_Hand_NoSilk; PartName RK73B1ETTP100J
R97: 1; R_CHIP_1005_Hand_NoSilk; PartName RK73B1ETTP1R0J
R98: 43k; R_CHIP_1005_Hand_NoSilk; PartName RK73H1ETTP4302F
R100, R101: 3m; R_CHIP_3216_Reflow; PartName PMR18EZPFV3L00
R102: 100k; R_CHIP_1005_Hand_NoSilk; PartName RK73H1ETTP1003F
R103: 51; R_CHIP_1005_Hand_NoSilk; PartName RK73B1ETTP510J
RA25: 4.7k; R_CHIP_4x1005_CONCAVE; PartName EXB-N8V472JX
RA26: 100k; R_CHIP_4x1005_CONCAVE; PartName EXB-N8V104JX
RA27: 51; R_CHIP_4x1005_CONCAVE; PartName EXB-N8V510JX
U43, U45: MAX40056FAUA+; MSOP8; PartName MAX40056FAUA+
U44: DRV8312DDWR; HTSSOP44-W6.1_EP4.31x8.26; PartName DRV8312DDWR
U46: MIC2090-2YM5-TR; SOT23-5; PartName MIC2090-2YM5-TR

Connections:
+3V3: R96.1, R99.1
+5V: U46.1 (VIN)
+12V: C183.1, C186.1, C187.1, C188.1, U44.1 (GVDD_C), U44.2 (VDD), U44.22 (GVDD_B), U44.23 (GVDD_A), U44.44 (GVDD_C)
+48V: C192.1, C194.1, C195.1, C196.1, U44.26 (PVDD_A), U44.27 (PVDD_A), U44.32 (PVDD_B), U44.40 (PVDD_C), U44.41 (PVDD_C)
CS_B+: U43.4 (OUT)
CS_B-: C185.1, U43.5 (REF)
CS_C+: U45.4 (OUT)
CS_C-: C191.1, U45.5 (REF)
ENC_A_5V: RA27.A1
ENC_B_5V: R103.1
GND: C183.2, C184.2, C185.2, C186.2, C187.2, C188.2, C190.2, C191.2, C192.2, C194.2, C195.2, C196.2, C199.2, D17.2 (A), J22.1, J23.2, R97.1, RA25.A2, RA25.B2, RA25.C2, RA25.D2, U43.6 (GND), U43.7 (CIP), U44.13 (GND), U44.29 (GND_A), U44.30 (GND_B), U44.36 (GND), U44.37 (GND), U44.38 (GND_C), U44.45 (PAD), U45.6 (GND), U45.7 (CIP), U46.2 (GND)
unnamed: C184.1, R96.2, U43.3 (VDD)
unnamed: C189.1, U44.10 (M3), U44.11 (VREG)
unnamed: C189.2, R97.2, R98.2, U44.8 (M1), U44.9 (M2), U44.12 (AGND)
unnamed: C190.1, R99.2, U45.3 (VDD)
unnamed: C193.1, U44.24 (BST_A)
unnamed: C197.1, U44.33 (BST_B)
unnamed: C198.1, U44.43 (BST_C)
unnamed: C199.1, D17.1 (K), J22.8, J23.4, R102.1, RA26.A1, RA26.B1, RA26.C1, RA26.D1, U46.5 (VOUT)
unnamed: J22.2, RA26.C2, RA27.B2
unnamed: J22.3, RA26.B2, RA27.C2
unnamed: J22.4, RA26.A2, RA27.D2
unnamed: J23.1, R102.2, R103.2
unnamed: J23.3, RA26.D2, RA27.A2
unnamed: R98.1, U44.14 (OC_ADJ)
OUT_A: C193.2, L15.1, U44.28 (OUT_A)
OUT_B: R100.2, U43.1 (RS+), U44.31 (OUT_B)
OUT_C: R101.2, U44.39 (OUT_C), U45.1 (RS+)
PHASE_U: J22.5, L17.2
PHASE_V: J22.6, L16.2
PHASE_W: J22.7, L15.2
PWM_A: U44.17 (PWM_A)
PWM_B: U44.15 (PWM_B)
PWM_C: U44.5 (PWM_C)
SHUNT_B: C197.2, L16.1, R100.1, U43.8 (RS-)
SHUNT_C: C198.2, L17.1, R101.1, U45.8 (RS-)
SW_EN: RA25.A1, U46.3 (EN)
~FAULT: U44.18 (~FAULT)
~HALL_U_5V: RA27.B1
~HALL_V_5V: RA27.C1
~HALL_W_5V: RA27.D1
~OTW: U44.21 (~OTW)
~RESET_A: RA25.B1, U44.16 (~RESET_A)
~RESET_B: RA25.C1, U44.7 (~RESET_B)
~RESET_C: RA25.D1, U44.6 (~RESET_C)
~SW_FLT: U46.4 (~FAULT)
