Nkyoku/phoenix-pcb/MotorDriver4.sch

## KiCad design MotorDriver4.sch (2020-08-01)

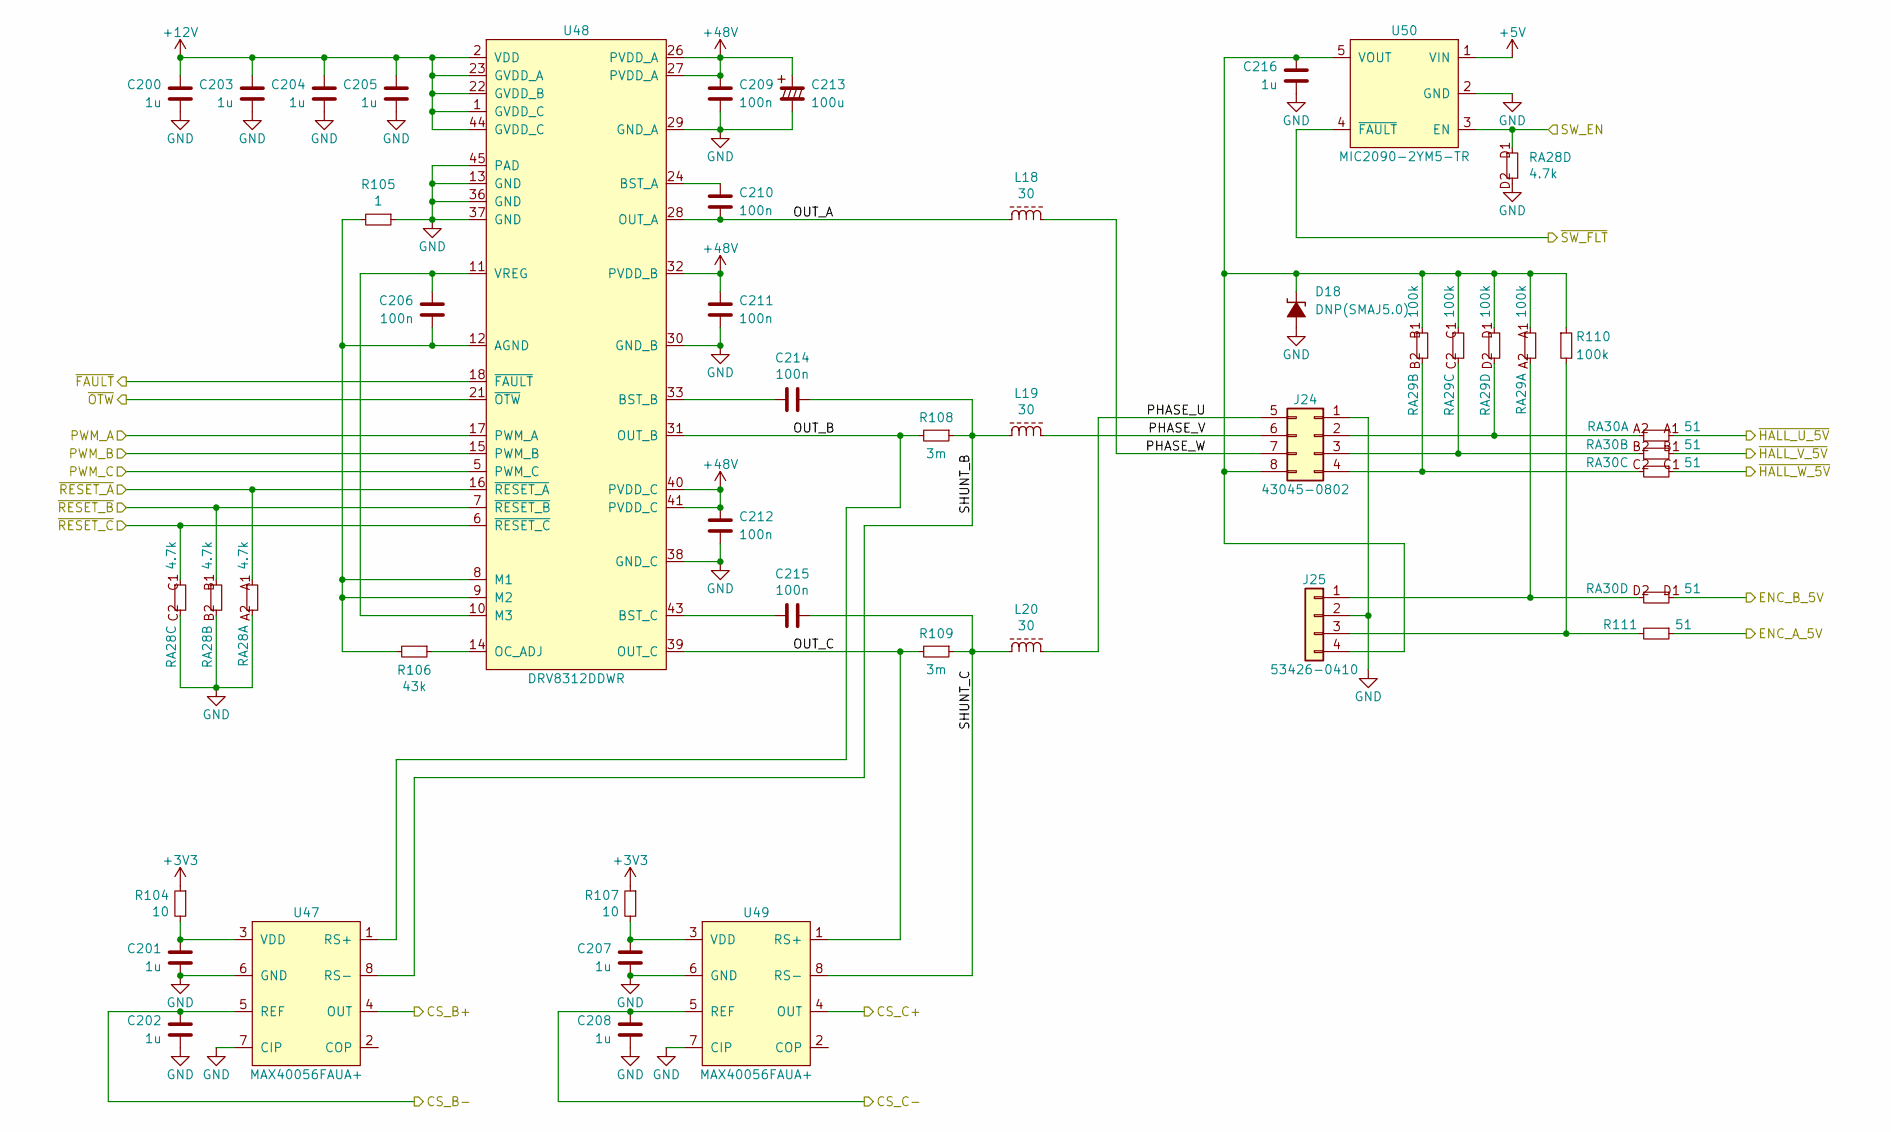
[picture p37: schematic MotorDriver4.sch]

Parts:
C200, C201, C202, C203, C204, C205, C207, C208, C216: 1u; C_CHIP_1005_Hand_NoSilk; PartName TMK105BJ105MV-F
C206, C210, C214, C215: 100n; C_CHIP_1005_Hand_NoSilk; PartName GRM155R71H104ME14D
C209, C211, C212: 100n; C_CHIP_1608_Reflow; PartName GCJ188R72A104KA01D
C213: 100u; C_RADIAL_10.0_P5.0_D0.6; PartName URS1J101MPD1TD
D18: DNP(SMAJ5.0); D_SMA(DO-214AC); PartName SMAJ5.0
J24: 43045-0802; 43045-080x; PartName 43045-0802
J25: 53426-0410; PartName 53426-0410
L18, L19, L20: 30; L_CHIP_2012_Reflow; PartName BLM21SN300SZ1D
R104, R107: 10; R_CHIP_1005_Hand_NoSilk; PartName RK73B1ETTP100J
R105: 1; R_CHIP_1005_Hand_NoSilk; PartName RK73B1ETTP1R0J
R106: 43k; R_CHIP_1005_Hand_NoSilk; PartName RK73H1ETTP4302F
R108, R109: 3m; R_CHIP_3216_Reflow; PartName PMR18EZPFV3L00
R110: 100k; R_CHIP_1005_Hand_NoSilk; PartName RK73H1ETTP1003F
R111: 51; R_CHIP_1005_Hand_NoSilk; PartName RK73B1ETTP510J
RA28: 4.7k; R_CHIP_4x1005_CONCAVE; PartName EXB-N8V472JX
RA29: 100k; R_CHIP_4x1005_CONCAVE; PartName EXB-N8V104JX
RA30: 51; R_CHIP_4x1005_CONCAVE; PartName EXB-N8V510JX
U47, U49: MAX40056FAUA+; MSOP8; PartName MAX40056FAUA+
U48: DRV8312DDWR; HTSSOP44-W6.1_EP4.31x8.26; PartName DRV8312DDWR
U50: MIC2090-2YM5-TR; SOT23-5; PartName MIC2090-2YM5-TR

Connections:
+3V3: R104.1, R107.1
+5V: U50.1 (VIN)
+12V: C200.1, C203.1, C204.1, C205.1, U48.1 (GVDD_C), U48.2 (VDD), U48.22 (GVDD_B), U48.23 (GVDD_A), U48.44 (GVDD_C)
+48V: C209.1, C211.1, C212.1, C213.1, U48.26 (PVDD_A), U48.27 (PVDD_A), U48.32 (PVDD_B), U48.40 (PVDD_C), U48.41 (PVDD_C)
CS_B+: U47.4 (OUT)
CS_B-: C202.1, U47.5 (REF)
CS_C+: U49.4 (OUT)
CS_C-: C208.1, U49.5 (REF)
ENC_A_5V: R111.1
ENC_B_5V: RA30.D1
GND: C200.2, C201.2, C202.2, C203.2, C204.2, C205.2, C207.2, C208.2, C209.2, C211.2, C212.2, C213.2, C216.2, D18.2 (A), J24.1, J25.2, R105.1, RA28.A2, RA28.B2, RA28.C2, RA28.D2, U47.6 (GND), U47.7 (CIP), U48.13 (GND), U48.29 (GND_A), U48.30 (GND_B), U48.36 (GND), U48.37 (GND), U48.38 (GND_C), U48.45 (PAD), U49.6 (GND), U49.7 (CIP), U50.2 (GND)
unnamed: C201.1, R104.2, U47.3 (VDD)
unnamed: C206.1, U48.10 (M3), U48.11 (VREG)
unnamed: C206.2, R105.2, R106.2, U48.8 (M1), U48.9 (M2), U48.12 (AGND)
unnamed: C207.1, R107.2, U49.3 (VDD)
unnamed: C210.1, U48.24 (BST_A)
unnamed: C214.1, U48.33 (BST_B)
unnamed: C215.1, U48.43 (BST_C)
unnamed: C216.1, D18.1 (K), J24.8, J25.4, R110.1, RA29.A1, RA29.B1, RA29.C1, RA29.D1, U50.5 (VOUT)
unnamed: J24.2, RA29.D2, RA30.A2
unnamed: J24.3, RA29.C2, RA30.B2
unnamed: J24.4, RA29.B2, RA30.C2
unnamed: J25.1, RA29.A2, RA30.D2
unnamed: J25.3, R110.2, R111.2
unnamed: R106.1, U48.14 (OC_ADJ)
OUT_A: C210.2, L18.1, U48.28 (OUT_A)
OUT_B: R108.2, U47.1 (RS+), U48.31 (OUT_B)
OUT_C: R109.2, U48.39 (OUT_C), U49.1 (RS+)
PHASE_U: J24.5, L20.2
PHASE_V: J24.6, L19.2
PHASE_W: J24.7, L18.2
PWM_A: U48.17 (PWM_A)
PWM_B: U48.15 (PWM_B)
PWM_C: U48.5 (PWM_C)
SHUNT_B: C214.2, L19.1, R108.1, U47.8 (RS-)
SHUNT_C: C215.2, L20.1, R109.1, U49.8 (RS-)
SW_EN: RA28.D1, U50.3 (EN)
~FAULT: U48.18 (~FAULT)
~HALL_U_5V: RA30.A1
~HALL_V_5V: RA30.B1
~HALL_W_5V: RA30.C1
~OTW: U48.21 (~OTW)
~RESET_A: RA28.A1, U48.16 (~RESET_A)
~RESET_B: RA28.B1, U48.7 (~RESET_B)
~RESET_C: RA28.C1, U48.6 (~RESET_C)
~SW_FLT: U50.4 (~FAULT)
