Nkyoku/phoenix-pcb/MotorDriver5.sch

## KiCad design MotorDriver5.sch (2020-08-01)

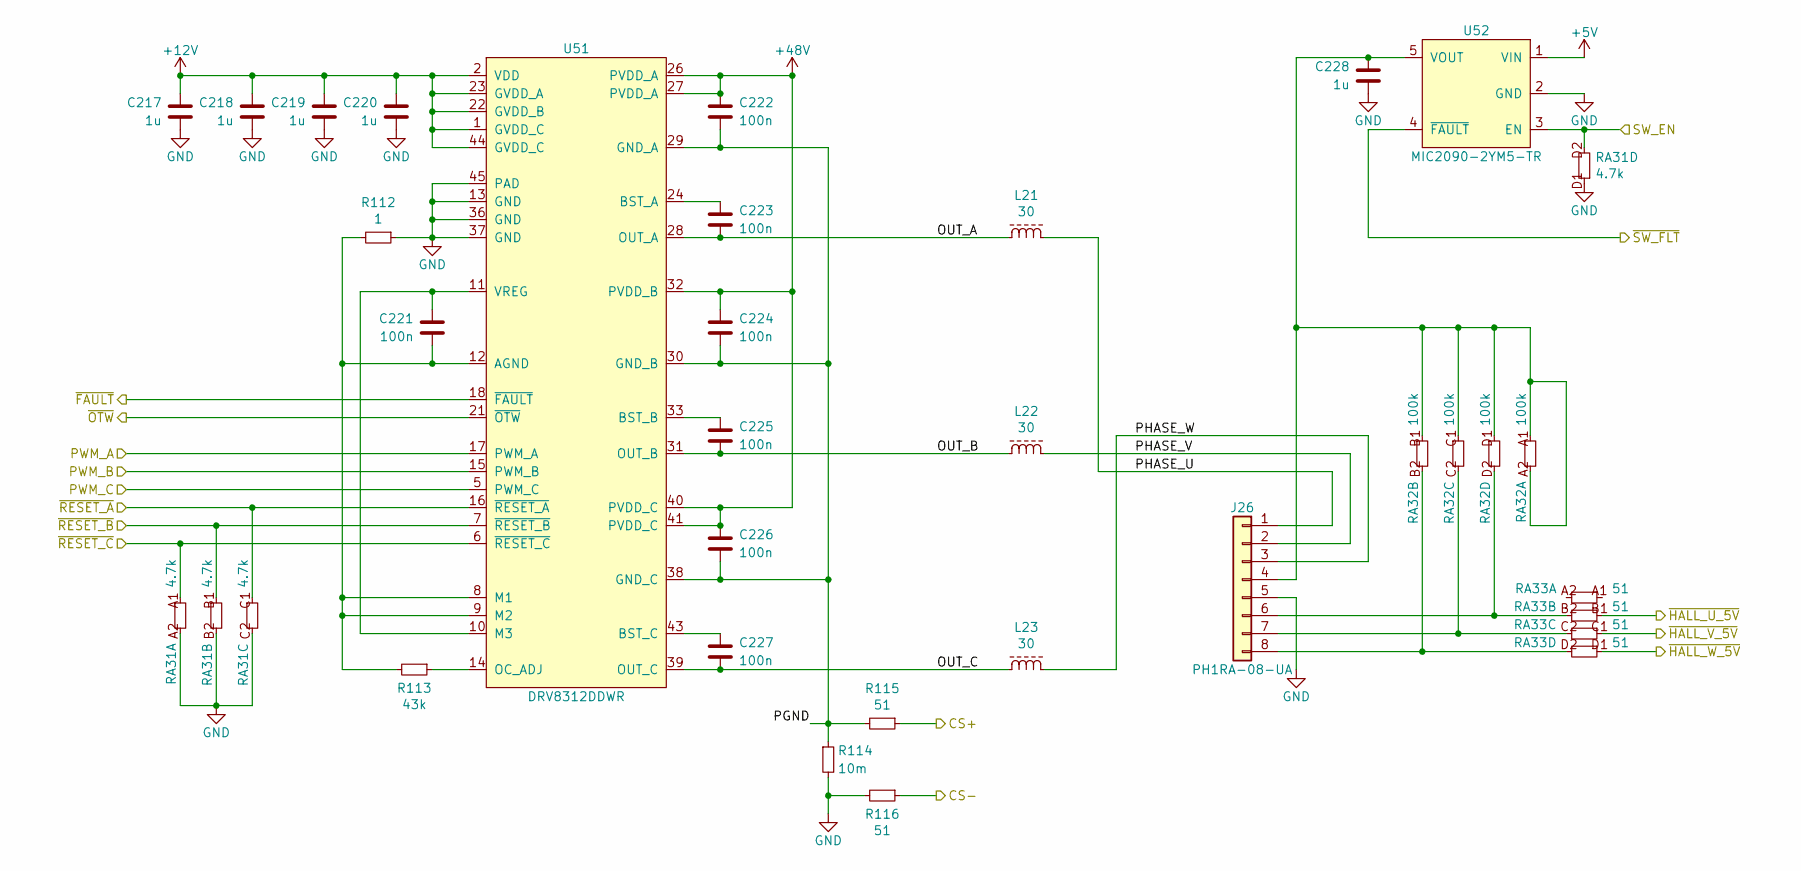
[picture p38: schematic MotorDriver5.sch]

Parts:
C217, C218, C219, C220, C228: 1u; C_CHIP_1005_Hand_NoSilk; PartName TMK105BJ105MV-F
C221, C223, C225, C227: 100n; C_CHIP_1005_Hand_NoSilk; PartName GRM155R71H104ME14D
C222, C224, C226: 100n; C_CHIP_1608_Reflow; PartName GCJ188R72A104KA01D
J26: PH1RA-08-UA; WF2512-Horizontal; PartName PH1RA-08-UA
L21, L22, L23: 30; L_CHIP_2012_Reflow; PartName BLM21SN300SZ1D
R112: 1; R_CHIP_1005_Hand_NoSilk; PartName RK73B1ETTP1R0J
R113: 43k; R_CHIP_1005_Hand_NoSilk; PartName RK73H1ETTP4302F
R114: 10m; R_CHIP_3216_Reflow; PartName ERJ-8CWJR010V
R115, R116: 51; R_CHIP_1005_Hand_NoSilk; PartName RK73B1ETTP510J
RA31: 4.7k; R_CHIP_4x1005_CONCAVE; PartName EXB-N8V472JX
RA32: 100k; R_CHIP_4x1005_CONCAVE; PartName EXB-N8V104JX
RA33: 51; R_CHIP_4x1005_CONCAVE; PartName EXB-N8V510JX
U51: DRV8312DDWR; HTSSOP44-W6.1_EP4.31x8.26; PartName DRV8312DDWR
U52: MIC2090-2YM5-TR; SOT23-5; PartName MIC2090-2YM5-TR

Connections:
+5V: U52.1 (VIN)
+12V: C217.1, C218.1, C219.1, C220.1, U51.1 (GVDD_C), U51.2 (VDD), U51.22 (GVDD_B), U51.23 (GVDD_A), U51.44 (GVDD_C)
+48V: C222.1, C224.1, C226.1, U51.26 (PVDD_A), U51.27 (PVDD_A), U51.32 (PVDD_B), U51.40 (PVDD_C), U51.41 (PVDD_C)
CS+: R115.1
CS-: R116.1
GND: C217.2, C218.2, C219.2, C220.2, C228.2, J26.5, R112.1, R114.2, R116.2, RA31.A2, RA31.B2, RA31.C2, RA31.D1, U51.13 (GND), U51.36 (GND), U51.37 (GND), U51.45 (PAD), U52.2 (GND)
unnamed: C221.1, U51.10 (M3), U51.11 (VREG)
unnamed: C221.2, R112.2, R113.2, U51.8 (M1), U51.9 (M2), U51.12 (AGND)
unnamed: C223.1, U51.24 (BST_A)
unnamed: C225.1, U51.33 (BST_B)
unnamed: C227.1, U51.43 (BST_C)
unnamed: C228.1, J26.4, RA32.A1, RA32.A2, RA32.B1, RA32.C1, RA32.D1, U52.5 (VOUT)
unnamed: J26.6, RA32.D2, RA33.B2
unnamed: J26.7, RA32.C2, RA33.C2
unnamed: J26.8, RA32.B2, RA33.D2
unnamed: R113.1, U51.14 (OC_ADJ)
OUT_A: C223.2, L21.1, U51.28 (OUT_A)
OUT_B: C225.2, L22.1, U51.31 (OUT_B)
OUT_C: C227.2, L23.1, U51.39 (OUT_C)
PGND: C222.2, C224.2, C226.2, R114.1, R115.2, U51.29 (GND_A), U51.30 (GND_B), U51.38 (GND_C)
PHASE_U: J26.1, L21.2
PHASE_V: J26.2, L22.2
PHASE_W: J26.3, L23.2
PWM_A: U51.17 (PWM_A)
PWM_B: U51.15 (PWM_B)
PWM_C: U51.5 (PWM_C)
SW_EN: RA31.D2, U52.3 (EN)
~FAULT: U51.18 (~FAULT)
~HALL_U_5V: RA33.B1
~HALL_V_5V: RA33.C1
~HALL_W_5V: RA33.D1
~OTW: U51.21 (~OTW)
~RESET_A: RA31.C1, U51.16 (~RESET_A)
~RESET_B: RA31.B1, U51.7 (~RESET_B)
~RESET_C: RA31.A1, U51.6 (~RESET_C)
~SW_FLT: U52.4 (~FAULT)
