Nkyoku/phoenix-pcb/Phoenix.sch

## KiCad design Phoenix.sch (2021-03-21)

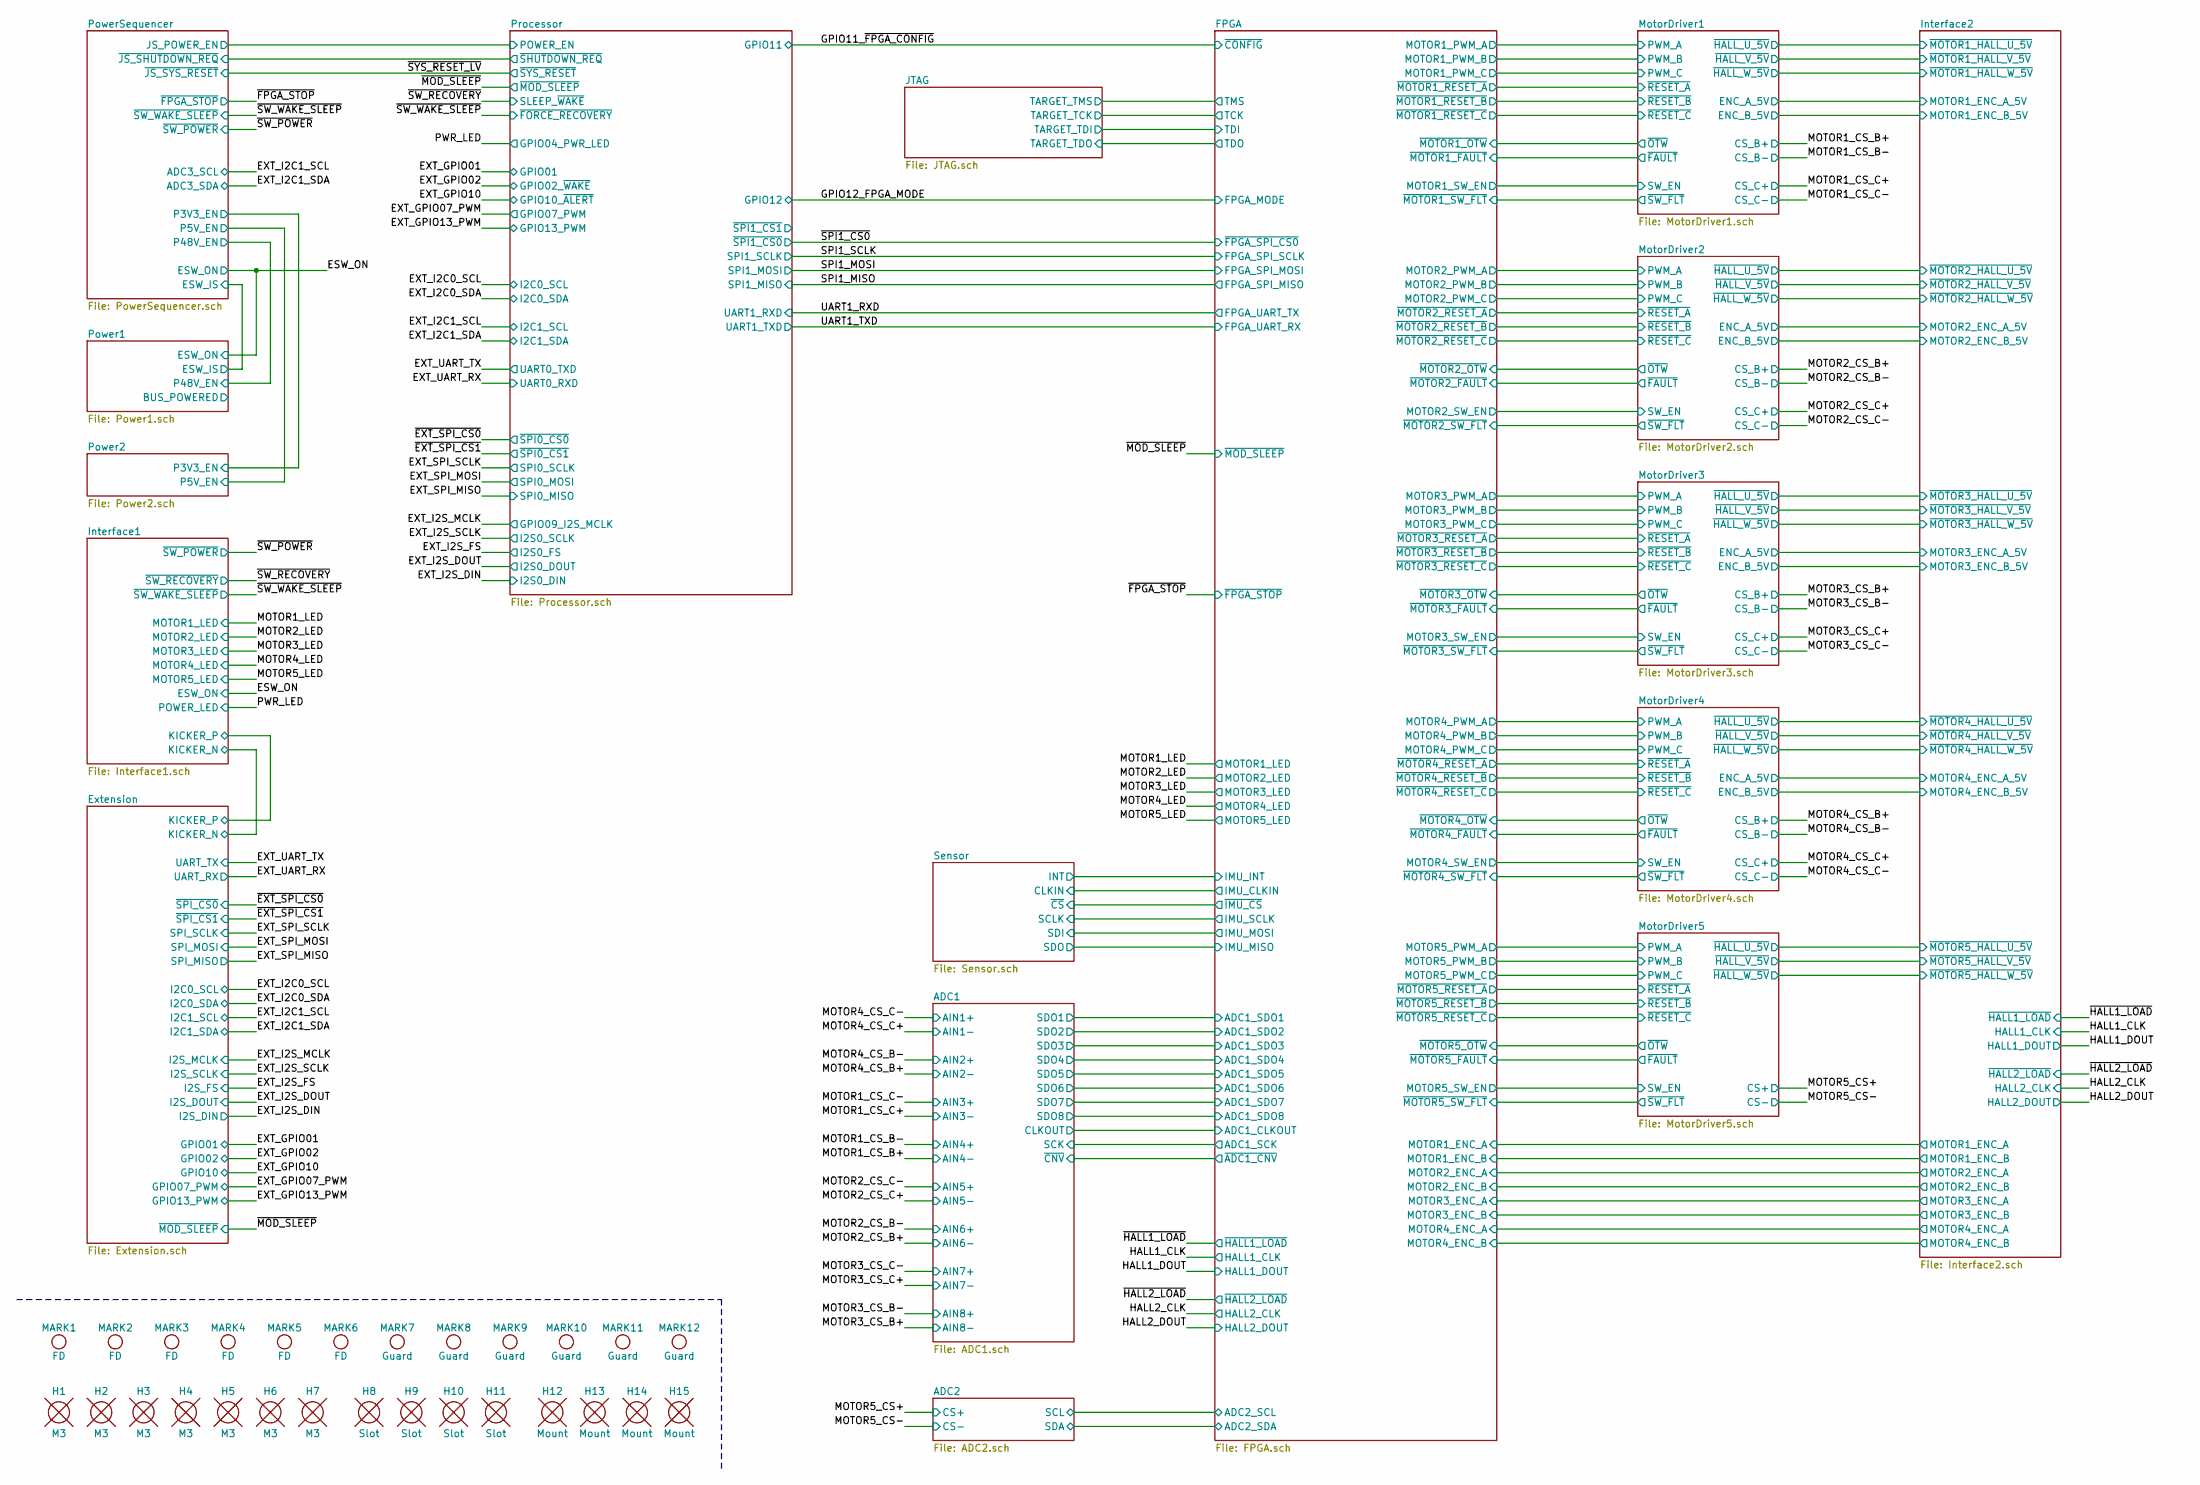
[picture p39: schematic Phoenix.sch]

Parts:
H1, H2, H3, H4, H5, H6, H7: M3; Hole_C3.2
H8, H9, H10, H11: Slot; Hole_C1.0
H12, H13, H14: Mount; Hole_C4.0
H15: Mount; Hole_C5.0x4.0
MARK1, MARK2, MARK3, MARK4, MARK5, MARK6: FD; FD_C3.0_C1.0
MARK7, MARK8, MARK9, MARK10, MARK11, MARK12: Guard; Donuts_C3.9_C3.3
