Nkyoku/phoenix-pcb/Power1.sch

## KiCad design Power1.sch (2020-08-01)

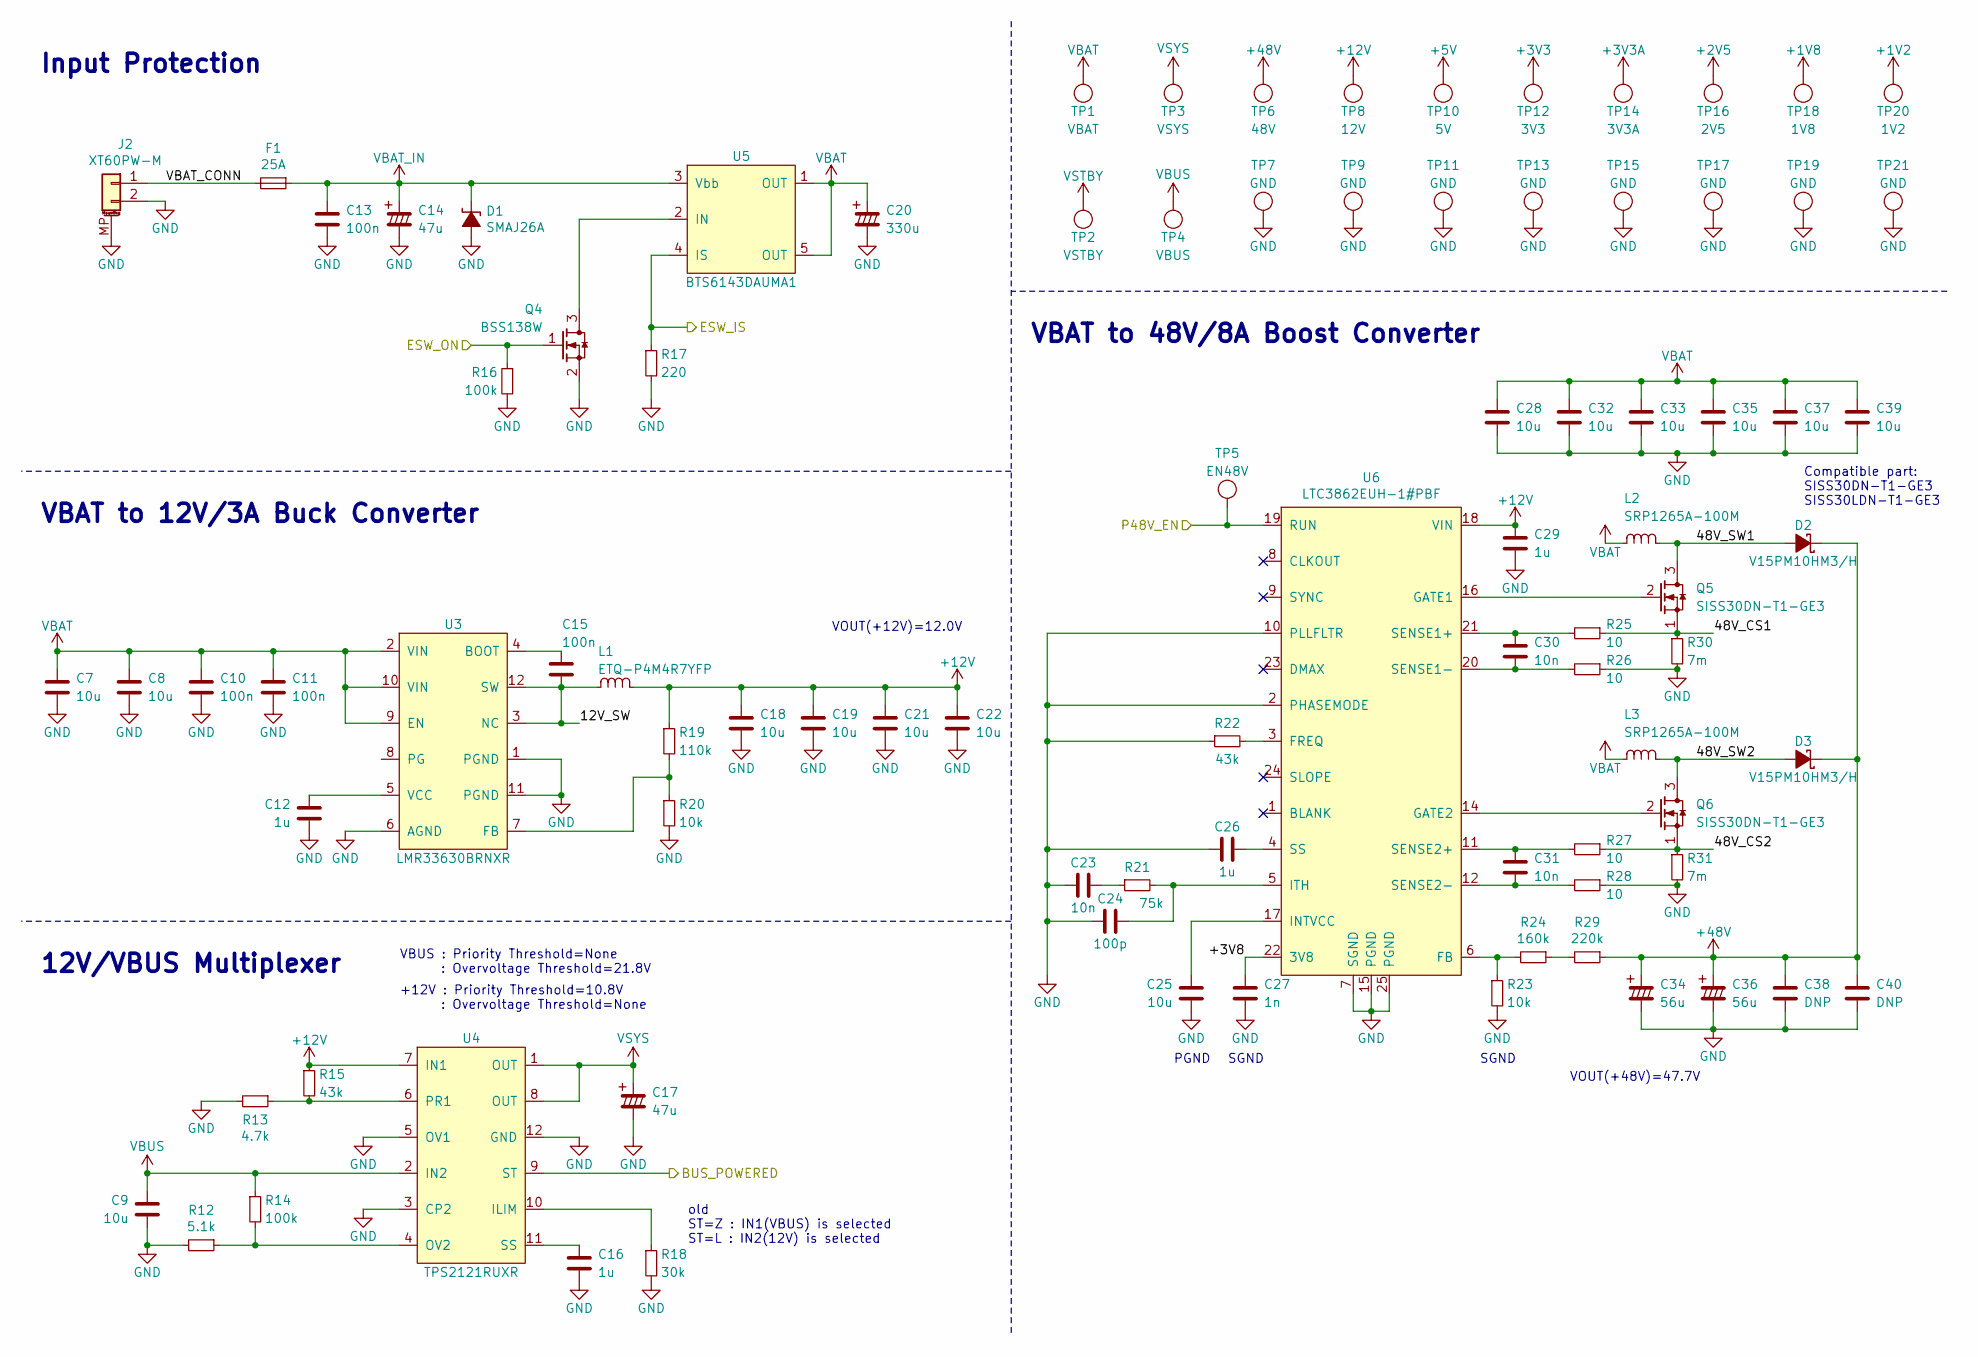
[picture p40: schematic Power1.sch]

Parts:
C7, C8, C9, C18, C19, C21, C22, C25: 10u; C_CHIP_2012_Reflow; PartName GRM21BC8YA106KE11L
C10, C11, C13, C15: 100n; C_CHIP_1005_Hand_NoSilk; PartName GRM155R71H104ME14D
C12, C16, C26, C29: 1u; C_CHIP_1005_Hand_NoSilk; PartName TMK105BJ105MV-F
C14, C17: 47u; C_RADIAL_5.0_P2.0_D0.5; PartName 35PK47MEFC5X11
C20: 330u; C_RADIAL_10.0_P5.0_D0.6; PartName 35ZLH330MEFCT810X12.5
C23, C30, C31: 10n; C_CHIP_1005_Hand_NoSilk; PartName GRM155B11E103K
C24: 100p; C_CHIP_1005_Hand_NoSilk; PartName GRM1552C1H101J
C27: 1n; C_CHIP_1005_Hand_NoSilk; PartName GRM1552C1H102J
C28, C32, C33, C35, C37, C39: 10u; C_CHIP_3225_Reflow; PartName GMK325BJ106KN-T
C34, C36: 56u; C_RADIAL_8.0_P3.5_D0.6; PartName 63SXE56M
C38, C40: DNP; C_CHIP_1608_Reflow; PartName GCJ188R72A104KA01D
D1: SMAJ26A; D_SMA(DO-214AC); PartName SMAJ26A-13-F
D2, D3: V15PM10HM3/H; D_SMPC(TO-277A); PartName V15PM10HM3/H
F1: 25A; R_CHIP_3216_Reflow; PartName 0685H9250-01
J2: XT60PW-M; PartName XT60PW-M
L1: ETQ-P4M4R7YFP; PCC-M0540M; PartName ETQ-P4M4R7YFP
L2, L3: SRP1265A-100M; L_SRP1265A; PartName SRP1265A-100M
Q4: BSS138W; SC70-3; PartName BSS138W-7-F
Q5, Q6: SISS30DN-T1-GE3; PowerPAK1212-8S; PartName SISS30DN-T1-GE3
R12: 5.1k; R_CHIP_1005_Hand_NoSilk; PartName RK73H1ETTP5101F
R13: 4.7k; R_CHIP_1005_Hand_NoSilk; PartName RK73H1ETTP4701F
R14, R16: 100k; R_CHIP_1005_Hand_NoSilk; PartName RK73H1ETTP1003F
R15, R22: 43k; R_CHIP_1005_Hand_NoSilk; PartName RK73H1ETTP4302F
R17: 220; R_CHIP_1005_Hand_NoSilk; PartName RK73H1ETTP2200F
R18: 30k; R_CHIP_1005_Hand_NoSilk; PartName RK73H1ETTP3002F
R19: 110k; R_CHIP_1005_Hand_NoSilk; PartName RK73H1ETTP1103F
R20, R23: 10k; R_CHIP_1005_Hand_NoSilk; PartName RK73H1ETTP1002F
R21: 75k; R_CHIP_1005_Hand_NoSilk; PartName RK73H1ETTP7502F
R24: 160k; R_CHIP_1005_Hand_NoSilk; PartName RK73H1ETTP1603F
R25, R26, R27, R28: 10; R_CHIP_1005_Hand_NoSilk; PartName RK73B1ETTP100J
R29: 220k; R_CHIP_1005_Hand_NoSilk; PartName RK73H1ETTP2203F
R30, R31: 7m; R_KRL6432; PartName KRL6432E-M-R007-F-T1
TP1: VBAT; TP_C0.8
TP2: VSTBY; TP_C0.8
TP3: VSYS; TP_C0.8
TP4: VBUS; TP_C0.8
TP5: EN48V; TP_C0.8
TP6: 48V; TP_C0.8
TP7, TP9, TP11, TP13, TP15, TP17, TP19, TP21: GND; TP_R0.8_0.8
TP8: 12V; TP_C0.8
TP10: 5V; TP_C0.8
TP12: 3V3; TP_C0.8
TP14: 3V3A; TP_C0.8
TP16: 2V5; TP_C0.8
TP18: 1V8; TP_C0.8
TP20: 1V2; TP_C0.8
U3: LMR33630BRNXR; VQFN12-HR_002; PartName LMR33630BRNXR
U4: TPS2121RUXR; VQFN12-HR_001; PartName TPS2121RUXR
U5: BTS6143DAUMA1; PG-TO252-5; PartName BTS6143DAUMA1
U6: LTC3862EUH-1#PBF; QFN24_5.0x5.0_P0.65_EP3.2x3.2; PartName LTC3862EUH-1#PBF

Connections:
12V_SW: C15.2, L1.1, U3.3 (NC), U3.12 (SW)
48V_CS1: Q5.1 (S), R25.1, R30.1
48V_CS2: Q6.1 (S), R27.1, R31.1
48V_SW1: D2.2 (A), L2.1, Q5.3 (D)
48V_SW2: D3.2 (A), L3.1, Q6.3 (D)
+1V2: TP20.1
+1V8: TP18.1
+2V5: TP16.1
+3V3: TP12.1
+3V3A: TP14.1
+3V8: C27.1, U6.22 (3V8)
+5V: TP10.1
+12V: C18.1, C19.1, C21.1, C22.1, C29.1, L1.2, R15.1, R19.1, TP8.1, U4.7 (IN1), U6.18 (VIN)
+48V: C34.1, C36.1, C38.1, C40.1, D2.1 (K), D3.1 (K), R29.1, TP6.1
BUS_POWERED: U4.9 (ST)
ESW_IS: R17.1, U5.4 (IS)
ESW_ON: Q4.1 (G), R16.1
GND: C7.2, C8.2, C9.2, C10.2, C11.2, C12.2, C13.2, C14.2, C16.2, C17.2, C18.2, C19.2, C20.2, C21.2, C22.2, C23.1, C24.1, C25.2, C26.1, C27.2, C28.2, C29.2, C32.2, C33.2, C34.2, C35.2, C36.2, C37.2, C38.2, C39.2, C40.2, D1.2 (A), J2.2, J2.MP (MountPin), Q4.2 (S), R12.2, R13.2, R16.2, R17.2, R18.2, R20.2, R22.1, R23.2, R26.1, R28.1, R30.2, R31.2, TP7.1, TP9.1, TP11.1, TP13.1, TP15.1, TP17.1, TP19.1, TP21.1, U3.1 (PGND), U3.6 (AGND), U3.11 (PGND), U4.3 (CP2), U4.5 (OV1), U4.12 (GND), U6.2 (PHASEMODE), U6.7 (SGND), U6.10 (PLLFLTR), U6.15 (PGND), U6.25 (PGND)
unnamed: C12.1, U3.5 (VCC)
unnamed: C15.1, U3.4 (BOOT)
unnamed: C16.1, U4.11 (SS)
unnamed: C23.2, R21.1
unnamed: C24.2, R21.2, U6.5 (ITH)
unnamed: C25.1, U6.17 (INTVCC)
unnamed: C26.2, U6.4 (SS)
unnamed: C30.1, R25.2, U6.21 (SENSE1+)
unnamed: C30.2, R26.2, U6.20 (SENSE1-)
unnamed: C31.1, R27.2, U6.11 (SENSE2+)
unnamed: C31.2, R28.2, U6.12 (SENSE2-)
unnamed: Q4.3 (D), U5.2 (IN)
unnamed: Q5.2 (G), U6.16 (GATE1)
unnamed: Q6.2 (G), U6.14 (GATE2)
unnamed: R12.1, R14.2, U4.4 (OV2)
unnamed: R13.1, R15.2, U4.6 (PR1)
unnamed: R18.1, U4.10 (ILIM)
unnamed: R19.2, R20.1, U3.7 (FB)
unnamed: R22.2, U6.3 (FREQ)
unnamed: R23.1, R24.2, U6.6 (FB)
unnamed: R24.1, R29.2
P48V_EN: TP5.1, U6.19 (RUN)
VBAT: C7.1, C8.1, C10.1, C11.1, C20.1, C28.1, C32.1, C33.1, C35.1, C37.1, C39.1, L2.2, L3.2, TP1.1, U3.2 (VIN), U3.9 (EN), U3.10 (VIN), U5.1 (OUT), U5.5 (OUT)
VBAT_CONN: F1.2, J2.1
VBAT_IN: C13.1, C14.1, D1.1 (K), F1.1, U5.3 (Vbb)
VBUS: C9.1, R14.1, TP4.1, U4.2 (IN2)
VSTBY: TP2.1
VSYS: C17.1, TP3.1, U4.1 (OUT), U4.8 (OUT)

Notes on the sheet:
VBAT to 12V/3A Buck Converter
SGND
PGND
Input Protection
12V/VBUS Multiplexer
VBUS : Priority Threshold=None : Overvoltage Threshold=21.8V
+12V : Priority Threshold=10.8V : Overvoltage Threshold=None
old ST=Z : IN1(VBUS) is selected ST=L : IN2(12V) is selected
VOUT(+12V)=12.0V
VOUT(+48V)=47.7V
Compatible part: SISS30DN-T1-GE3 SISS30LDN-T1-GE3
VBAT to 48V/8A Boost Converter
