Nkyoku/phoenix-pcb/Power2.sch

## KiCad design Power2.sch (2020-08-01)

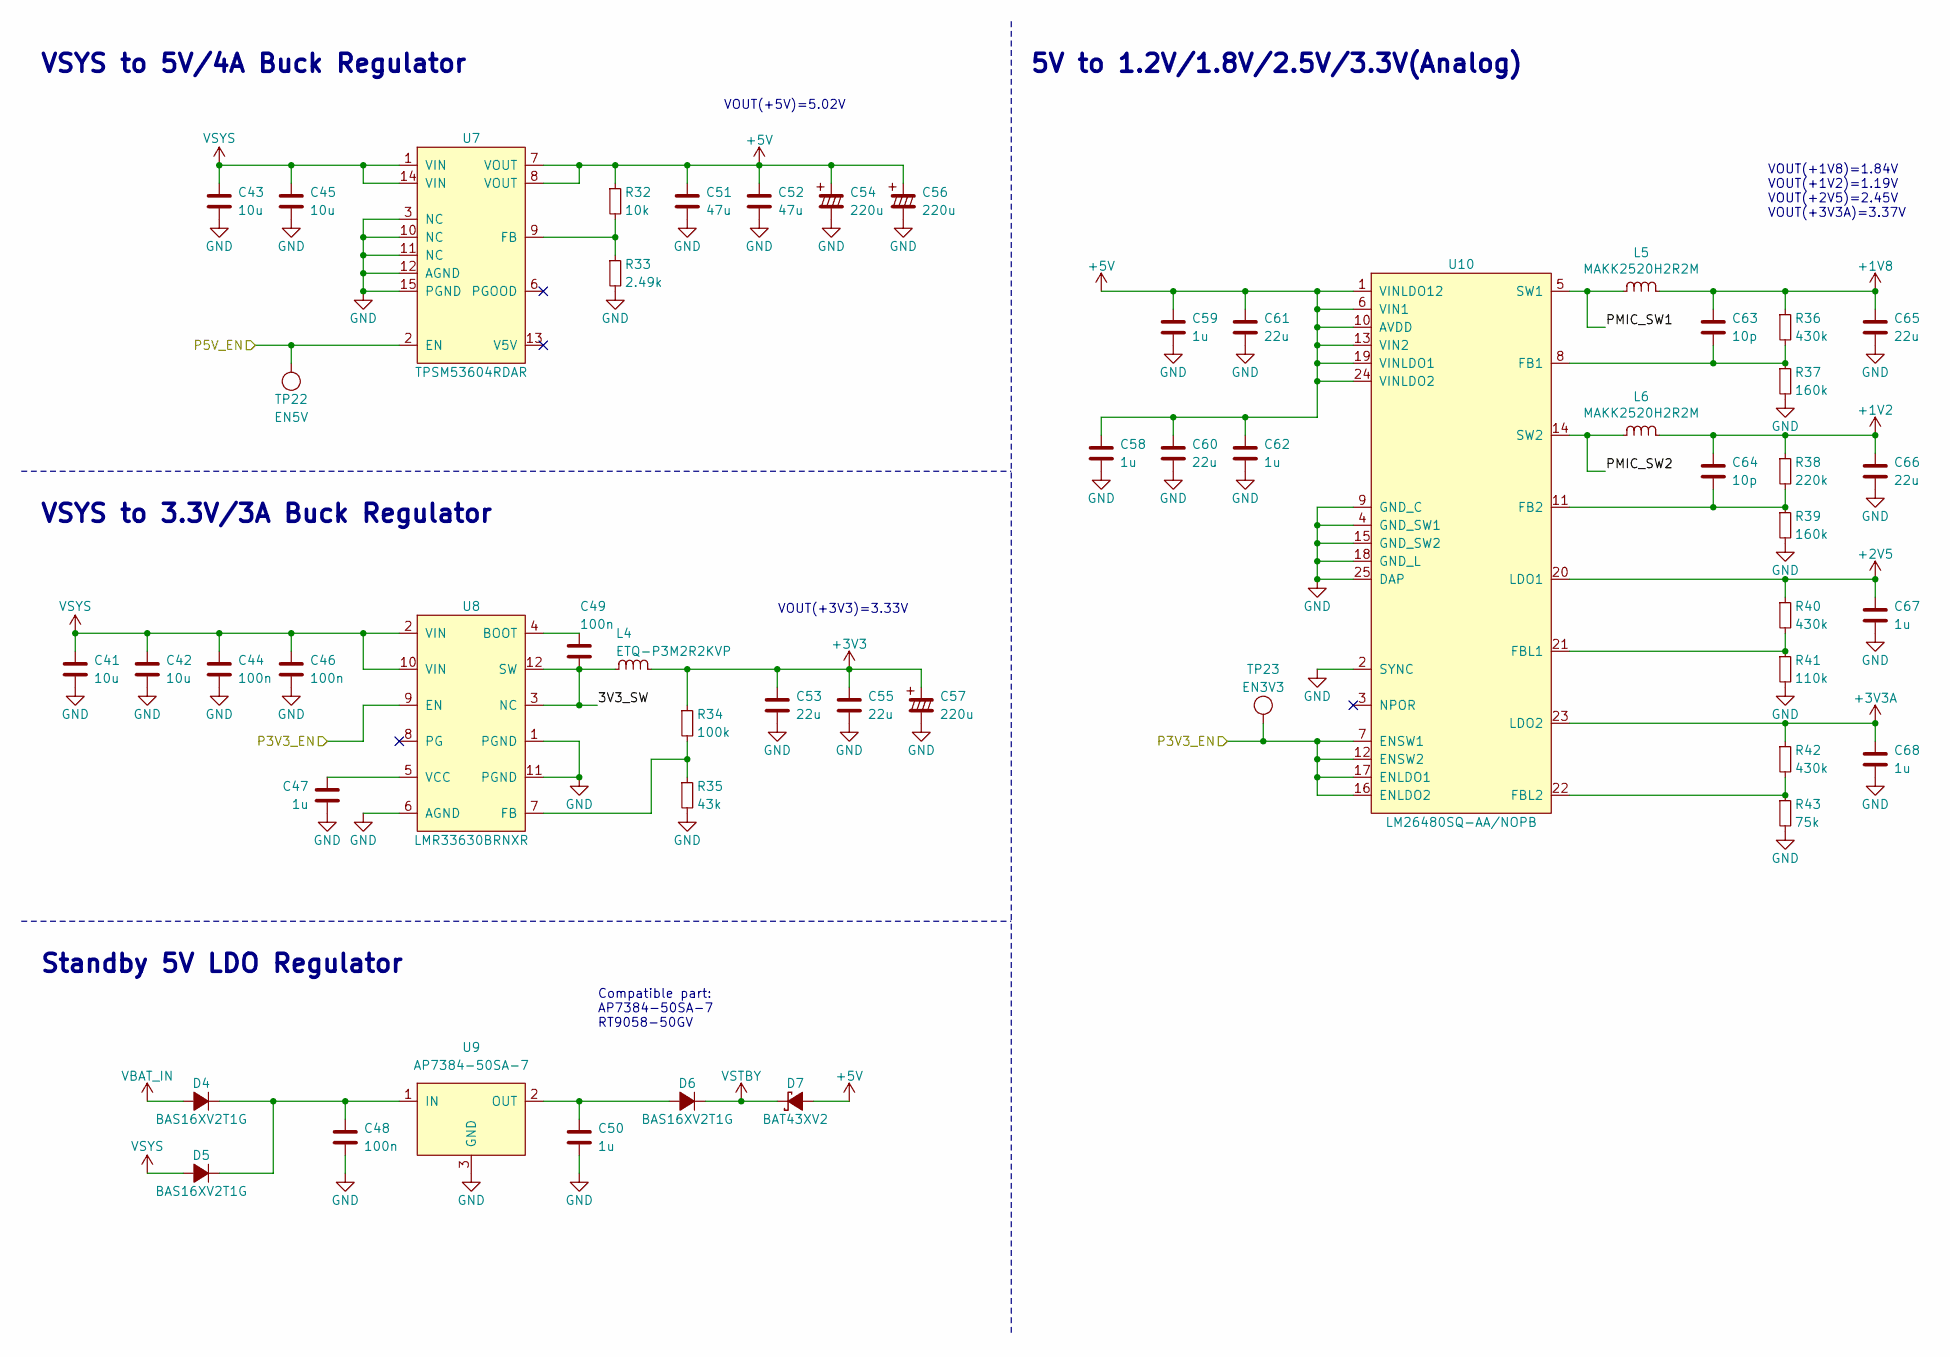
[picture p41: schematic Power2.sch]

Parts:
C41, C42, C43, C45: 10u; C_CHIP_2012_Reflow; PartName GRM21BC8YA106KE11L
C44, C46, C48, C49: 100n; C_CHIP_1005_Hand_NoSilk; PartName GRM155R71H104ME14D
C47, C50, C58, C59, C62, C67, C68: 1u; C_CHIP_1005_Hand_NoSilk; PartName TMK105BJ105MV-F
C51, C52: 47u; C_CHIP_2012_Reflow; PartName JMK212BJ476MG-T
C53, C55, C60, C61, C65, C66: 22u; C_CHIP_2012_Reflow; PartName GRM21BR61E226ME44L
C54, C56, C57: 220u; C_RADIAL_5.0_P2.0_D0.5; PartName 6.3ZLH220MEFC5X11
C63, C64: 10p; C_CHIP_1005_Hand_NoSilk; PartName GRM1552C1H100J
D4, D5, D6: BAS16XV2T1G; D_SOD-523_Hand_NoSilk; PartName BAS16XV2T1G
D7: BAT43XV2; D_SOD-523_Hand_NoSilk; PartName BAT43XV2
L4: ETQ-P3M2R2KVP; PCC-M0530M-LP; PartName ETQ-P3M2R2KVP
L5, L6: MAKK2520H2R2M; L_MAxx2520; PartName MAKK2520H2R2M
R32: 10k; R_CHIP_1005_Hand_NoSilk; PartName RK73H1ETTP1002F
R33: 2.49k; R_CHIP_1005_Hand_NoSilk; PartName RK73H1ETTP2491F
R34: 100k; R_CHIP_1005_Hand_NoSilk; PartName RK73H1ETTP1003F
R35: 43k; R_CHIP_1005_Hand_NoSilk; PartName RK73H1ETTP4302F
R36, R40, R42: 430k; R_CHIP_1005_Hand_NoSilk; PartName RK73H1ETTP4303F
R37, R39: 160k; R_CHIP_1005_Hand_NoSilk; PartName RK73H1ETTP1603F
R38: 220k; R_CHIP_1005_Hand_NoSilk; PartName RK73H1ETTP2203F
R41: 110k; R_CHIP_1005_Hand_NoSilk; PartName RK73H1ETTP1103F
R43: 75k; R_CHIP_1005_Hand_NoSilk; PartName RK73H1ETTP7502F
TP22: EN5V; TP_C0.8
TP23: EN3V3; TP_C0.8
U7: TPSM53604RDAR; B3QFN; PartName TPSM53604RDAR
U8: LMR33630BRNXR; VQFN12-HR_002; PartName LMR33630BRNXR
U9: AP7384-50SA-7; SOT23-3; PartName AP7384-50SA-7
U10: LM26480SQ-AA/NOPB; QFN24_4.0x4.0_P0.5_EP2.5x2.5; PartName LM26480SQ-AA/NOPB

Connections:
3V3_SW: C49.2, L4.1, U8.3 (NC), U8.12 (SW)
+1V2: C64.1, C66.1, L6.2, R38.1
+1V8: C63.1, C65.1, L5.2, R36.1
+2V5: C67.1, R40.1, U10.20 (LDO1)
+3V3: C53.1, C55.1, C57.1, L4.2, R34.1
+3V3A: C68.1, R42.1, U10.23 (LDO2)
+5V: C51.1, C52.1, C54.1, C56.1, C58.1, C59.1, C60.1, C61.1, C62.1, D7.2 (A), R32.1, U7.7 (VOUT), U7.8 (VOUT), U10.1 (VINLDO12), U10.6 (VIN1), U10.10 (AVDD), U10.13 (VIN2), U10.19 (VINLDO1), U10.24 (VINLDO2)
GND: C41.2, C42.2, C43.2, C44.2, C45.2, C46.2, C47.2, C48.2, C50.2, C51.2, C52.2, C53.2, C54.2, C55.2, C56.2, C57.2, C58.2, C59.2, C60.2, C61.2, C62.2, C65.2, C66.2, C67.2, C68.2, R33.2, R35.2, R37.2, R39.2, R41.2, R43.2, U7.3 (NC), U7.10 (NC), U7.11 (NC), U7.12 (AGND), U7.15 (PGND), U8.1 (PGND), U8.6 (AGND), U8.11 (PGND), U9.3 (GND), U10.2 (SYNC), U10.4 (GND_SW1), U10.9 (GND_C), U10.15 (GND_SW2), U10.18 (GND_L), U10.25 (DAP)
unnamed: C47.1, U8.5 (VCC)
unnamed: C48.1, D4.1 (K), D5.1 (K), U9.1 (IN)
unnamed: C49.1, U8.4 (BOOT)
unnamed: C50.1, D6.2 (A), U9.2 (OUT)
unnamed: C63.2, R36.2, R37.1, U10.8 (FB1)
unnamed: C64.2, R38.2, R39.1, U10.11 (FB2)
unnamed: R32.2, R33.1, U7.9 (FB)
unnamed: R34.2, R35.1, U8.7 (FB)
unnamed: R40.2, R41.1, U10.21 (FBL1)
unnamed: R42.2, R43.1, U10.22 (FBL2)
P3V3_EN: TP23.1, U8.9 (EN), U10.7 (ENSW1), U10.12 (ENSW2), U10.16 (ENLDO2), U10.17 (ENLDO1)
P5V_EN: TP22.1, U7.2 (EN)
PMIC_SW1: L5.1, U10.5 (SW1)
PMIC_SW2: L6.1, U10.14 (SW2)
VBAT_IN: D4.2 (A)
VSTBY: D6.1 (K), D7.1 (K)
VSYS: C41.1, C42.1, C43.1, C44.1, C45.1, C46.1, D5.2 (A), U7.1 (VIN), U7.14 (VIN), U8.2 (VIN), U8.10 (VIN)

Notes on the sheet:
VSYS to 5V/4A Buck Regulator
VSYS to 3.3V/3A Buck Regulator
5V to 1.2V/1.8V/2.5V/3.3V(Analog)
Standby 5V LDO Regulator
Compatible part: AP7384-50SA-7 RT9058-50GV
VOUT(+3V3)=3.33V
VOUT(+1V8)=1.84V VOUT(+1V2)=1.19V VOUT(+2V5)=2.45V VOUT(+3V3A)=3.37V
VOUT(+5V)=5.02V
