Nkyoku/phoenix-pcb/PowerSequencer.sch

## KiCad design PowerSequencer.sch (2020-07-20)

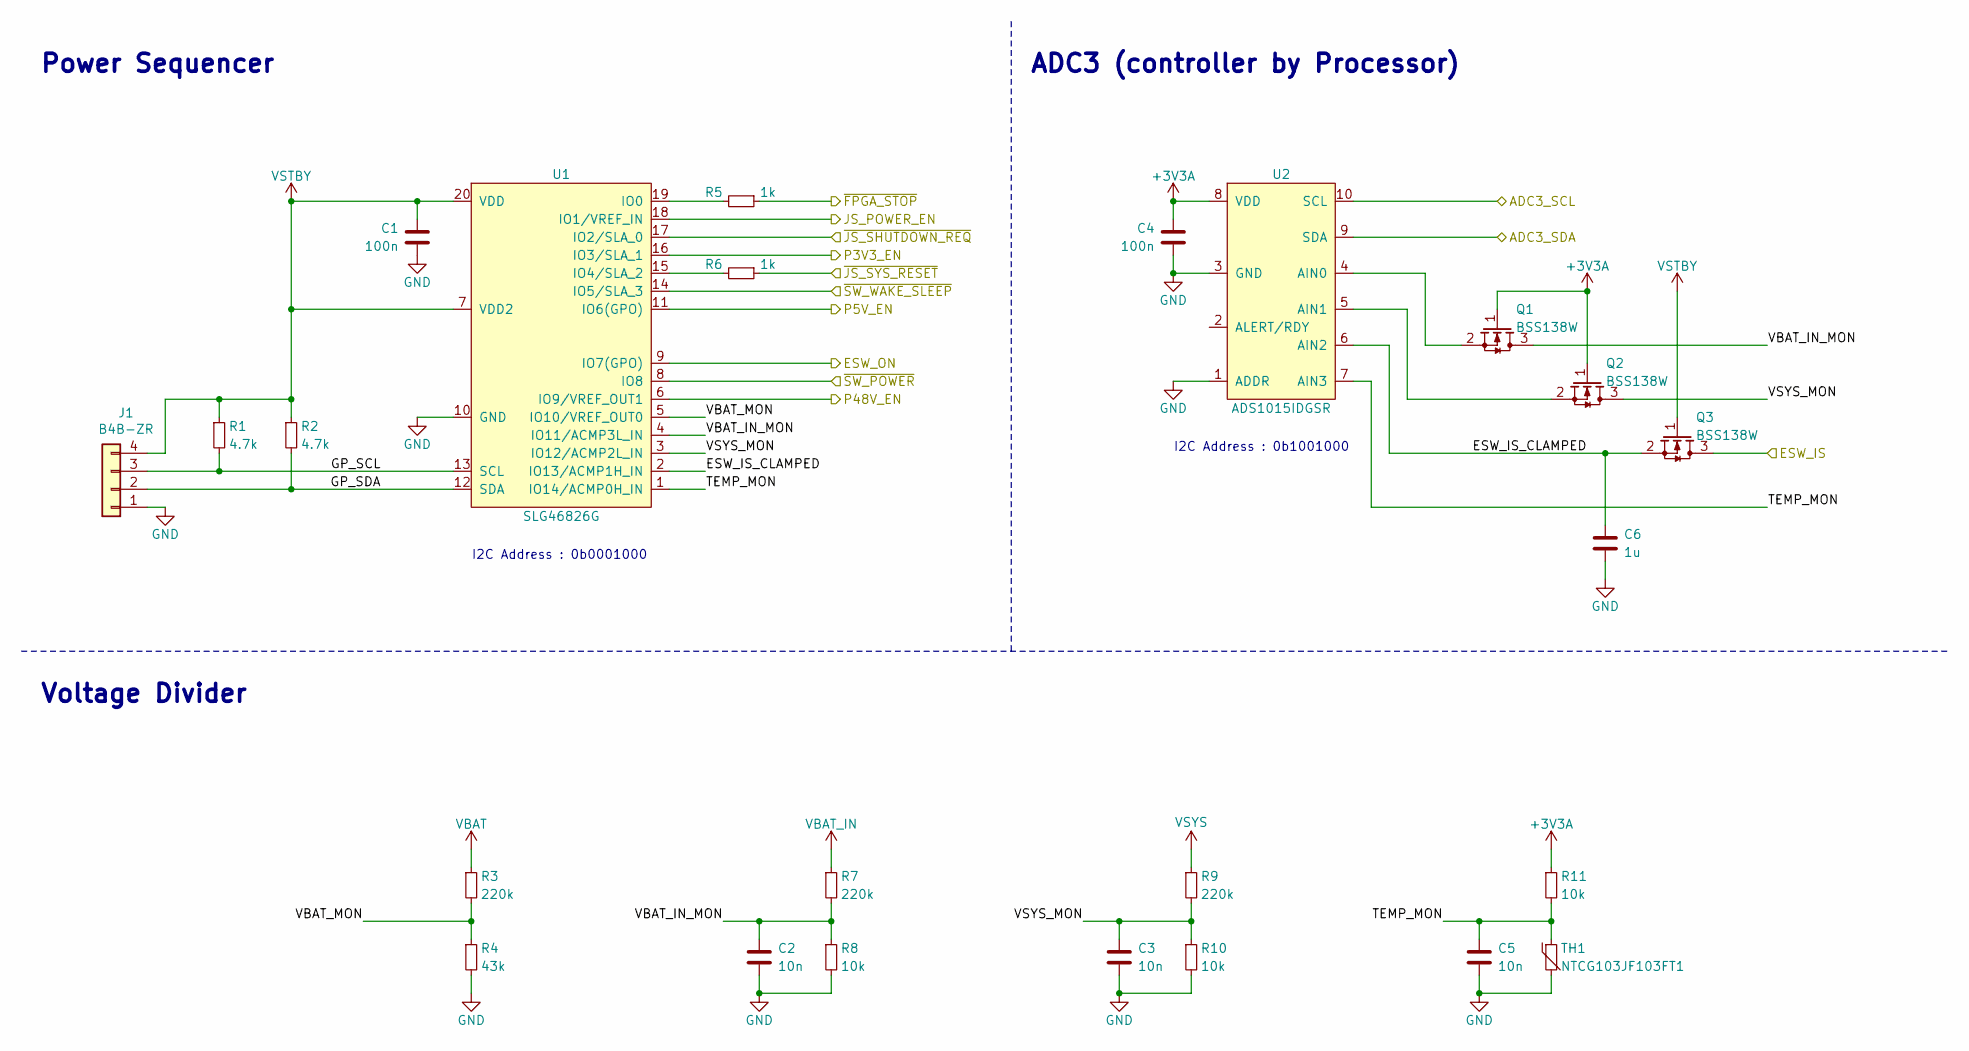
[picture p42: schematic PowerSequencer.sch]

Parts:
C1, C4: 100n; C_CHIP_1005_Hand_NoSilk; PartName GRM155R71H104ME14D
C2, C3, C5: 10n; C_CHIP_1005_Hand_NoSilk; PartName GRM155B11E103K
C6: 1u; C_CHIP_1005_Hand_NoSilk; PartName TMK105BJ105MV-F
J1: B4B-ZR; PartName B4B-ZR
Q1, Q2, Q3: BSS138W; SC70-3; PartName BSS138W-7-F
R1, R2: 4.7k; R_CHIP_1005_Hand_NoSilk; PartName RK73H1ETTP4701F
R3, R7, R9: 220k; R_CHIP_1005_Hand_NoSilk; PartName RK73H1ETTP2203F
R4: 43k; R_CHIP_1005_Hand_NoSilk; PartName RK73H1ETTP4302F
R5, R6: 1k; R_CHIP_1005_Hand_NoSilk; PartName RK73B1ETTP102J
R8, R10, R11: 10k; R_CHIP_1005_Hand_NoSilk; PartName RK73H1ETTP1002F
TH1: NTCG103JF103FT1; R_CHIP_1005_Hand_NoSilk; PartName NTCG103JF103FT1
U1: SLG46826G; TSSOP20-W4.4; PartName SLG46826G
U2: ADS1015IDGSR; VSSOP10_3.0x3.0_P0.5; PartName ADS1015IDGSR

Connections:
+3V3A: C4.1, Q1.1 (G), Q2.1 (G), R11.1, U2.8 (VDD)
ADC3_SCL: U2.10 (SCL)
ADC3_SDA: U2.9 (SDA)
ESW_IS: Q3.3 (D)
ESW_IS_CLAMPED: C6.1, Q3.2 (S), U1.2 (IO13/ACMP1H_IN), U2.6 (AIN2)
ESW_ON: U1.9 (IO7(GPO))
GND: C1.2, C2.2, C3.2, C4.2, C5.2, C6.2, J1.1, R4.2, R8.2, R10.2, TH1.2, U1.10 (GND), U2.1 (ADDR), U2.3 (GND)
GP_SCL: J1.3, R1.2, U1.13 (SCL)
GP_SDA: J1.2, R2.2, U1.12 (SDA)
JS_POWER_EN: U1.18 (IO1/VREF_IN)
unnamed: Q1.2 (S), U2.4 (AIN0)
unnamed: Q2.2 (S), U2.5 (AIN1)
unnamed: R5.2, U1.19 (IO0)
unnamed: R6.2, U1.15 (IO4/SLA_2)
P3V3_EN: U1.16 (IO3/SLA_1)
P5V_EN: U1.11 (IO6(GPO))
P48V_EN: U1.6 (IO9/VREF_OUT1)
TEMP_MON: C5.1, R11.2, TH1.1, U1.1 (IO14/ACMP0H_IN), U2.7 (AIN3)
VBAT: R3.1
VBAT_IN: R7.1
VBAT_IN_MON: C2.1, Q1.3 (D), R7.2, R8.1, U1.4 (IO11/ACMP3L_IN)
VBAT_MON: R3.2, R4.1, U1.5 (IO10/VREF_OUT0)
VSTBY: C1.1, J1.4, Q3.1 (G), R1.1, R2.1, U1.7 (VDD2), U1.20 (VDD)
VSYS: R9.1
VSYS_MON: C3.1, Q2.3 (D), R9.2, R10.1, U1.3 (IO12/ACMP2L_IN)
~FPGA_STOP: R5.1
~JS_SHUTDOWN_REQ: U1.17 (IO2/SLA_0)
~JS_SYS_RESET: R6.1
~SW_POWER: U1.8 (IO8)
~SW_WAKE_SLEEP: U1.14 (IO5/SLA_3)

Notes on the sheet:
Power Sequencer
Voltage Divider
I2C Address : 0b1001000
ADC3 (controller by Processor)
I2C Address : 0b0001000
