Nkyoku/phoenix-pcb/Processor-Camera.sch

## KiCad design Processor-Camera.sch (2020-08-01)

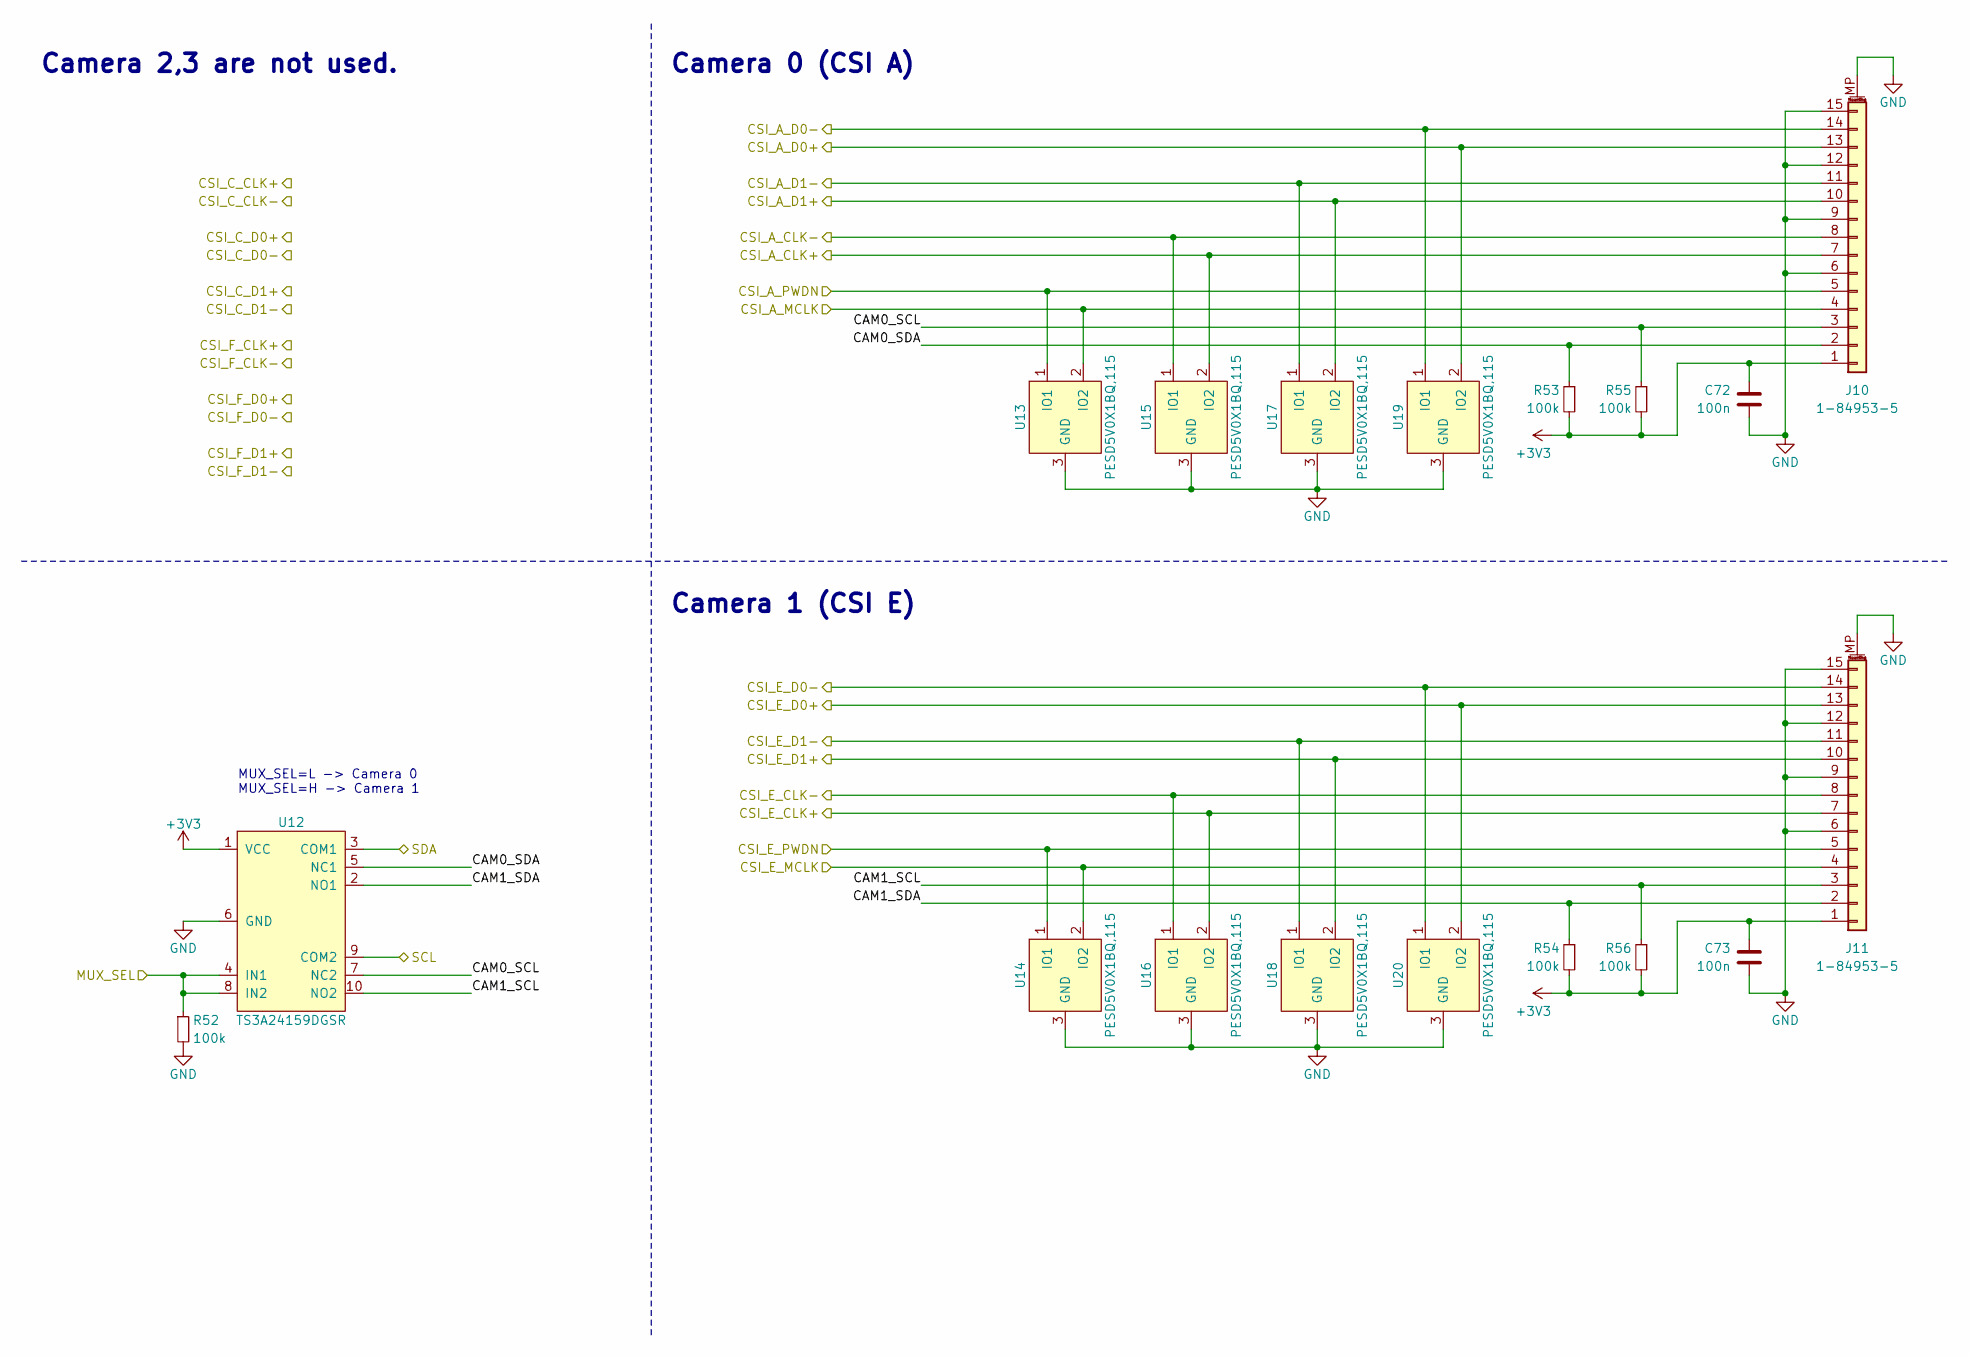
[picture p43: schematic Processor-Camera.sch]

Parts:
C72, C73: 100n; C_CHIP_1005_Hand_NoSilk; PartName GRM155R71H104ME14D
J10, J11: 1-84953-5; PartName 1-84953-5
R52, R53, R54, R55, R56: 100k; R_CHIP_1005_Hand_NoSilk; PartName RK73H1ETTP1003F
U12: TS3A24159DGSR; VSSOP10_3.0x3.0_P0.5; PartName TS3A24159DGSR
U13, U14, U15, U16, U17, U18, U19, U20: PESD5V0X1BQ,115; SOT663; PartName PESD5V0X1BQ,115

Connections:
+3V3: C72.1, C73.1, J10.1, J11.1, R53.2, R54.2, R55.2, R56.2, U12.1 (VCC)
CAM0_SCL: J10.3, R55.1, U12.7 (NC2)
CAM0_SDA: J10.2, R53.1, U12.5 (NC1)
CAM1_SCL: J11.3, R56.1, U12.10 (NO2)
CAM1_SDA: J11.2, R54.1, U12.2 (NO1)
CSI_A_CLK+: J10.7, U15.2 (IO2)
CSI_A_CLK-: J10.8, U15.1 (IO1)
CSI_A_D0+: J10.13, U19.2 (IO2)
CSI_A_D0-: J10.14, U19.1 (IO1)
CSI_A_D1+: J10.10, U17.2 (IO2)
CSI_A_D1-: J10.11, U17.1 (IO1)
CSI_A_MCLK: J10.4, U13.2 (IO2)
CSI_A_PWDN: J10.5, U13.1 (IO1)
CSI_E_CLK+: J11.7, U16.2 (IO2)
CSI_E_CLK-: J11.8, U16.1 (IO1)
CSI_E_D0+: J11.13, U20.2 (IO2)
CSI_E_D0-: J11.14, U20.1 (IO1)
CSI_E_D1+: J11.10, U18.2 (IO2)
CSI_E_D1-: J11.11, U18.1 (IO1)
CSI_E_MCLK: J11.4, U14.2 (IO2)
CSI_E_PWDN: J11.5, U14.1 (IO1)
GND: C72.2, C73.2, J10.6, J10.9, J10.12, J10.15, J10.MP (MountPin), J11.6, J11.9, J11.12, J11.15, J11.MP (MountPin), R52.2, U12.6 (GND), U13.3 (GND), U14.3 (GND), U15.3 (GND), U16.3 (GND), U17.3 (GND), U18.3 (GND), U19.3 (GND), U20.3 (GND)
MUX_SEL: R52.1, U12.4 (IN1), U12.8 (IN2)
SCL: U12.9 (COM2)
SDA: U12.3 (COM1)

Notes on the sheet:
MUX_SEL=L -> Camera 0 MUX_SEL=H -> Camera 1
Camera 1 (CSI E)
Camera 0 (CSI A)
Camera 2,3 are not used.
