Nkyoku/phoenix-pcb/Processor-M2.sch

## KiCad design Processor-M2.sch (2020-08-01)

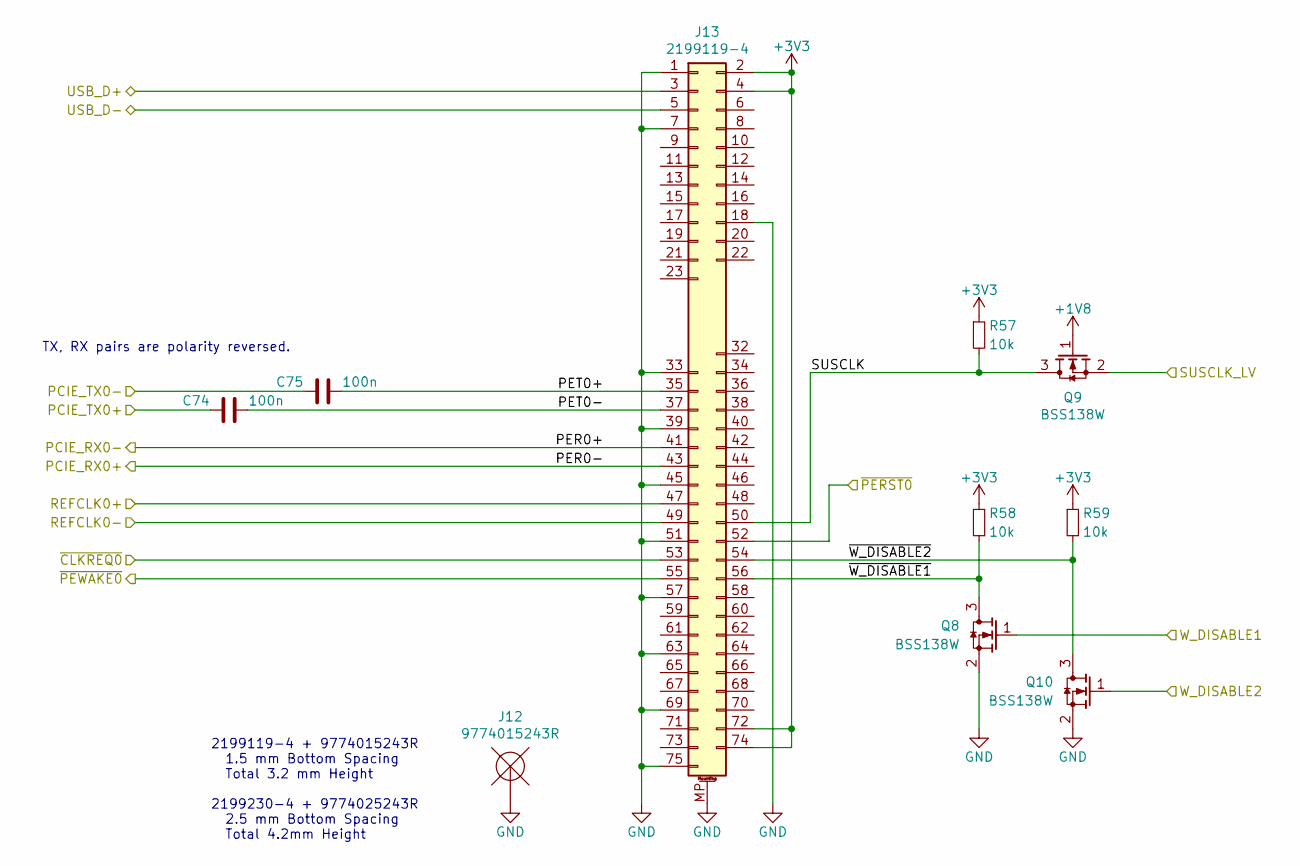
[picture p44: schematic Processor-M2.sch]

Parts:
C74, C75: 100n; C_CHIP_1005_Hand_NoSilk; PartName GRM155R71H104ME14D
J12: 9774015243R; PartName 9774015243R
J13: 2199119-4; 2199119-x_E; PartName 2199119-4
Q8, Q9, Q10: BSS138W; SC70-3; PartName BSS138W-7-F
R57, R58, R59: 10k; R_CHIP_1005_Hand_NoSilk; PartName RK73H1ETTP1002F

Connections:
+1V8: Q9.1 (G)
+3V3: J13.2, J13.4, J13.72, J13.74, R57.1, R58.1, R59.1
GND: J12.1, J13.1, J13.7, J13.18, J13.33, J13.39, J13.45, J13.51, J13.57, J13.63, J13.69, J13.75, J13.MP (MountPin), Q8.2 (S), Q10.2 (S)
PCIE_RX0+: J13.43
PCIE_RX0-: J13.41
PCIE_TX0+: C74.2
PCIE_TX0-: C75.2
PET0+: C75.1, J13.35
PET0-: C74.1, J13.37
REFCLK0+: J13.47
REFCLK0-: J13.49
SUSCLK: J13.50, Q9.3 (D), R57.2
SUSCLK_LV: Q9.2 (S)
USB_D+: J13.3
USB_D-: J13.5
W_DISABLE1: Q8.1 (G)
W_DISABLE2: Q10.1 (G)
~CLKREQ0: J13.53
~PERST0: J13.52
~PEWAKE0: J13.55
~W_DISABLE1: J13.56, Q8.3 (D), R58.2
~W_DISABLE2: J13.54, Q10.3 (D), R59.2

Notes on the sheet:
2199119-4 + 9774015243R 1.5 mm Bottom Spacing Total 3.2 mm Height 2199230-4 + 9774025243R 2.5 mm Bottom Spacing Total 4.2mm Height
TX, RX pairs are polarity reversed.
