Nkyoku/phoenix-pcb/Processor-USBC1.sch

## KiCad design Processor-USBC1.sch (2020-08-01)

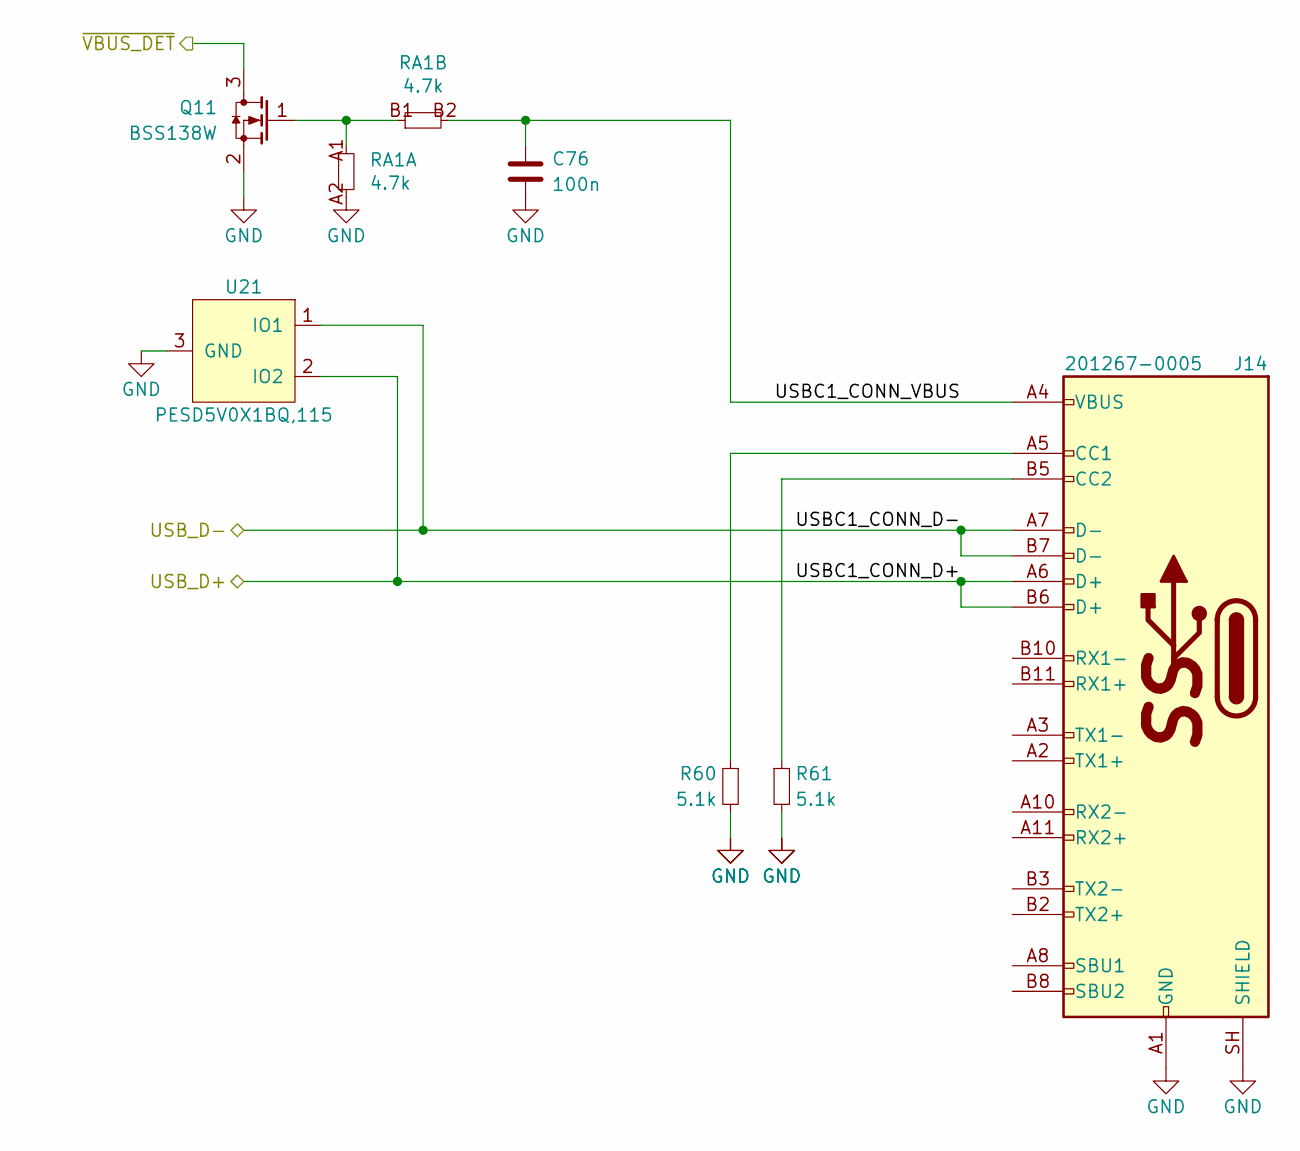
[picture p45: schematic Processor-USBC1.sch]

Parts:
C76: 100n; C_CHIP_1005_Hand_NoSilk; PartName GRM155R71H104ME14D
J14: 201267-0005; 2012670005; PartName 201267-0005
Q11: BSS138W; SC70-3; PartName BSS138W-7-F
R60, R61: 5.1k; R_CHIP_1005_Hand_NoSilk; PartName RK73H1ETTP5101F
RA1: 4.7k; R_CHIP_4x1005_CONCAVE; PartName EXB-N8V472JX
U21: PESD5V0X1BQ,115; SOT663; PartName PESD5V0X1BQ,115

Connections:
GND: C76.2, J14.A1 (GND), J14.A12 (GND), J14.B1 (GND), J14.B12 (GND), J14.SH (SHIELD), Q11.2 (S), R60.2, R61.2, RA1.A2, U21.3 (GND)
unnamed: J14.A5 (CC1), R60.1
unnamed: J14.B5 (CC2), R61.1
unnamed: Q11.1 (G), RA1.A1, RA1.B1
USBC1_CONN_VBUS: C76.1, J14.A4 (VBUS), J14.A9 (VBUS), J14.B4 (VBUS), J14.B9 (VBUS), RA1.B2
USB_D+: J14.A6 (D+), J14.B6 (D+), U21.2 (IO2)
USB_D-: J14.A7 (D-), J14.B7 (D-), U21.1 (IO1)
~VBUS_DET: Q11.3 (D)
