Nkyoku/phoenix-pcb/Processor-USBC2.sch

## KiCad design Processor-USBC2.sch (2020-08-01)

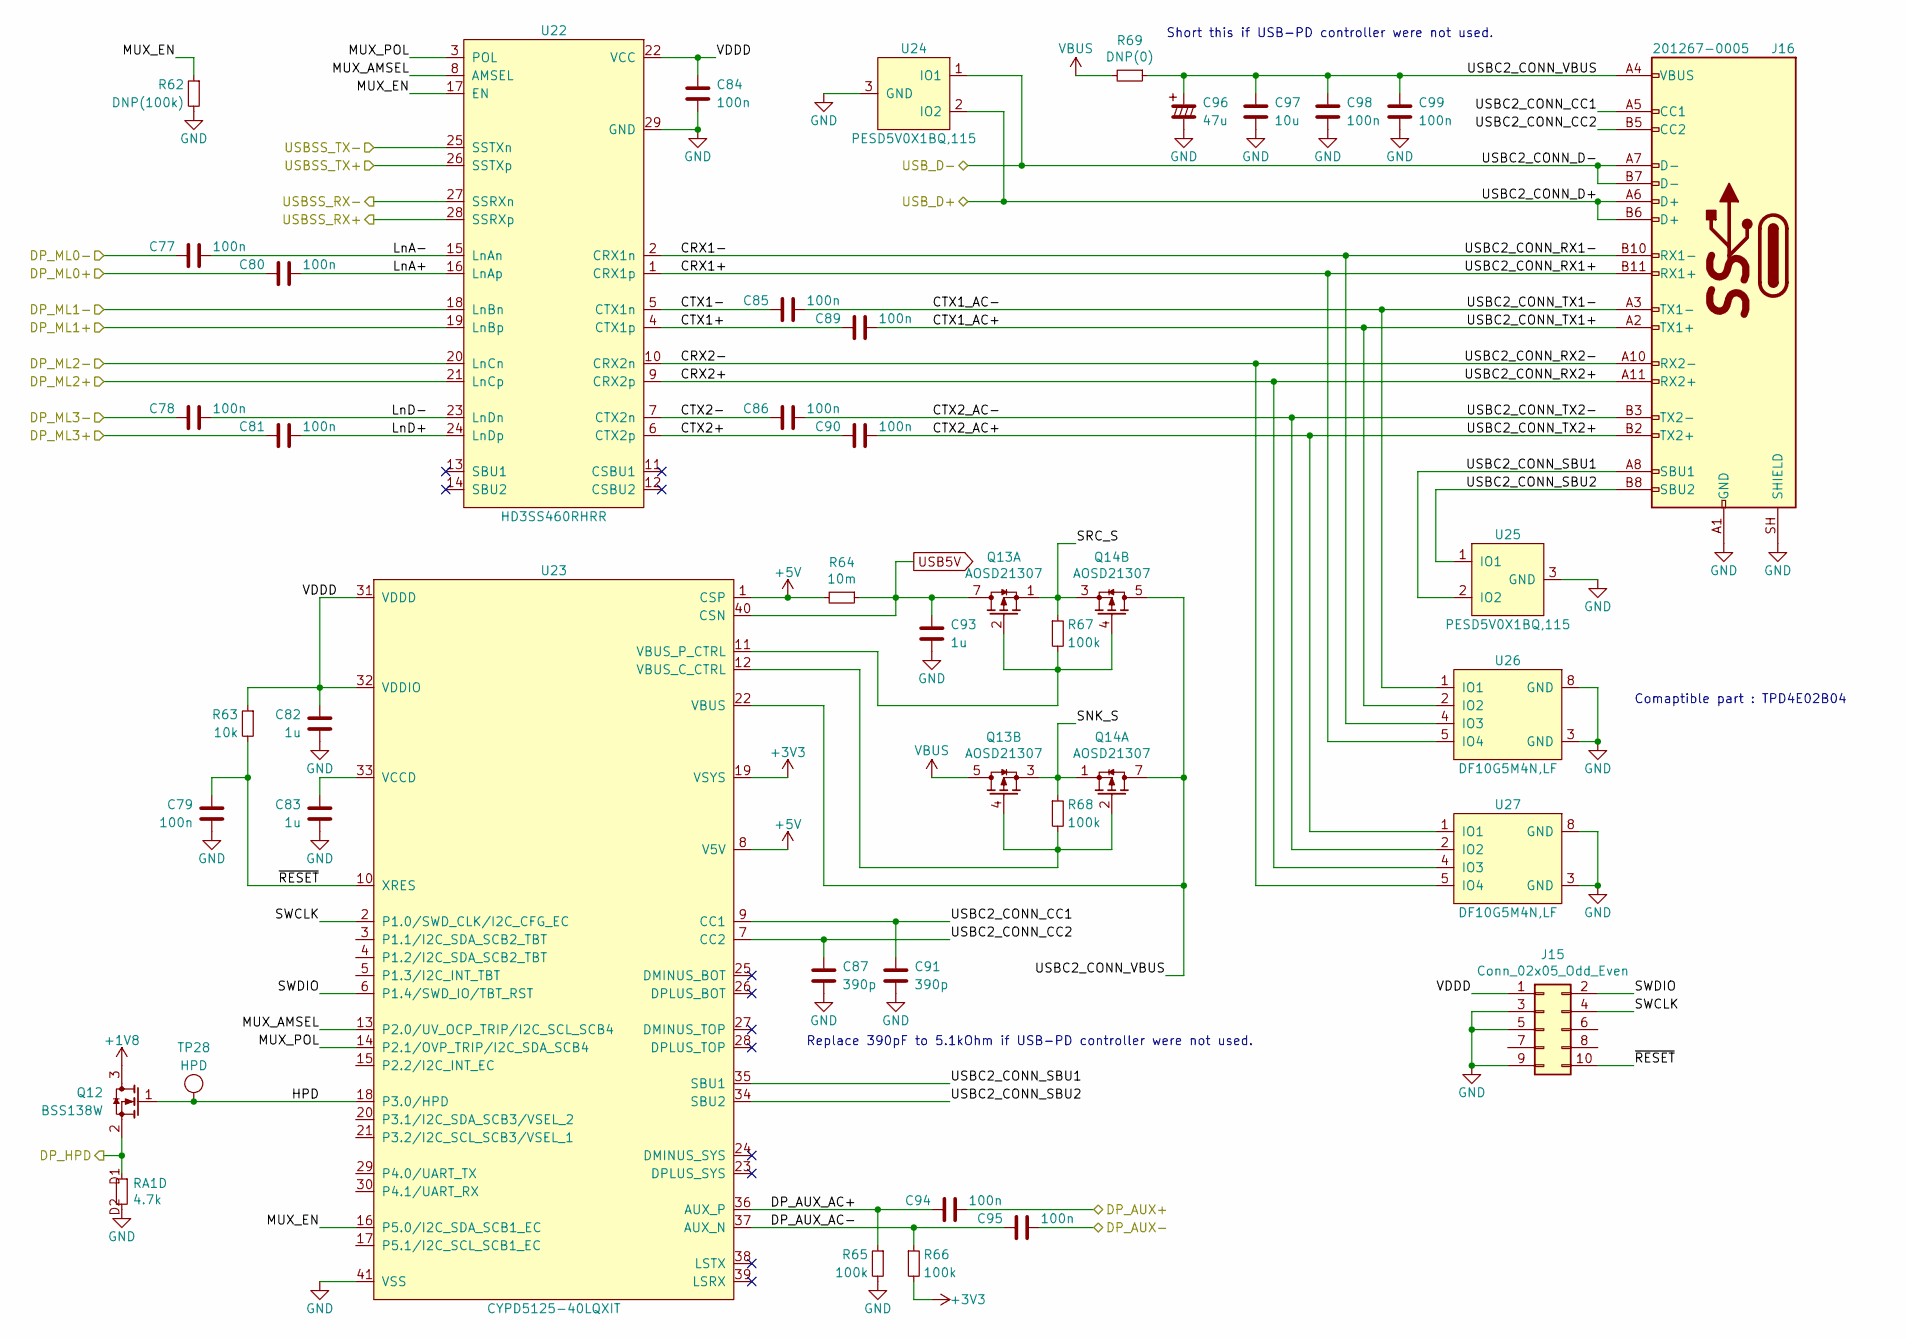
[picture p46: schematic Processor-USBC2.sch]

Parts:
C77, C78, C79, C80, C81, C84, C85, C86, C89, C90, C94, C95, C98, C99: 100n; C_CHIP_1005_Hand_NoSilk; PartName GRM155R71H104ME14D
C82, C83, C93: 1u; C_CHIP_1005_Hand_NoSilk; PartName TMK105BJ105MV-F
C87, C91: 390p; C_CHIP_1005_Hand_NoSilk; PartName GRM155B11H391K
C96: 47u; C_RADIAL_5.0_P2.0_D0.5; PartName 35PK47MEFC5X11
C97: 10u; C_CHIP_3225_Reflow; PartName GMK325BJ106KN-T
J15: Conn_02x05_Odd_Even; PinHeader_2x05_P1.27mm_Vertical; PartName PH11-2x5SAG
J16: 201267-0005; 2012670005; PartName 201267-0005
Q12: BSS138W; SC70-3; PartName BSS138W-7-F
Q13, Q14: AOSD21307; SOP8-W3.9; PartName AOSD21307
R62: DNP(100k); R_CHIP_1005_Hand_NoSilk; PartName RK73H1ETTP1003F
R63: 10k; R_CHIP_1005_Hand_NoSilk; PartName RK73H1ETTP1002F
R64: 10m; R_CHIP_3216_Reflow; PartName ERJ-8CWJR010V
R65, R66, R67, R68: 100k; R_CHIP_1005_Hand_NoSilk; PartName RK73H1ETTP1003F
R69: DNP(0); R_CHIP_1005_Hand_NoSilk; PartName RK73Z1ETTP
RA1: 4.7k; R_CHIP_4x1005_CONCAVE; PartName EXB-N8V472JX
TP28: HPD; TP_C0.8
U22: HD3SS460RHRR; QFN28_3.5x5.5_P0.5_EP2.0x4.0; PartName HD3SS460RHRR
U23: CYPD5125-40LQXIT; QFN40_6.0x6.0_P0.5_EP4.6x4.6; PartName CYPD5125-40LQXIT
U24, U25: PESD5V0X1BQ,115; SOT663; PartName PESD5V0X1BQ,115
U26, U27: DF10G5M4N,LF; USON10_2.5x1.0_P0.5; PartName DF10G5M4N,LF

Connections:
+1V8: Q12.3 (D)
+3V3: R66.2, U23.19 (VSYS)
+5V: R64.2, U23.1 (CSP), U23.8 (V5V)
CRX1+: J16.B11 (RX1+), U22.1 (CRX1p), U26.5 (IO4), U26.6 (NC)
CRX1-: J16.B10 (RX1-), U22.2 (CRX1n), U26.4 (IO3), U26.7 (NC)
CRX2+: J16.A11 (RX2+), U22.9 (CRX2p), U27.4 (IO3), U27.7 (NC)
CRX2-: J16.A10 (RX2-), U22.10 (CRX2n), U27.5 (IO4), U27.6 (NC)
CTX1+: C89.2, U22.4 (CTX1p)
CTX1-: C85.2, U22.5 (CTX1n)
CTX1_AC+: C89.1, J16.A2 (TX1+), U26.2 (IO2), U26.9 (NC)
CTX1_AC-: C85.1, J16.A3 (TX1-), U26.1 (IO1), U26.10 (NC)
CTX2+: C90.2, U22.6 (CTX2p)
CTX2-: C86.2, U22.7 (CTX2n)
CTX2_AC+: C90.1, J16.B2 (TX2+), U27.1 (IO1), U27.10 (NC)
CTX2_AC-: C86.1, J16.B3 (TX2-), U27.2 (IO2), U27.9 (NC)
DP_AUX+: C94.1
DP_AUX-: C95.1
DP_AUX_AC+: C94.2, R65.1, U23.36 (AUX_P)
DP_AUX_AC-: C95.2, R66.1, U23.37 (AUX_N)
DP_HPD: Q12.2 (S), RA1.D1
DP_ML0+: C80.2
DP_ML0-: C77.2
DP_ML1+: U22.19 (LnBp)
DP_ML1-: U22.18 (LnBn)
DP_ML2+: U22.21 (LnCp)
DP_ML2-: U22.20 (LnCn)
DP_ML3+: C81.2
DP_ML3-: C78.2
GND: C79.2, C82.2, C83.2, C84.2, C87.2, C91.2, C93.2, C96.2, C97.2, C98.2, C99.2, J15.3, J15.5, J15.9, J16.A1 (GND), J16.A12 (GND), J16.B1 (GND), J16.B12 (GND), J16.SH (SHIELD), R62.2, R65.2, RA1.D2, U22.29 (GND), U23.41 (VSS), U24.3 (GND), U25.3 (GND), U26.3 (GND), U26.8 (GND), U27.3 (GND), U27.8 (GND)
HPD: Q12.1 (G), TP28.1, U23.18 (P3.0/HPD)
LnA+: C80.1, U22.16 (LnAp)
LnA-: C77.1, U22.15 (LnAn)
LnD+: C81.1, U22.24 (LnDp)
LnD-: C78.1, U22.23 (LnDn)
MUX_AMSEL: U22.8 (AMSEL), U23.13 (P2.0/UV_OCP_TRIP/I2C_SCL_SCB4)
MUX_EN: R62.1, U22.17 (EN), U23.16 (P5.0/I2C_SDA_SCB1_EC)
MUX_POL: U22.3 (POL), U23.14 (P2.1/OVP_TRIP/I2C_SDA_SCB4)
unnamed: C83.1, U23.33 (VCCD)
unnamed: Q13.2 (G), Q14.4 (G), R67.2, U23.11 (VBUS_P_CTRL)
unnamed: Q13.4 (G), Q14.2 (G), R68.2, U23.12 (VBUS_C_CTRL)
SNK_S: Q13.3 (S), Q14.1 (S), R68.1
SRC_S: Q13.1 (S), Q14.3 (S), R67.1
SWCLK: J15.4, U23.2 (P1.0/SWD_CLK/I2C_CFG_EC)
SWDIO: J15.2, U23.6 (P1.4/SWD_IO/TBT_RST)
USB5V: C93.1, Q13.7 (D), Q13.8 (D), R64.1, U23.40 (CSN)
USBC2_CONN_CC1: C91.1, J16.A5 (CC1), U23.9 (CC1)
USBC2_CONN_CC2: C87.1, J16.B5 (CC2), U23.7 (CC2)
USBC2_CONN_SBU1: J16.A8 (SBU1), U23.35 (SBU1), U25.2 (IO2)
USBC2_CONN_SBU2: J16.B8 (SBU2), U23.34 (SBU2), U25.1 (IO1)
USBC2_CONN_VBUS: C96.1, C97.1, C98.1, C99.1, J16.A4 (VBUS), J16.A9 (VBUS), J16.B4 (VBUS), J16.B9 (VBUS), Q14.5 (D), Q14.6 (D), Q14.7 (D), Q14.8 (D), R69.1, U23.22 (VBUS)
USBSS_RX+: U22.28 (SSRXp)
USBSS_RX-: U22.27 (SSRXn)
USBSS_TX+: U22.26 (SSTXp)
USBSS_TX-: U22.25 (SSTXn)
USB_D+: J16.A6 (D+), J16.B6 (D+), U24.2 (IO2)
USB_D-: J16.A7 (D-), J16.B7 (D-), U24.1 (IO1)
VBUS: Q13.5 (D), Q13.6 (D), R69.2
VDDD: C82.1, C84.1, J15.1, R63.1, U22.22 (VCC), U23.31 (VDDD), U23.32 (VDDIO)
~RESET: C79.1, J15.10, R63.2, U23.10 (XRES)

Notes on the sheet:
Replace 390pF to 5.1kOhm if USB-PD controller were not used.
Short this if USB-PD controller were not used.
Comaptible part : TPD4E02B04
