Nkyoku/phoenix-pcb/Processor.sch

## KiCad design Processor.sch (2020-08-01)

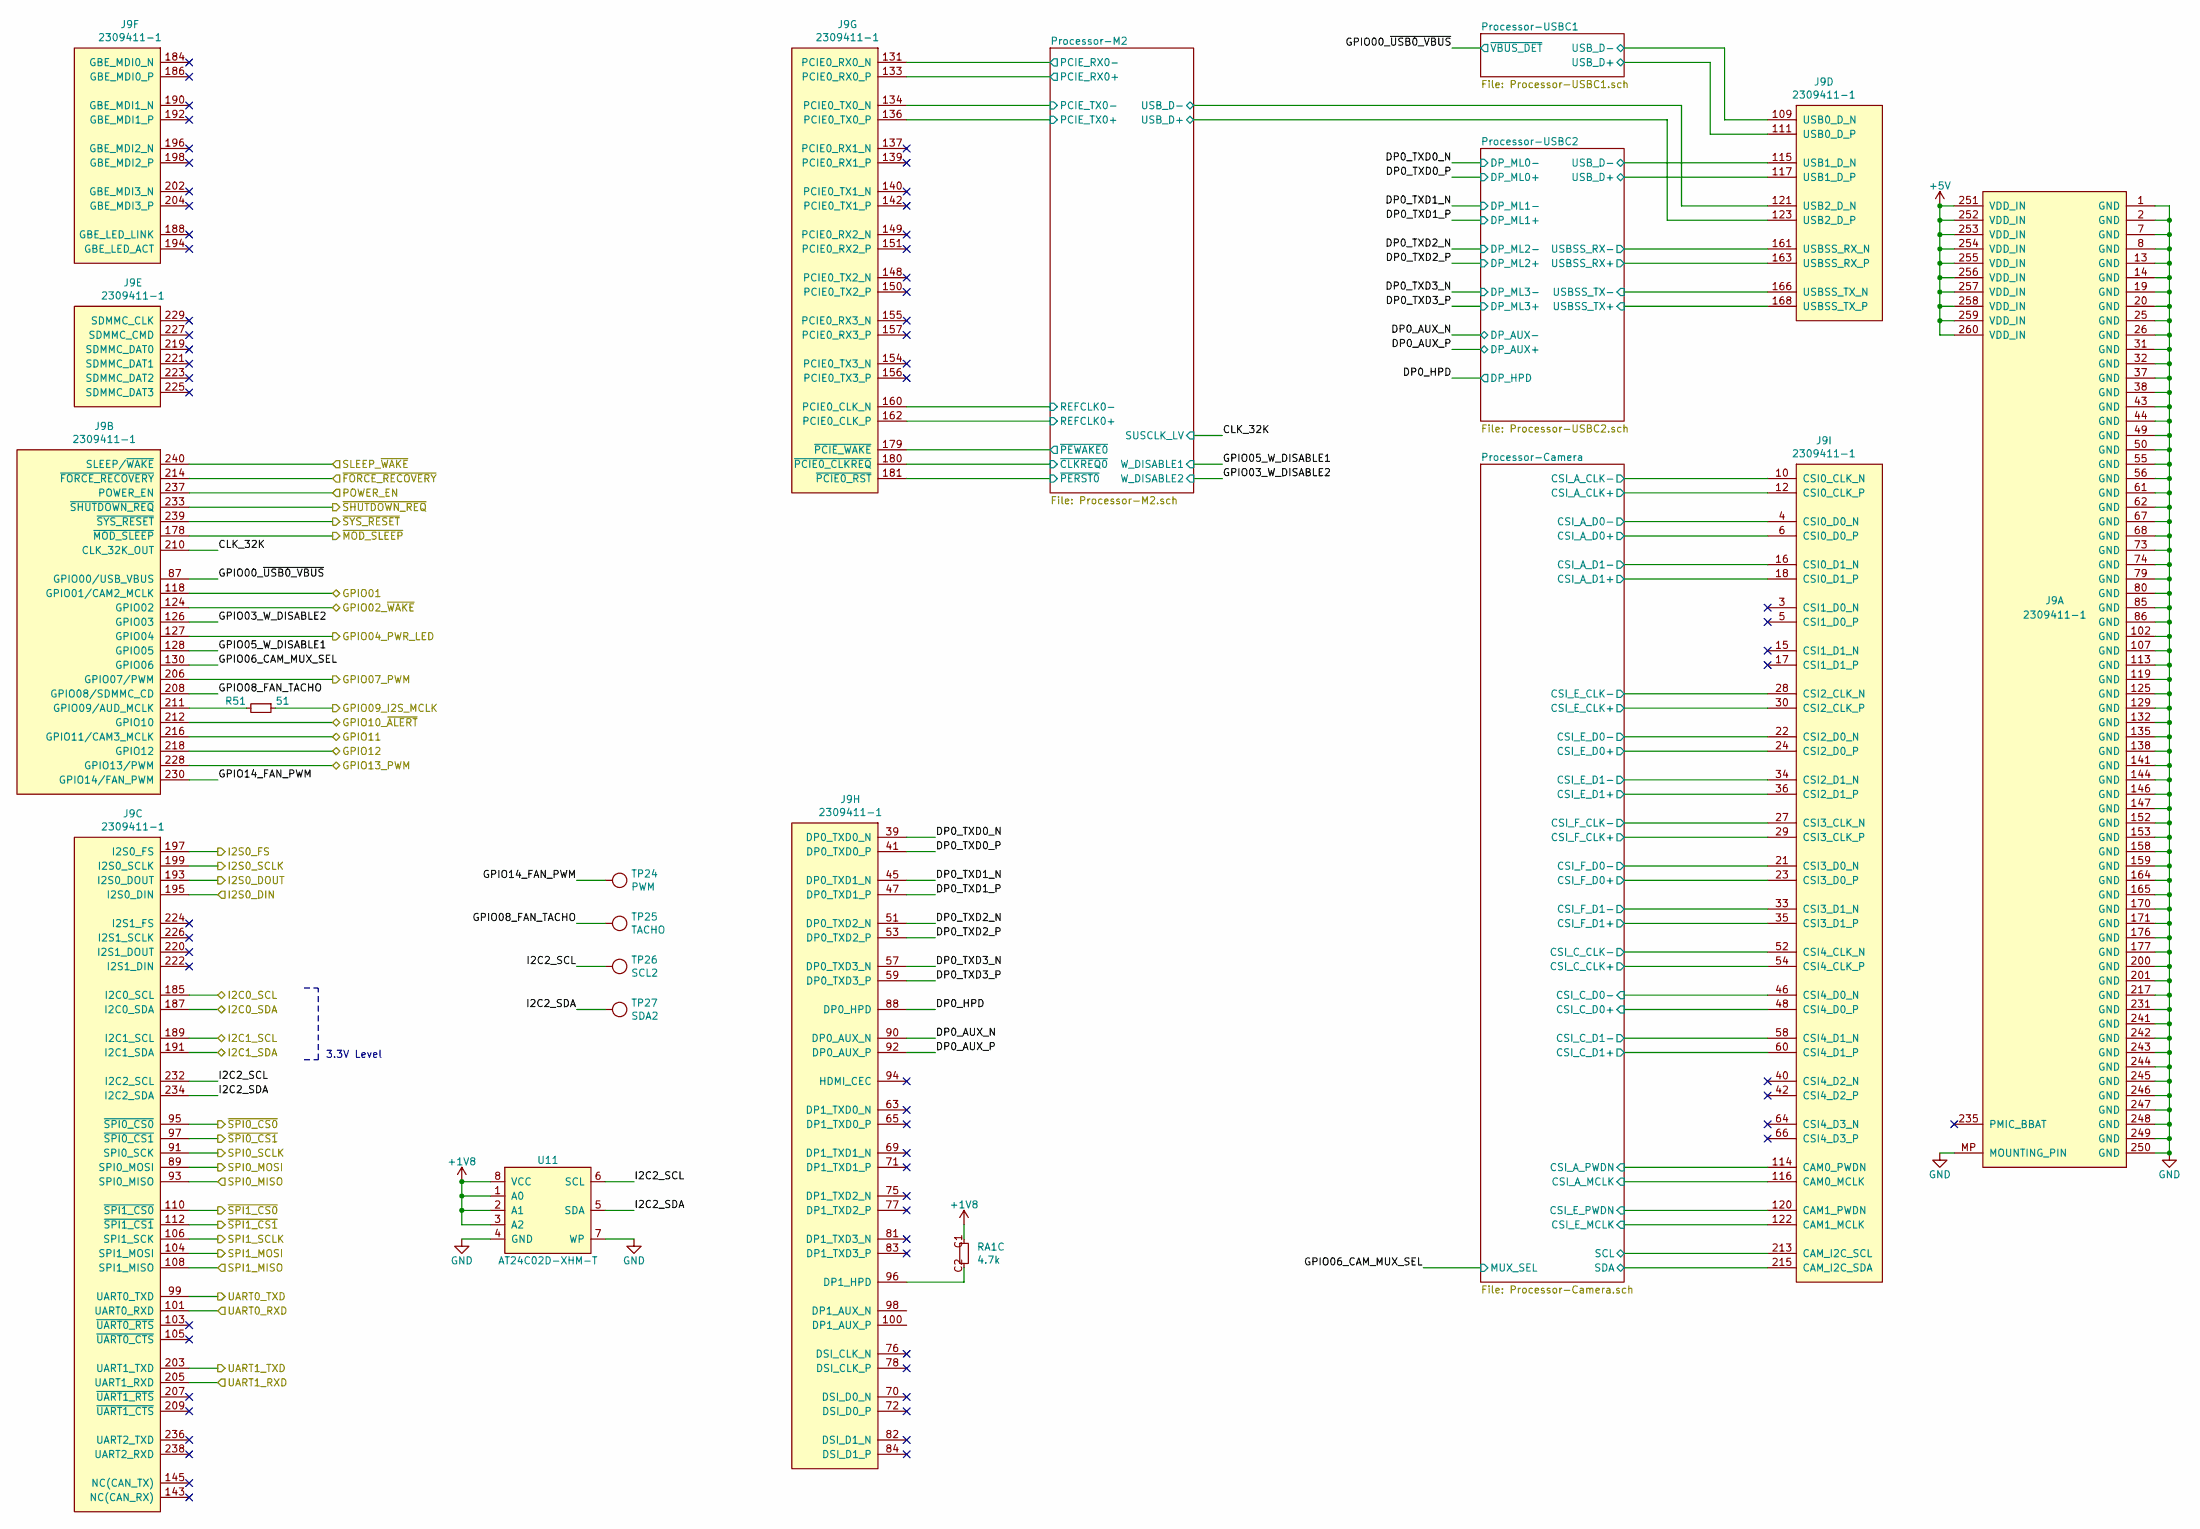
[picture p47: schematic Processor.sch]

Parts:
J9: 2309411-1; 2309411-x; PartName 2309411-1
R51: 51; R_CHIP_1005_Hand_NoSilk; PartName RK73B1ETTP510J
RA1: 4.7k; R_CHIP_4x1005_CONCAVE; PartName EXB-N8V472JX
TP24: PWM; TP_C1.0
TP25: TACHO; TP_C1.0
TP26: SCL2; TP_C1.0
TP27: SDA2; TP_C1.0
U11: AT24C02D-XHM-T; TSSOP8_W4.4; PartName AT24C02D-XHM-T

Connections:
+1V8: RA1.C1, U11.1 (A0), U11.2 (A1), U11.3 (A2), U11.8 (VCC)
+5V: J9.251 (VDD_IN), J9.252 (VDD_IN), J9.253 (VDD_IN), J9.254 (VDD_IN), J9.255 (VDD_IN), J9.256 (VDD_IN), J9.257 (VDD_IN), J9.258 (VDD_IN), J9.259 (VDD_IN), J9.260 (VDD_IN)
CLK_32K: J9.210 (CLK_32K_OUT)
CSI_A_CLK+: J9.12 (CSI0_CLK_P)
CSI_A_CLK-: J9.10 (CSI0_CLK_N)
CSI_A_D0+: J9.6 (CSI0_D0_P)
CSI_A_D0-: J9.4 (CSI0_D0_N)
CSI_A_D1+: J9.18 (CSI0_D1_P)
CSI_A_D1-: J9.16 (CSI0_D1_N)
CSI_A_MCLK: J9.116 (CAM0_MCLK)
CSI_A_PWDN: J9.114 (CAM0_PWDN)
CSI_C_CLK+: J9.54 (CSI4_CLK_P)
CSI_C_CLK-: J9.52 (CSI4_CLK_N)
CSI_C_D0+: J9.48 (CSI4_D0_P)
CSI_C_D0-: J9.46 (CSI4_D0_N)
CSI_C_D1+: J9.60 (CSI4_D1_P)
CSI_C_D1-: J9.58 (CSI4_D1_N)
CSI_E_CLK+: J9.30 (CSI2_CLK_P)
CSI_E_CLK-: J9.28 (CSI2_CLK_N)
CSI_E_D0+: J9.24 (CSI2_D0_P)
CSI_E_D0-: J9.22 (CSI2_D0_N)
CSI_E_D1+: J9.36 (CSI2_D1_P)
CSI_E_D1-: J9.34 (CSI2_D1_N)
CSI_E_MCLK: J9.122 (CAM1_MCLK)
CSI_E_PWDN: J9.120 (CAM1_PWDN)
CSI_F_CLK+: J9.29 (CSI3_CLK_P)
CSI_F_CLK-: J9.27 (CSI3_CLK_N)
CSI_F_D0+: J9.23 (CSI3_D0_P)
CSI_F_D0-: J9.21 (CSI3_D0_N)
CSI_F_D1+: J9.35 (CSI3_D1_P)
CSI_F_D1-: J9.33 (CSI3_D1_N)
DP0_AUX_N: J9.90 (DP0_AUX_N)
DP0_AUX_P: J9.92 (DP0_AUX_P)
DP0_HPD: J9.88 (DP0_HPD)
DP0_TXD0_N: J9.39 (DP0_TXD0_N)
DP0_TXD0_P: J9.41 (DP0_TXD0_P)
DP0_TXD1_N: J9.45 (DP0_TXD1_N)
DP0_TXD1_P: J9.47 (DP0_TXD1_P)
DP0_TXD2_N: J9.51 (DP0_TXD2_N)
DP0_TXD2_P: J9.53 (DP0_TXD2_P)
DP0_TXD3_N: J9.57 (DP0_TXD3_N)
DP0_TXD3_P: J9.59 (DP0_TXD3_P)
GND: J9.1 (GND), J9.2 (GND), J9.7 (GND), J9.8 (GND), J9.13 (GND), J9.14 (GND), J9.19 (GND), J9.20 (GND), J9.25 (GND), J9.26 (GND), J9.31 (GND), J9.32 (GND), J9.37 (GND), J9.38 (GND), J9.43 (GND), J9.44 (GND), J9.49 (GND), J9.50 (GND), J9.55 (GND), J9.56 (GND), J9.61 (GND), J9.62 (GND), J9.67 (GND), J9.68 (GND), J9.73 (GND), J9.74 (GND), J9.79 (GND), J9.80 (GND), J9.85 (GND), J9.86 (GND), J9.102 (GND), J9.107 (GND), J9.113 (GND), J9.119 (GND), J9.125 (GND), J9.129 (GND), J9.132 (GND), J9.135 (GND), J9.138 (GND), J9.141 (GND), J9.144 (GND), J9.146 (GND), J9.147 (GND), J9.152 (GND), J9.153 (GND), J9.158 (GND), J9.159 (GND), J9.164 (GND), J9.165 (GND), J9.170 (GND), J9.171 (GND), J9.176 (GND), J9.177 (GND), J9.200 (GND), J9.201 (GND), J9.217 (GND), J9.231 (GND), J9.241 (GND), J9.242 (GND), J9.243 (GND), J9.244 (GND), J9.245 (GND), J9.246 (GND), J9.247 (GND), J9.248 (GND), J9.249 (GND), J9.250 (GND), J9.MP (MOUNTING_PIN), U11.4 (GND), U11.7 (WP)
GPIO00_~USB0_VBUS: J9.87 (GPIO00/USB_VBUS)
GPIO01: J9.118 (GPIO01/CAM2_MCLK)
GPIO02_~WAKE: J9.124 (GPIO02)
GPIO03_W_DISABLE2: J9.126 (GPIO03)
GPIO04_PWR_LED: J9.127 (GPIO04)
GPIO05_W_DISABLE1: J9.128 (GPIO05)
GPIO06_CAM_MUX_SEL: J9.130 (GPIO06)
GPIO07_PWM: J9.206 (GPIO07/PWM)
GPIO08_FAN_TACHO: J9.208 (GPIO08/SDMMC_CD), TP25.1
GPIO09_I2S_MCLK: R51.1
GPIO10_~ALERT: J9.212 (GPIO10)
GPIO11: J9.216 (GPIO11/CAM3_MCLK)
GPIO12: J9.218 (GPIO12)
GPIO13_PWM: J9.228 (GPIO13/PWM)
GPIO14_FAN_PWM: J9.230 (GPIO14/FAN_PWM), TP24.1
I2C0_SCL: J9.185 (I2C0_SCL)
I2C0_SDA: J9.187 (I2C0_SDA)
I2C1_SCL: J9.189 (I2C1_SCL)
I2C1_SDA: J9.191 (I2C1_SDA)
I2C2_SCL: J9.232 (I2C2_SCL), TP26.1, U11.6 (SCL)
I2C2_SDA: J9.234 (I2C2_SDA), TP27.1, U11.5 (SDA)
I2S0_DIN: J9.195 (I2S0_DIN)
I2S0_DOUT: J9.193 (I2S0_DOUT)
I2S0_FS: J9.197 (I2S0_FS)
I2S0_SCLK: J9.199 (I2S0_SCLK)
unnamed: J9.96 (DP1_HPD), RA1.C2
unnamed: J9.211 (GPIO09/AUD_MCLK), R51.2
PCIE_RX0+: J9.133 (PCIE0_RX0_P)
PCIE_RX0-: J9.131 (PCIE0_RX0_N)
PCIE_TX0+: J9.136 (PCIE0_TX0_P)
PCIE_TX0-: J9.134 (PCIE0_TX0_N)
POWER_EN: J9.237 (POWER_EN)
REFCLK0+: J9.162 (PCIE0_CLK_P)
REFCLK0-: J9.160 (PCIE0_CLK_N)
SCL: J9.213 (CAM_I2C_SCL)
SDA: J9.215 (CAM_I2C_SDA)
SLEEP_~WAKE: J9.240 (SLEEP/~WAKE)
SPI0_MISO: J9.93 (SPI0_MISO)
SPI0_MOSI: J9.89 (SPI0_MOSI)
SPI0_SCLK: J9.91 (SPI0_SCK)
SPI1_MISO: J9.108 (SPI1_MISO)
SPI1_MOSI: J9.104 (SPI1_MOSI)
SPI1_SCLK: J9.106 (SPI1_SCK)
UART0_RXD: J9.101 (UART0_RXD)
UART0_TXD: J9.99 (UART0_TXD)
UART1_RXD: J9.205 (UART1_RXD)
UART1_TXD: J9.203 (UART1_TXD)
USBSS_RX+: J9.163 (USBSS_RX_P)
USBSS_RX-: J9.161 (USBSS_RX_N)
USBSS_TX+: J9.168 (USBSS_TX_P)
USBSS_TX-: J9.166 (USBSS_TX_N)
USB_D+: J9.111 (USB0_D_P), J9.117 (USB1_D_P), J9.123 (USB2_D_P)
USB_D-: J9.109 (USB0_D_N), J9.115 (USB1_D_N), J9.121 (USB2_D_N)
~CLKREQ0: J9.180 (~PCIE0_CLKREQ)
~FORCE_RECOVERY: J9.214 (~FORCE_RECOVERY)
~MOD_SLEEP: J9.178 (~MOD_SLEEP)
~PERST0: J9.181 (~PCIE0_RST)
~PEWAKE0: J9.179 (~PCIE_WAKE)
~SHUTDOWN_REQ: J9.233 (~SHUTDOWN_REQ)
~SPI0_CS0: J9.95 (~SPI0_CS0)
~SPI0_CS1: J9.97 (~SPI0_CS1)
~SPI1_CS0: J9.110 (~SPI1_CS0)
~SPI1_CS1: J9.112 (~SPI1_CS1)
~SYS_RESET: J9.239 (~SYS_RESET)

Notes on the sheet:
3.3V Level
