Nkyoku/phoenix-pcb/Sensor.sch

## KiCad design Sensor.sch (2020-08-01)

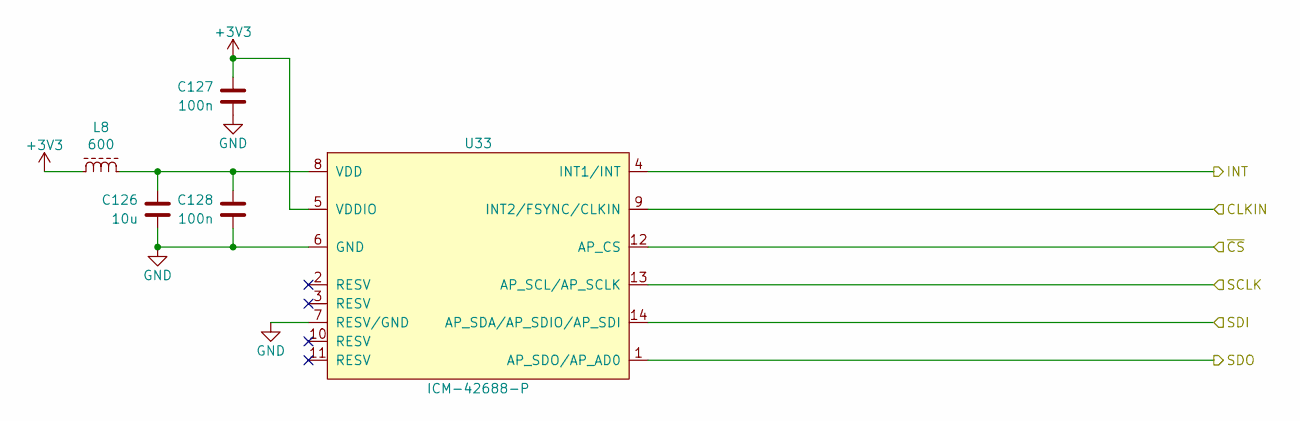
[picture p48: schematic Sensor.sch]

Parts:
C126: 10u; C_CHIP_1005_Hand_NoSilk; PartName GRJ155R60J106ME11D
C127, C128: 100n; C_CHIP_1005_Hand_NoSilk; PartName GRM155R71H104ME14D
L8: 600; L_CHIP_1005_Hand_NoSilk; PartName BLM15PX601SN1D
U33: ICM-42688-P; LGA14_3.0x2.5_P0.5; PartName ICM-42688-P

Connections:
+3V3: C127.1, L8.1, U33.5 (VDDIO)
CLKIN: U33.9 (INT2/FSYNC/CLKIN)
GND: C126.2, C127.2, C128.2, U33.6 (GND), U33.7 (RESV/GND)
INT: U33.4 (INT1/INT)
unnamed: C126.1, C128.1, L8.2, U33.8 (VDD)
SCLK: U33.13 (AP_SCL/AP_SCLK)
SDI: U33.14 (AP_SDA/AP_SDIO/AP_SDI)
SDO: U33.1 (AP_SDO/AP_AD0)
~CS: U33.12 (AP_CS)
