Nkyoku/phoenix-pcb/(commit log)

2020-05-29 add DVT R1
    [ADC1.sch, ADC2.sch, Extension.sch, FPGA-Memory.sch, FPGA-Power.sch, FPGA.sch, Interface1.sch, Interface2.sch]
2020-08-01 SBUにTVSダイオードを追加
    [ADC1.sch, ADC2.sch, FPGA-Memory.sch, FPGA-Power.sch, FPGA.sch, Interface1.sch, Interface2.sch, JTAG.sch]
2021-03-21 FPGA_INTをFPGA_MODEに変更
    [FPGA-Memory.sch, FPGA.sch, Interface2.sch, Phoenix.sch]
2021-03-21 回路図を追加
2021-03-21 Readmeにリンクを追加
